xforever1313/commutertrackingsensornet/doc/pi_pinout.jpeg

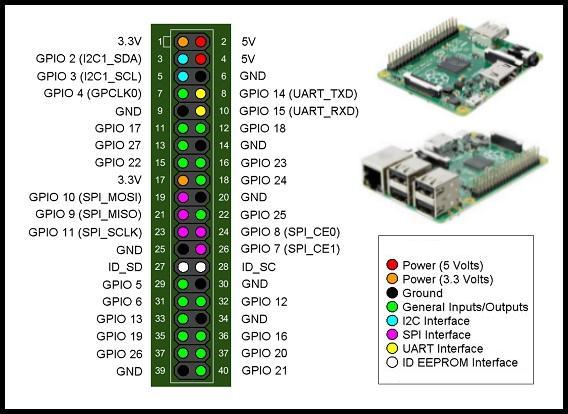
doc/pi_pinout.jpeg
