xforever1313/commutertrackingsensornet/README.md

# Commuter Tracking Sensor Net #

A wireless sensor network that will utilize computer vision and mesh networking will be used to track the usage of the Lehigh Valley trail. The network will be comprised of a series of modules that use image sensors to recognize commuters and their modes of transportation. Additionally these modules will communicate with one another to determine which entry and exit points commuters are using to access the trail. The network will have a gateway node that allows the data to be back-hauled to the internet. This data will then be stored via cloud storage and accessible via a web interface.

For more information, look in doc/CTSN_Final_report.pdf in this repo.

You can also visit our website: http://ctsn.shendrick.net/

Wiki with more information about how to build and configure things: https://bitbucket.org/xforever1313/commutertrackingsensornet/wiki/Home

You can also clone the wiki: git clone https://bitbucket.org/xforever1313/commutertrackingsensornet.git/wiki

If you are reading this from GitHub, please note that GitHub is only mirror that has the latest stable code that passed a nightly.  To view the working codebase, go to our BitBucket here: https://bitbucket.org/xforever1313/commutertrackingsensornet/
