xforever1313/commutertrackingsensornet/gateway/etc/readme.txt

Contains configurations for the raspberry Pi
