xforever1313/commutertrackingsensornet/CEwebsite/public/docs/mcu_camera.pdf

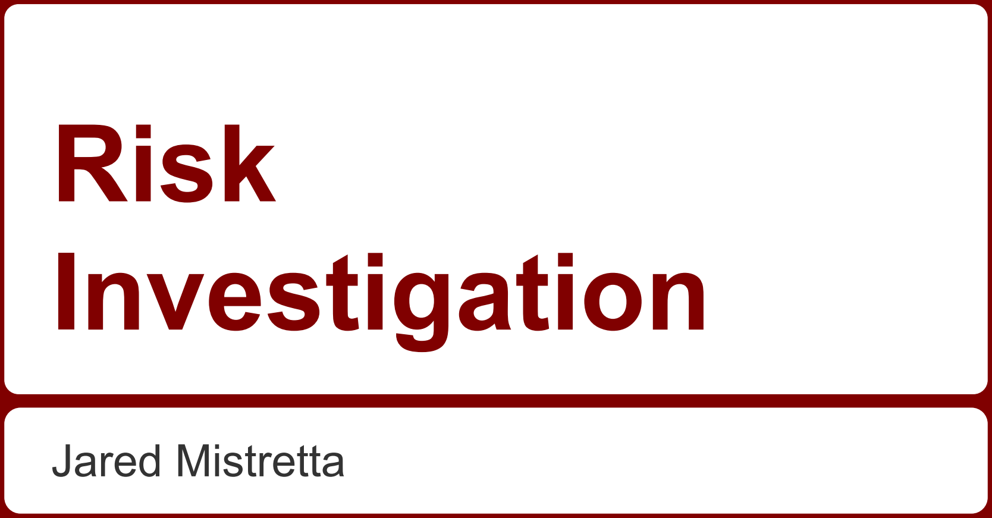
[picture p63: figure]
Risk Investigation; Jared Mistretta

### MCU and Camera Module

The MCU is the “brain” of the project. It serves as the main computational component as well as the controller for the peripheral and sub systems. We require the MCU to provide computer vision services as well.

The camera module will provide the visual data necessary for performing the CV.

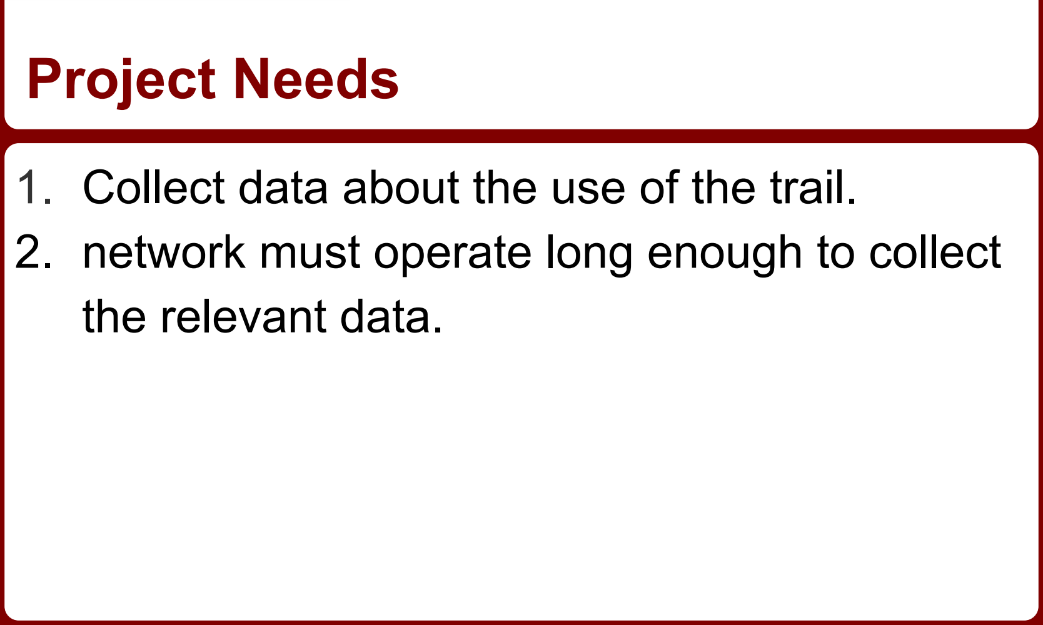
[picture p64: figure]
Project Needs; the relevant data.

1. Collect data about the use of the trail.
2. network must operate long enough to collect

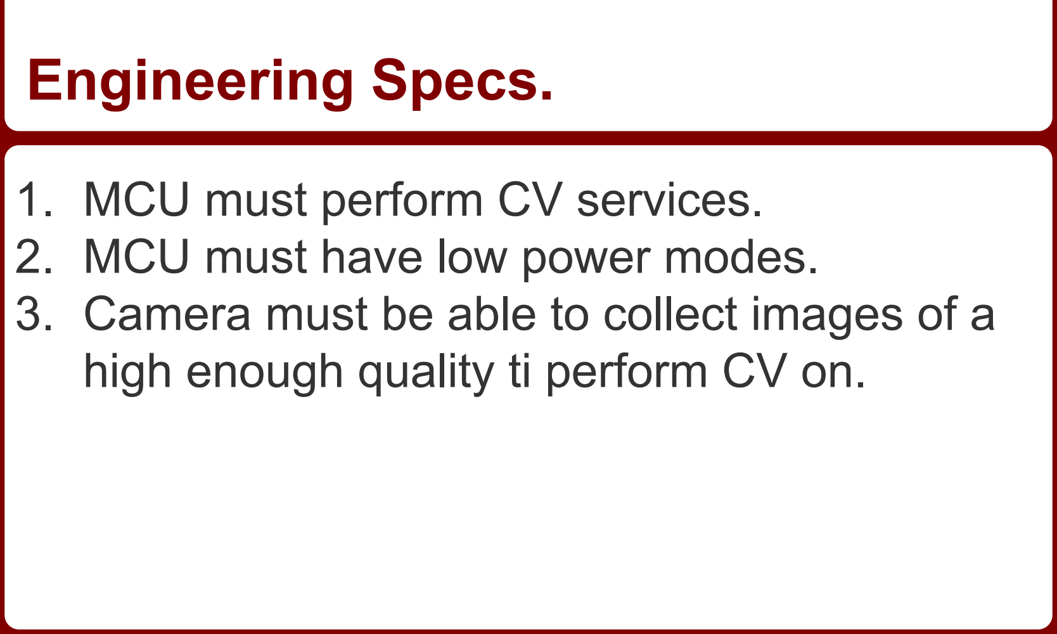
[picture p65: figure]
Engineering Specs.; 1. MCU must perform CV services. 2. MCU must have low power modes.; high enough quality ti perform CV on.

3. Camera must be able to collect images of a

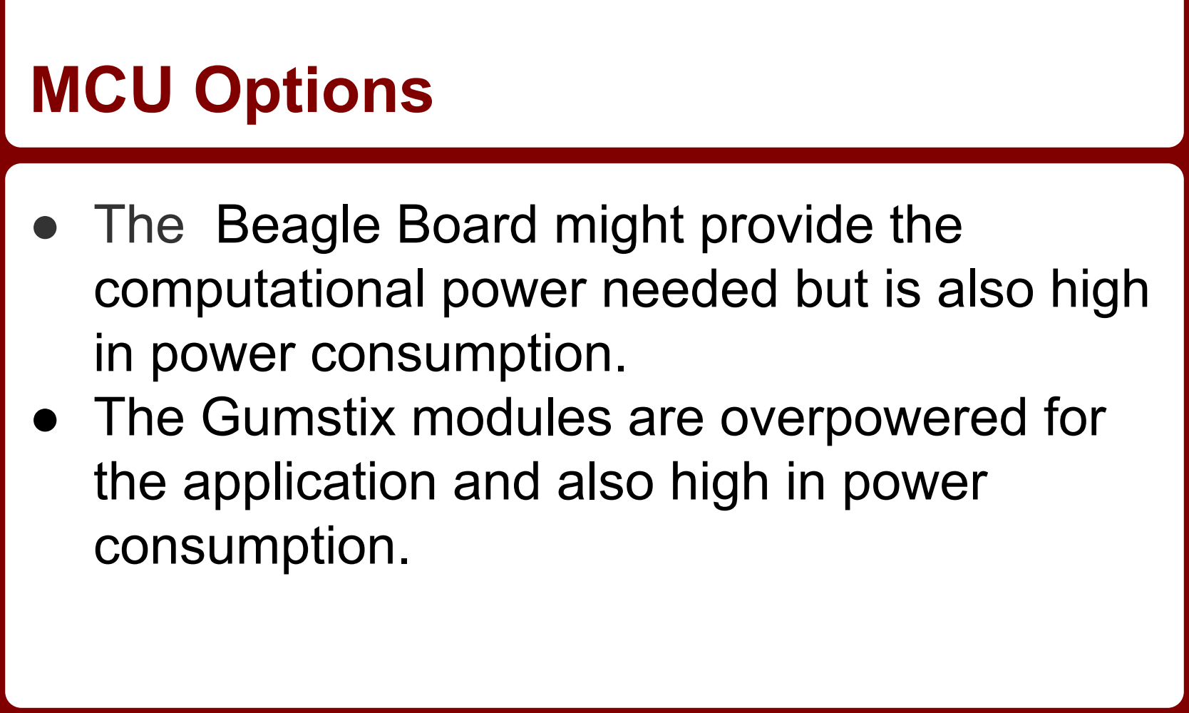
[picture p66: figure]
MCU Options; ● The Beagle Board might provide the; in power consumption.; the application and also high in power consumption.

computational power needed but is also high

- The Gumstix modules are overpowered for

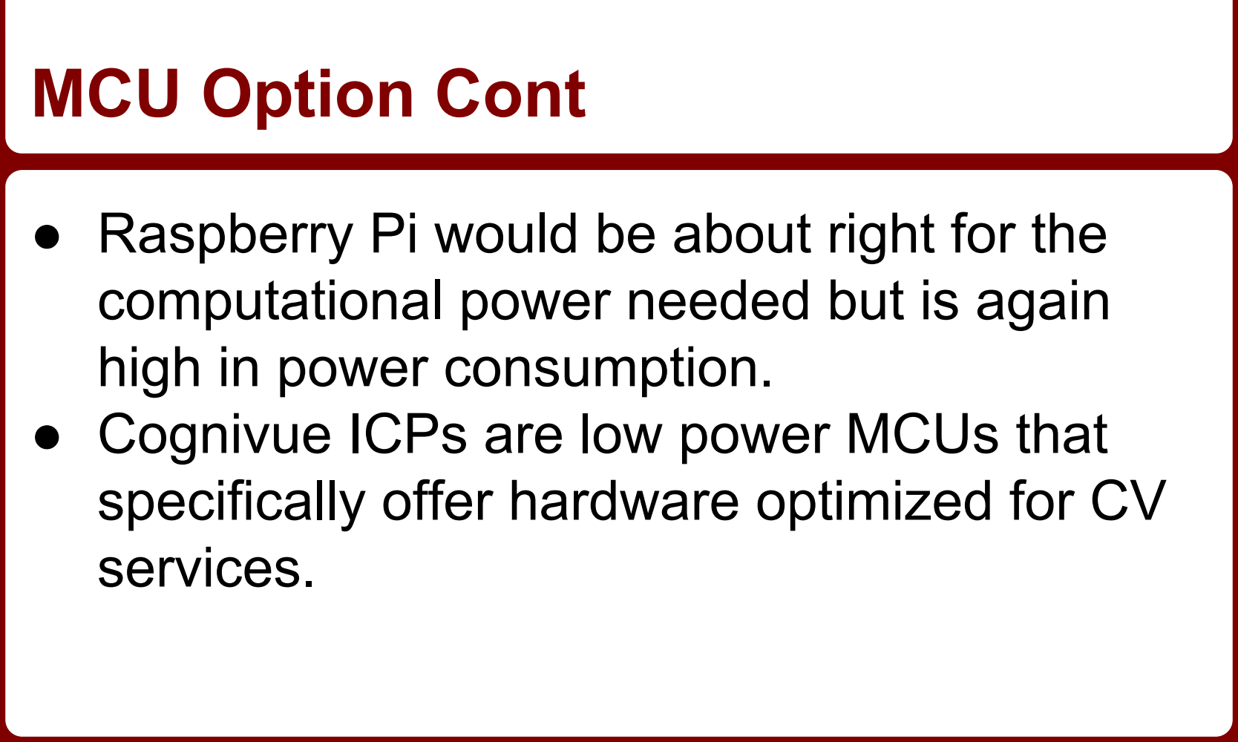
[picture p67: figure]
MCU Option Cont; computational power needed but is again high in power consumption. ● Cognivue ICPs are low power MCUs that; services.

- Raspberry Pi would be about right for the

specifically offer hardware optimized for CV

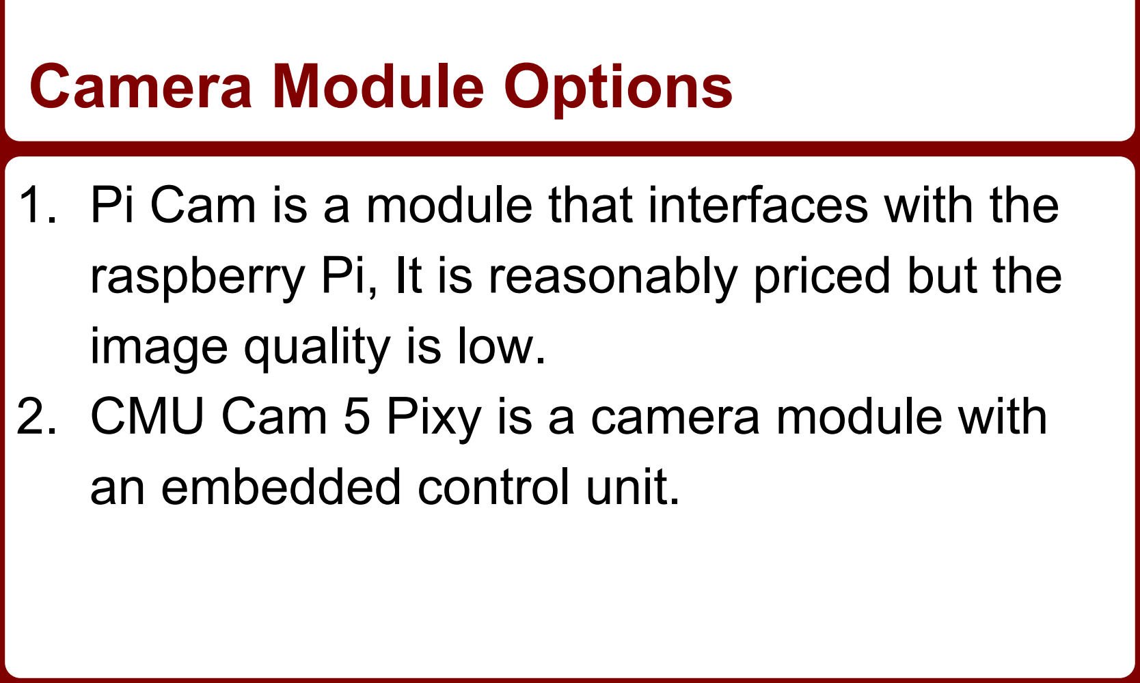
[picture p68: figure]
Camera Module Options; image quality is low.; an embedded control unit.

1. Pi Cam is a module that interfaces with the raspberry Pi, It is reasonably priced but the
2. CMU Cam 5 Pixy is a camera module with

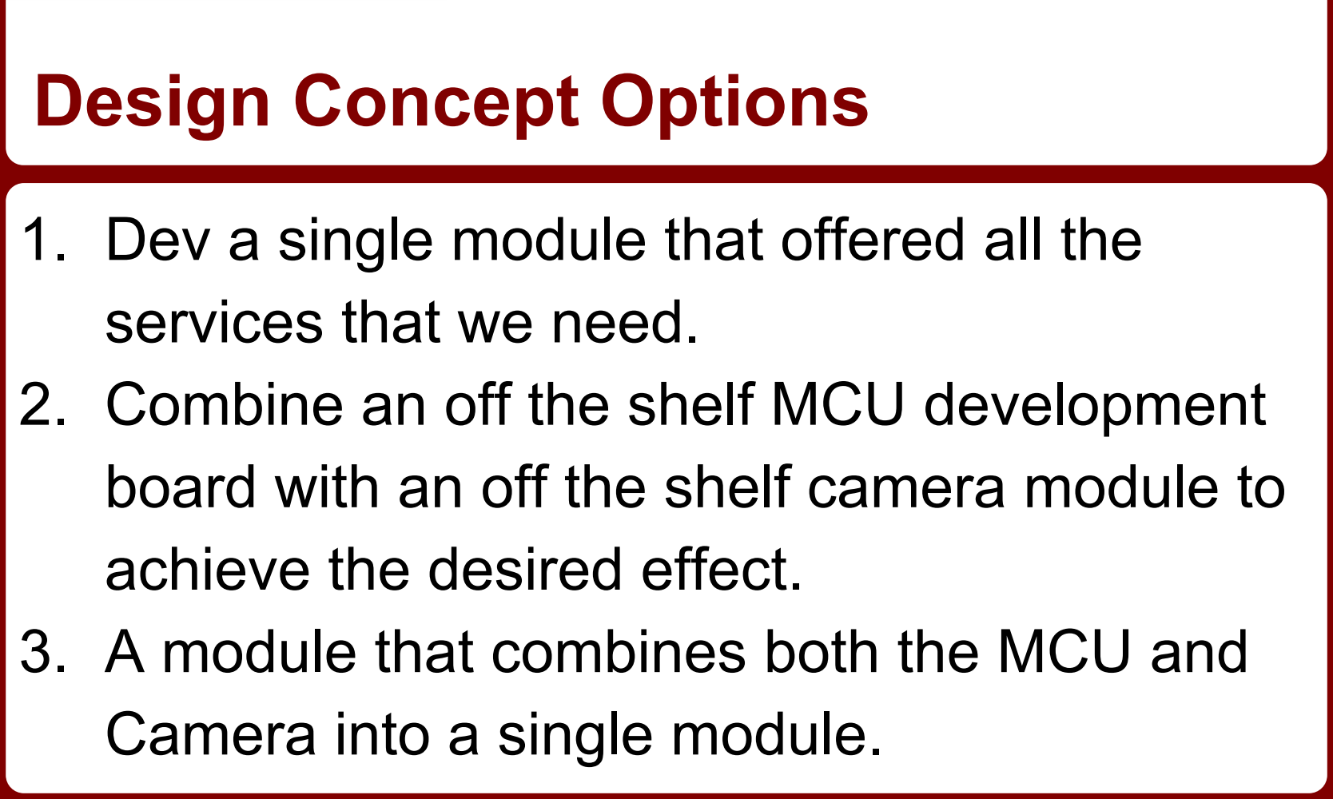
[picture p69: figure]
Design Concept Options; services that we need.; achieve the desired effect.; Camera into a single module.

1. Dev a single module that offered all the
2. Combine an off the shelf MCU development board with an off the shelf camera module to
3. A module that combines both the MCU and


CMUCam 5 Pixy

- Processor: NXP LPC4330, 204 MHz, dual core
- Image sensor: Omnivision OV9715, 1/4", 1280x800
- Lens field-of-view: 75 degrees horizontal, 47 degrees vertical
- Lens type: standard M12 (several different types available)
- Power consumption: 140 mA typical
- Power input: USB input (5V) or unregulated input (6V to 10V)
- RAM: 264K bytes
- Flash: 1M bytes
- Available data outputs: UART serial, SPI, I2C, USB, digital, analog
- Dimensions: 2.1" x 2.0" x 1.4
- Weight: 27 grams

### Technical Specs

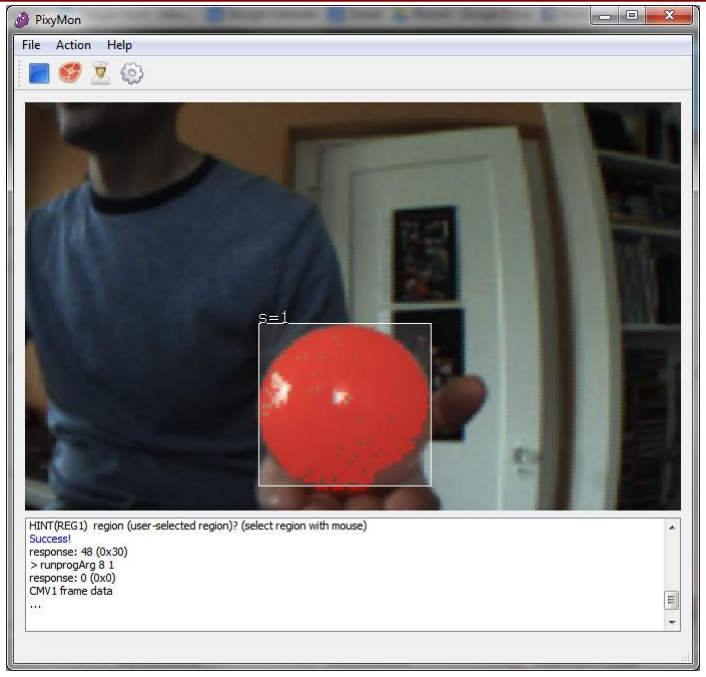
[picture p70: figure]

Computer Vision Tracking

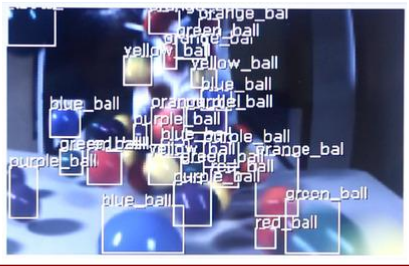
[picture p71: figure]

High Density Tracking
