xforever1313/commutertrackingsensornet/CEwebsite/public/docs/weekly11.pdf

# Commuter Tracking Sensor Network

Weekly Report November 9, 2014

Team Members:
Alex Sarra (ags7798@rit.edu) Seth Hendrick (srh7240@rit.edu) Jared Mistretta (jxm6666@rit.edu)

Other Collaborators:
Professor Wagner (mjwgse@rit.edu) (585) 475-5289 Nicholas Conn (nxc9827@rit.edu) Graduate Student Jared Stroud (jaredestroud@gmail.com) Security Major Stanley Chan (sxc4244@rit.edu) Security Major

Project Website:
Navigate to Google Drive Share (https://drive.google.com/folderview?id=0B4QNLbh8wjupal9wZDNRWTlsOEU&usp=sharing)

## Updated Milestone Chart

Milestone | Team Member in Charge | Modified Completion Date | Original Completion Date | Comments
1. Contact Monroe County Discuss deployment options for sensor nodes. | Jared | 11/11/2014 | 10/27/2014 | Pushed it back to deployment approach time.
2. Networking Architecture Configuration and Testing | | 10/13/2014 | 6/15/2014
2.1 Configure XBees for DigiMesh and have them communicating in close proximity | Seth, Jared | 10/16/2014 | 6/1/2014 | Done for now. Some additional configuration changes might need to be updated as more testing is done.
2.2 Range Test | Seth, Jared | 11/10/2014 | 6/9/2014 | Will be completed Monday or Wednesday. Rained out, and pushed back.
2.3 Smallscale trail deployment | Seth, Jared | 11/14/2014 | 6/15/2014 | Dependent on 2.1 and 2.2 and 5.2
3. Windbelt power module design | | 10/2/2014 | 6/18/2014

3.1 Breadboard
prototyping

Alex,
Jared | 11/12/2014 | 6/1/2014

Secondary Boost Converter
has been determined
inadequate for our power
needs. An EVM for the
secondary boost converter will need to be ordered soon to prototype with. Buck converter is pushing enough current for low power mode on the radio modules. To remedy this, we will need higherpower
inductors, which will be picked up soon to prototype with. The coilcraft ones on the PCB that was ordered will
mostcertainly be able to
transfer enough power
through the BQ module.
3.2 PCB design | Alex | 11/12/2014 | 6/10/2014 | COMPLETE (for now). The PCB design version 1 is complete and ordered. Continuing development with a version two that will allow us to slightly change the resistor dividers for OV and UV networks. For now, this is complete.
3.3 Ship design for stamping | Alex | 11/5/2014 | 6/18/2014 | COMPLETE First iteration of design is ordered. Parts for the board are known, and will be ordered within the weekend.

3.4 Spice Transient Analysis | Alex, Jared | 10/20/2014 | 9/22/2014 | COMPLETE Transient analysis is complete for both the buck and secondary boost converter. Levels are attainable for both the 6-10V unregulated (Pixy) and 3-3.3V regulated (XBee) ranges per transient simulations produced by TI's WEBDESIGN application.
4. Windbelt power module construction and testing | | 10/22/2014 | 6/30/2014
4.1 Solder on components | Alex | 11/21/2014 | 6/29/2014 | The PCB will be back by the 18th, which will give us enough time to solder on components.
4.2 Continuity tests | Alex | 11/24/2014 | 6/30/2014 | Dependent on 4.1, which should be met in time.
5. Server/Gateway setup | Seth | 10/10/2014 | 7/1/2014 | The server is a Raspberry Pi located at ctsn.student.rit.edu.
5.1 Install software (Django, Apache, etc.) | Seth | 6/21/2014 | 6/17/2014 | COMPLETE Apache, Django, MariaDB are installed and ready to go.
5.2 Interface XBee with Pi | Seth | 10/31/2014 | 7/1/2014 | COMPLETE Are able to Tx and Rx with the XBees between two pis.
5.3 Install and configure fail2ban | Seth | 9/1/2014 | 6/21/2014 | COMPLETE

6. Server/Gateway testing | | 10/12/2014 | 7/1/2014 | COMPLETE
6.1 Disable root login test | Seth | 6/21/2014 | 6/16/2014 | COMPLETE Done automatically when Raspbian was updated
6.2 Set the SSH port to a nonstandard port test | Seth | 6/21/2014 | 6/17/2014 | COMPLETE SSH Port is set to 1315, not the default port of 22
6.3 Disable password login test must log in with SSH key | Alex, Jared, Seth | 9/5/2014 | 6/21/2014 | COMPLETE SSH Keys are required to login to the server via SSH
6.4 White Hat Hacker Test | Seth | 10/12/2014 | 6/21/2014 | COMPLETE. They could not access the server via ssh, get a root shell, or access the database directly. Jared (security major) will be providing a formal report of the pen test results. We will be able to fortify security based on the results.
6.5 Ping disabled test | Seth, Security Majors | 10/31/2014 | 6/21/2014 | DEFERRED While the server is on the RIT campus, this is completed since outsiders can not ping rit.edu. If the server moves off campus for whatever reason, this will need to be revisited
7. Sensor hardware testing and integration | | 10/31/2014 | 7/11/2014

7.1 Begin playing with Pixy Cam in USB tethered mode | Jared, Alex, Seth | 7/11/2014 | 5/1/2014 | COMPLETE We've all experimented and interfaced with the PixyCam now, and familiarized ourselves with its basic operation.
7.2 Interface Pixy Cam with an XBee | Seth | 11/14/2014 | 6/22/2014 | Now that the "algorithm" is figured out after doing 5.2, this shouldn't take too long to plug into the Pixy Cam's firmware
7.3 Integrate with existing power module | Jared, Alex | 11/12/2014 | 7/11/2014 | Dependent on 3.1 and ordering and testing the EVM for the secondary boost converter.
8. Sensor Enclosure Design / Testing | | 11/14/2014 | 8/7/2014
8.1 Use CAD tools to design sensor enclosure | Jared | 11/14/2014 | 7/1/2014 | This is no longer blocked. This process can continue taking into account the largest board size available through the evaluation version of EAGLE. Jared currently working on CV, which is a higher priority task.
8.2 Use 3D printer to print the enclosures | Jared | 11/14/2014 | 7/15/2014 | 8.1 Must be done first
8.3 Test (See Gantt Chart) | Jared | 11/14/2014 | 8/7/2014 | Dependent on 8.2

9. Windbelt Testing (See Gantt Chart) | Alex | 11/11/2014 | 5/27/2014 | This can be completed at any point. Most likely, enough bandwidth will be available early this week. Up to now, a waveform generator that can provide the same Vave AC and the same frequency has been utilized.
10. Sensor Software Identify targets | | 10/24/2014 | 9/1/2014
10.1 Code Review for Pixy Software | Alex, Seth, Jared | 9/8/2014 | 9/8/2014 | COMPLETE Code review was completed. Information was documented regarding each file's contents.
10.2 Compile GCC version of Pixy software and note differences | | | 9/8/2014 | No longer a requirement. Keil will work just fine.
10.3 Train camera for identifying walkers, bikers, and horses | Jared | 11/14/2014 | 8/1/2014 | Attempting to get LibCCV compiling for the Pixy Cam. At the moment, it compiles, but it is having trouble linking in.
10.4 Train camera to figure out what direction the target is going | Jared | 11/14/2014 | 9/1/2014 | 10.3 and 10.4 are not dependent on one another. These two tasks should be completed in parallel.
11. Database Creation | | 9/23/2014 | 9/14/2014 | COMPLETE

11.1 Create mysql or mariadb database so data from trail can be saved to it | Seth | 11/5/2014 | 9/5/2014 | COMPLETE
12. Website Creation | | 9/26/2014 | 9/28/2014 | COMPLETE. Final website is located at https://ctsn.student.rit.edu
12.1 Create status webpage, hosted somewhere else | Seth | 9/5/2014 | 9/5/2014 | COMPLETE Status webpage that pings the gateway is functional. Its currently hosted on one of Seth's pis, located at http://people.rit.edu/~srh7240/ctsn_status .
12.2 Create web front end | Seth, Alex | 10/31/2014 | 9/14/2014 | Front end is COMPLETE. Data results from the CV algorithms must be identified and linked to the database to render on the webpage.
12.3 Link website to database | Seth | 11/5/2014 | 9/21/2014 | COMPLETE Website now no longer uses hardcoded values to display results.
13. Website Testing (See Gantt Chart) | Team | 10/12/2014 | 10/4/2014 | COMPLETE. Jared (security major) will be providing a formal report of the pen test results. We will be able to fortify security based on the results.
14. Target Data Communication | | 11/21/2014 | 10/5/2014

14.1 Sensors communicate target data with each other | Seth, Alex | 11/21/2014 | 10/4/2014 | Dependent on 7.2
14.2 Sensors can communicate and write target data to database | Seth | 11/21/2014 | 10/5/2014 | Gateway side is done. Only need to do the Pixy Cam side.
15. Computer Vision Testing (See Gantt Chart) | Alex, Seth | 11/1/2014 | 10/28/2014 | Dependent on 10.3 and 10.4
16. Deployment | | 11/17/2014 | 11/9/2014
16.1 Deploy nodes on trail | Team | 11/21/2014 | 11/5/2014
16.2 Activate website | Team | 9/27/2014 | 11/9/2014 | Complete. Website is located at http://ctsn.student.rit.edu (login required)
17.Integration Testing | | 11/13/2014
17.1 Advanced II integration testing with focus on single node in controlled environment | Team | 11/14/2014 | | Some of the integration testing will need to be completed with the prototype in place due to time constraints. Date adjusted due to change in prototyping timeframe.

17.2 Advanced II integration testing with focus on single node in an outdoor environment | Team | 11/19/2014 | Some of the integration testing will need to be completed with the prototype in place due to time constraints. Date adjusted due to change in prototyping timeframe.
17.3 Advanced II testing with focus on operation in outdoor environment for multiple nodes | Team | 11/21/2014 | Some of the integration testing will need to be completed with the prototype in place due to time constraints. Date adjusted due to change in prototyping timeframe.

## Current Milestones

Milestone

Team
Member
in Charge

Modified
Completion
Date

Original
Completion
Date

Comments

3.1 Breadboard
prototyping

Alex,
Jared | 11/12/2014 | 6/1/2014

Secondary Boost
Converter has been
determined inadequate for
our power needs. An EVM
for the secondary boost
converter will need to be
ordered soon to prototype
with. Buck converter is
pushing enough current for low power mode on the
radio modules. To remedy
this, we will need
higherpower inductors,
which will be picked up
soon to prototype with. The coilcraft ones on the PCB
that was ordered will
mostcertainly be able to
transfer enough power
through the BQ module.

3.2 PCB design

Alex | 11/12/2014 | 6/10/2014

COMPLETE (for now). The
PCB design version 1 is
complete and ordered.
Continuing development
with a version two that will allow us to slightly change the resistor dividers for OV and UV networks. For now,
this is complete.

3.3 Ship design for stamping | Alex | 11/5/2014 | 6/18/2014 | COMPLETE First iteration of design is ordered. Parts for the board are known, and will be ordered within the weekend.
10.3 Train camera for identifying walkers, bikers, and horses | Jared | 11/14/2014 | 8/1/2014 | Attempting to get LibCCV compiling for the Pixy Cam. At the moment, it compiles, but it is having trouble linking in.
10.4 Train camera to figure out what direction the target is going | Jared | 11/14/2014 | 9/1/2014 | 10.3 and 10.4 are not dependent on one another. These two tasks should be completed in parallel.
11.1 Create mysql or mariadb database so data from trail can be saved to it | Seth | 11/5/2014 | 9/5/2014 | COMPLETE
12.3 Link website to database | Seth | 11/5/2014 | 9/21/2014 | COMPLETE Website now no longer uses hardcoded values to display results.
14.2 Sensors can communicate and write target data to database | Seth | 11/21/2014 | 10/5/2014 | Gateway side is done. Only need to do the Pixy Cam side.

## Next Milestones

2.2 Range Test | Seth, Jared | 11/10/2014 | 6/9/2014 | Will be completed Monday or Wednesday. Rained out, and pushed back.
2.3 Smallscale trail deployment | Seth, Jared | 11/14/2014 | 6/15/2014 | Dependent on 2.1 and 2.2 and 5.2

3.1 Breadboard prototyping

Alex,
Jared | 11/12/2014 | 6/1/2014

Secondary Boost
Converter has been
determined inadequate for
our power needs. An EVM
for the secondary boost
converter will need to be
ordered soon to prototype
with. Buck converter is
pushing enough current for low power mode on the
radio modules. To remedy
this, we will need
higherpower inductors,
which will be picked up
soon to prototype with. The coilcraft ones on the PCB
that was ordered will
mostcertainly be able to
transfer enough power
through the BQ module.
10.3 Train camera for identifying walkers, bikers, and horses | Jared | 11/14/2014 | 8/1/2014 | Attempting to get LibCCV compiling for the Pixy Cam. At the moment, it compiles, but it is having trouble linking in.
10.4 Train camera to figure out what direction the target is going | Jared | 11/14/2014 | 9/1/2014 | 10.3 and 10.4 are not dependent on one another. These two tasks should be completed in parallel.

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
d II integration testing
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
e in
c

o

n

t

r

olle

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
e in

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
will n

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
e in

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
s. D

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
e in
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
## Status

### Difficulties

Getting libccv to compile for the pixy cam is very difficult. We were able to compile libccv to a static library, but Keil is apparently not smart enough to link it in (nor does it provide an easy way to do it). We might consider trying a makefile or an SConstruct.
The EAGLE components for the Coilcraft inductor and TI BQ25504 caused DRC errors in the schematic, due to OSH Parks fabrication limitations. These DRC errors were false positives, and were ignored.

### Surprises

Cam files were very easy to create once the PCB design was complete. As easy as pressing a button. Also, since OSH Park does not require the use of CAM files, they were made simply to be able to inspect the completed board prior to design submission.

### Successes

Website now uses https, so it is more secure than it was before. It will also lock out users who fail to login after 5 attempts, and has a captcha to prevent brute forcing. The website will popup an “unsecure connection” warning, but thats only because we selfsigned our ssl certificate since a “real” one isn’t cheap.
The gateway now has code that will take in commands from the trail nodes, and execute them. This means that right now, we can send data from a trail node, to the gateway, to the database, and finally to the website. This was done between two Raspberry Pis. The last challenge is to get it working with the Pixy Cam.
The PCB design for the BQ25504 is complete. The hope is that the higher power inductor and larger planes and wider traces will allow for more current to be transmitted through the boost converter and into the secondary modules.

### Open Questions and Concerns

None this week.

### Gantt Chart

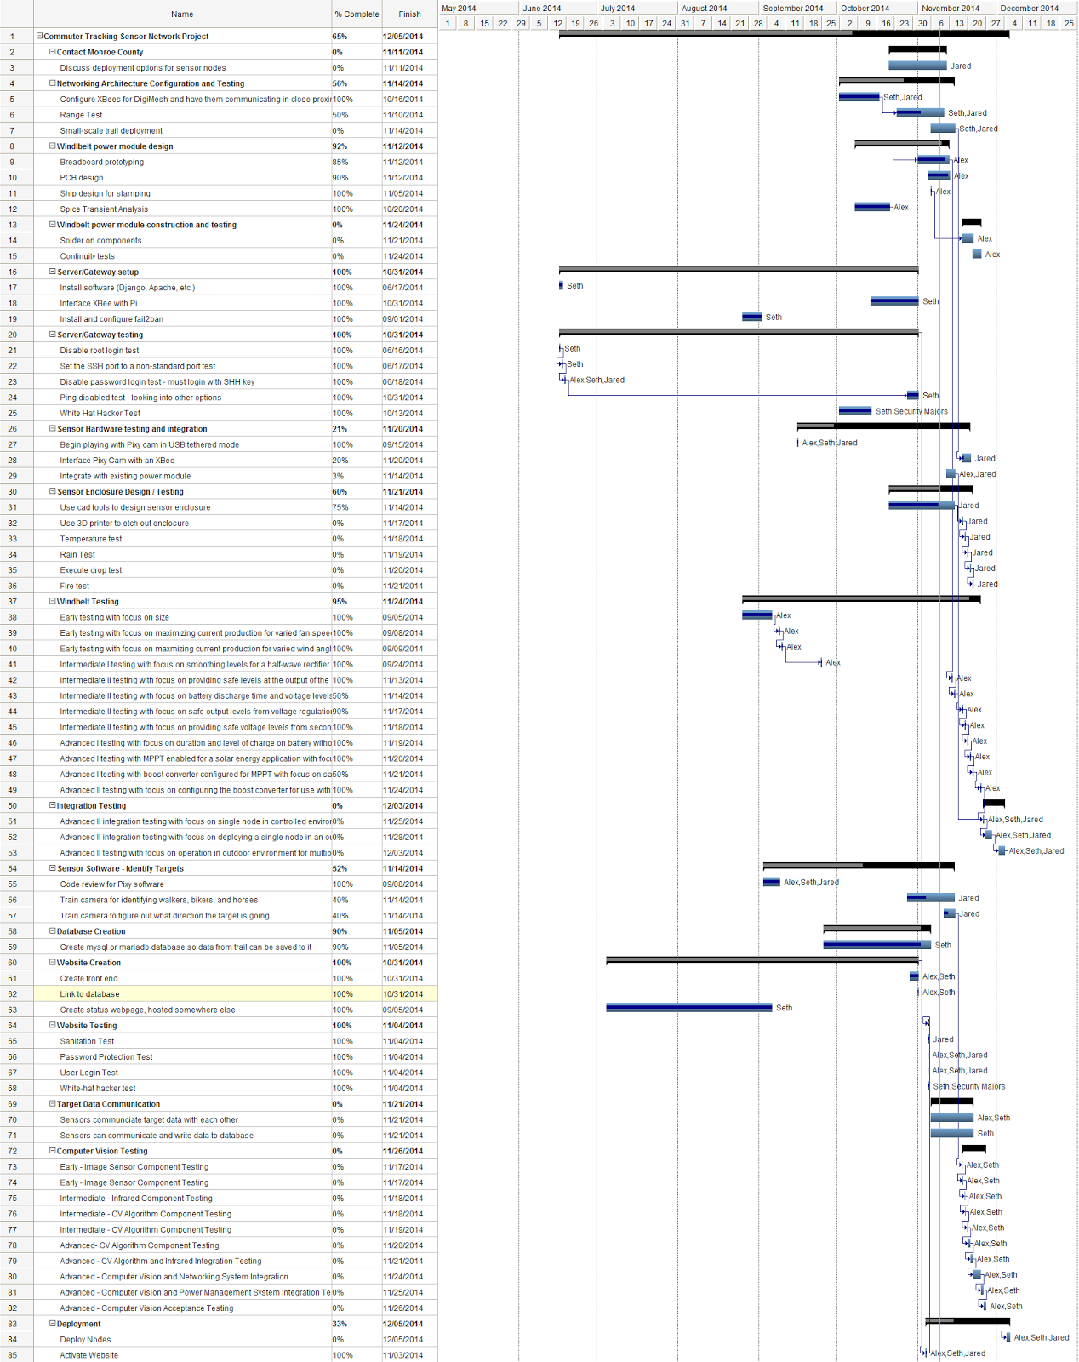
[picture p74: figure]
