xforever1313/commutertrackingsensornet/CEwebsite/public/docs/weekly12.pdf

# Commuter Tracking Sensor Network

Weekly Report November 16, 2014

Team Members:
Alex Sarra (ags7798@rit.edu) Seth Hendrick (srh7240@rit.edu) Jared Mistretta (jxm6666@rit.edu)

Other Collaborators:
Professor Wagner (mjwgse@rit.edu) (585) 475-5289 Nicholas Conn (nxc9827@rit.edu) Graduate Student Jared Stroud (jaredestroud@gmail.com) Security Major Stanley Chan (sxc4244@rit.edu) Security Major

Project Website:
Navigate to Google Drive Share (https://drive.google.com/folderview?id=0B4QNLbh8wjupal9wZDNRWTlsOEU&usp=sharing)

## Updated Milestone Chart

Milestone | Team Member in Charge | Modified Completion Date | Original Completion Date | Comments
1. Contact Monroe County Discuss deployment options for sensor nodes. | Jared | 11/25/2014 | 10/27/2014 | Pushed back. Not a priority at this time.
2. Networking Architecture Configuration and Testing | | 10/13/2014 | 6/15/2014
2.1 Configure XBees for DigiMesh and have them communicating in close proximity | Seth, Jared | 10/16/2014 | 6/1/2014 | Done for now. Some additional configuration changes might need to be updated as more testing is done.
2.2 Range Test | Seth, Jared | 11/17/2014 | 6/9/2014 | Will be completed Monday or Wednesday. Snowed out, and pushed back.
2.3 Smallscale trail deployment | Seth, Jared | 11/19/2014 | 6/15/2014 | Dependent on 2.1 and 2.2 and 5.2
3. Windbelt power module design | | 10/2/2014 | 6/18/2014

3.1 Breadboard
prototyping

Alex,
Jared | 11/21/2014 | 6/1/2014

Breadboard prototyping is
almost complete. A
secondary boost converter
has been identified that will meet our power needs for the CMUCam
(TPS61032EVM-208). The
EVM has been ordered for
prototyping, and should arrive within the week. The due
date has been adjusted to
allow for shipping and test time. The boost converter in series with the
buckconverter is now
adequately supporting a
222mA load. Stress tests
also show that it can handle a sequence of 1000 Tx bursts separated in 10 minute
intervals. Equivalent load resistance has been added in parallel with the radio to simulate the CMUCam.

3.2 PCB design

Alex | 11/26/2014 | 6/10/2014

COMPLETE (for now). Jeff
Lonneville in SIMS has
agreed to assist with the PCB reflow soldering through use of RIT facilities. He will be returning from a trip to
Washington the week of the 23rd, and will be able to
assist either Monday or
Tuesday of that week. In the meantime, the 3x PCBs are
scheduled to arrive on the 18th, and all SMT parts have been ordered.
3.3 Ship design for stamping | Alex | 11/5/2014 | 6/18/2014 | COMPLETE First iteration of design is ordered. Parts for the board are known, and will be ordered within the weekend. Future iterations of design will merge the EVM functionality to the custom design.
3.4 Spice Transient Analysis | Alex, Jared | 10/20/2014 | 9/22/2014 | COMPLETE Transient analysis is complete for both the buck and secondary boost converter. Levels are attainable for both the 6-10V unregulated (Pixy) and 3-3.3V regulated (XBee) ranges per transient simulations produced by TI's WEBDESIGN application.
4. Windbelt power module construction and testing | | 10/22/2014 | 6/30/2014

4.1 Solder on components | Alex | 11/26/2014 | 6/29/2014 | Components are ordered and the custom PCB is in arrival.
4.2 Continuity tests | Alex | 11/26/2014 | 6/30/2014 | Dependent on 4.1.
5. Server/Gateway setup | Seth | 10/10/2014 | 7/1/2014 | The server is a Raspberry Pi located at ctsn.student.rit.edu.
5.1 Install software (Django, Apache, etc.) | Seth | 6/21/2014 | 6/17/2014 | COMPLETE Apache, Django, MariaDB are installed and ready to go.
5.2 Interface XBee with Pi | Seth | 10/31/2014 | 7/1/2014 | COMPLETE Are able to Tx and Rx with the XBees between two pis.
5.3 Install and configure fail2ban | Seth | 9/1/2014 | 6/21/2014 | COMPLETE
6. Server/Gateway testing | | 10/12/2014 | 7/1/2014 | COMPLETE
6.1 Disable root login test | Seth | 6/21/2014 | 6/16/2014 | COMPLETE Done automatically when Raspbian was updated
6.2 Set the SSH port to a nonstandard port test | Seth | 6/21/2014 | 6/17/2014 | COMPLETE SSH Port is set to 1315, not the default port of 22
6.3 Disable password login test must log in with SSH key | Alex, Jared, Seth | 9/5/2014 | 6/21/2014 | COMPLETE SSH Keys are required to login to the server via SSH

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

7.3 Integrate with existing power module | Jared, Alex | 11/21/2014 | 7/11/2014 | Secondary boost converter will be in this week, and will most likely work when plugged in, allowing for completion of this task.
8. Sensor Enclosure Design / Testing | | 11/14/2014 | 8/7/2014
8.1 Use CAD tools to design sensor enclosure | Jared | 11/21/2014 | 7/1/2014 | Pushed back due to prioritizing of tasks. CV algorithm is taking precedence, but printing of enclosure should be complete by end of week per Jared.
8.2 Use 3D printer to print the enclosures | Jared | 11/21/2014 | 7/15/2014 | 8.1 Must be done first
8.3 Test (See Gantt Chart) | Jared | 11/25/2014 | 8/7/2014 | Dependent on 8.2
9. Windbelt Testing (See Gantt Chart) | Alex | 11/21/2014 | 5/27/2014 | This is almost complete. The only thing that remains is to test both the secondary boost and buck converters with a load attached with and without the sustainable source and the battery connected.
10. Sensor Software Identify targets | | 10/24/2014 | 9/1/2014

10.1 Code Review for Pixy Software | Alex, Seth, Jared | 9/8/2014 | 9/8/2014 | COMPLETE Code review was completed. Information was documented regarding each file's contents.
10.2 Compile GCC version of Pixy software and note differences | | | 9/8/2014 | No longer a requirement. Keil will work just fine.

10.3 Train camera for
identifying walkers,
bikers, and horses
Jared | 11/24/2014 | 8/1/2014

The PixyCam does not
currently have enough
onboard memory to store the CV program, and manipulate incoming data. To remedy
this, raw data will be sent through the network to the main hub, and then offloaded to a connected desktop
computer where the CV
algorithm will be performed. In this manner, we will be able to utilize the OS for certain CV dependencies
rather than attempting to
circumvent these
dependencies.

10.4 Train camera to
figure out what
direction the target is
going
Jared | 11/24/2014 | 9/1/2014

The PixyCam does not
currently have enough
onboard memory to store the CV program, and manipulate incoming data. To remedy
this, raw data will be sent through the network to the main hub, and then offloaded to a connected desktop
computer where the CV
algorithm will be performed. In this manner, we will be able to utilize the OS for certain CV dependencies
rather than attempting to
circumvent these
dependencies.
11. Database Creation | | 9/23/2014 | 9/14/2014 | COMPLETE
11.1 Create mysql or mariadb database so data from trail can be saved to it | Seth | 11/5/2014 | 9/5/2014 | COMPLETE
12. Website Creation | | 9/26/2014 | 9/28/2014 | COMPLETE. Final website is located at https://ctsn.student.rit.edu
12.1 Create status webpage, hosted somewhere else | Seth | 9/5/2014 | 9/5/2014 | COMPLETE Status webpage that pings the gateway is functional. Its currently hosted on one of Seth's pis, located at http://people.rit.edu/~srh7240/ctsn_status .

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

16.1 Deploy nodes on trail | Team | 12/2/2014 | 11/5/2014 | Adjusted to meet new hard deadline of the Tuesday after Thanksgiving break.
16.2 Activate website | Team | 9/27/2014 | 11/9/2014 | Complete. Website is located at http://ctsn.student.rit.edu (login required)
17.Integration Testing | | 11/13/2014
17.1 Advanced II integration testing with focus on single node in controlled environment | Team | 11/21/2014 | | Some of the integration testing will need to be completed with the prototype in place due to time constraints. Date adjusted due to change in prototyping timeframe.
17.2 Advanced II integration testing with focus on single node in an outdoor environment | Team | 11/24/2014 | | Some of the integration testing will need to be completed with the prototype in place due to time constraints. Date adjusted due to change in prototyping timeframe.
17.3 Advanced II testing with focus on operation in outdoor environment for multiple nodes | Team | 11/25/2014 | | Some of the integration testing will need to be completed with the prototype in place due to time constraints. Date adjusted due to change in prototyping timeframe.

## Current Milestones

Milestone

Team
Member
in
Charge

Modified
Completion
Date

Original
Completion
Date

Comments

3.1 Breadboard
prototyping

Alex,
Jared | 11/21/2014 | 6/1/2014

Breadboard prototyping is
almost complete. A
secondary boost converter
has been identified that will meet our power needs for the CMUCam
(TPS61032EVM-208). The
EVM has been ordered for
prototyping, and should
arrive within the week. The due date has been adjusted to allow for shipping and test time. The boost converter in series with the
buckconverter is now
adequately supporting a
222mA load. Stress tests
also show that it can handle a sequence of 1000 Tx
bursts separated in 10
minute intervals. Equivalent load resistance has been
added in parallel with the radio to simulate the
CMUCam.

10.3 Train camera for
identifying walkers,
bikers, and horses
Jared | 11/24/2014 | 8/1/2014

The PixyCam does not
currently have enough
onboard memory to store
the CV program, and
manipulate incoming data. To remedy this, raw data will be sent through the network to the main hub, and then
offloaded to a connected
desktop computer where the CV algorithm will be
performed. In this manner, we will be able to utilize the OS for certain CV
dependencies rather than
attempting to circumvent
these dependencies.

10.4 Train camera to
figure out what
direction the target is
going
Jared | 11/24/2014 | 9/1/2014

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

## Next Milestones

2.2 Range Test | Seth, Jared | 11/17/2014 | 6/9/2014 | Will be completed Monday or Wednesday. Snowed out, and pushed back.
2.3 Smallscale trail deployment | Seth, Jared | 11/19/2014 | 6/15/2014 | Dependent on 2.1 and 2.2 and 5.2
7.2 Interface Pixy Cam with an XBee | Seth | 11/14/2014 | 6/22/2014 | Now that the "algorithm" is figured out after doing 5.2, this shouldn't take too long to plug into the Pixy Cam's firmware
7.3 Integrate with existing power module | Jared, Alex | 11/21/2014 | 7/11/2014 | Secondary boost converter will be in this week, and will most likely work when plugged in, allowing for completion of this task.

10.3 Train camera for
identifying walkers, bikers, and horses
Jared | 11/24/2014 | 8/1/2014

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

10.4 Train camera to figure out what direction the
target is going
Jared | 11/24/2014 | 9/1/2014

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

## Status

### Difficulties

The waveform generators caused a difficulty with powering the battery management system properly. They have a ‘sweep’ mode which caused a bit of confusion related to proper chip configuration. Once this issue was sorted out, the BQ25504 was once again operating correctly.
The Pixy Cam does not have enough onboard memory for the CV algorithm we want to use. We have decided to change the plan from doing the CV on board to having the Pixy Cams send the images encrypted over the network to the Gateway Node. The Gateway Node will then send the image to a desktop on the same network which will do the processing for us. Privacy is still not an issue since the XBees are encrypted.

### Surprises

The stepdown converter has a connection for both load and a microcontroller. This may be useful in later stages of the project.

### Successes

The stepdown converter can handle a consistent 222 mA (18 ohm load). When the XBee is connected, it can transmit 1000 successive bursts over 10 minute intervals with about a 5% error rate.
Parts for the PCB have been ordered, and Jeff Lonneville has agreed to work Alex to solder them to the board. The board is due to arrive by the 18th, and the parts shortly thereafter. Jeff will be available to help solder the following week (the 24th), so there will be time for testing through break week.
The gateway node can now receive status updates from the trail nodes, and update the database accordingly. If a trail node does not notify the gateway node of its status within an hour, the gateway node will notify all admins that the node has an unknown status. Meanwhile, if a node has a low battery, it can notify the gateway node, and the gateway node will notify the admins, and update the database as needed.

### Open Questions and Concerns

None at this time.

### Gantt Chart

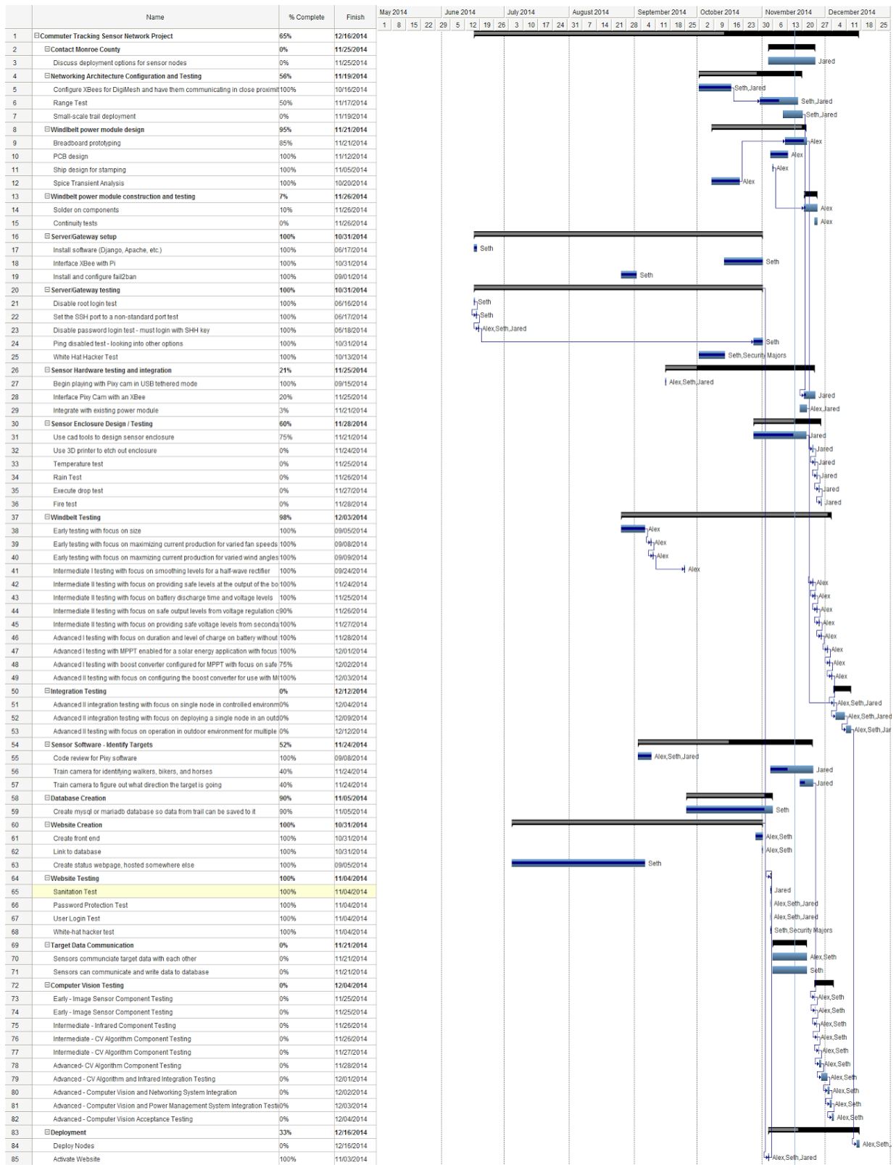
[picture p75: figure]
