xforever1313/commutertrackingsensornet/CEwebsite/public/docs/weekly5.pdf

# Commuter Tracking Sensor Network

Weekly Report September 28th, 2014

Team Members:
Alex Sarra (ags7798@rit.edu) Seth Hendrick (srh7240@rit.edu) Jared Mistretta (jxm6666@rit.edu)

Other Collaborators:
Professor Wagner (mjwgse@rit.edu) (585) 475-5289

Project Website:
Navigate to Google Drive Share (https://drive.google.com/folderview?id=0B4QNLbh8wjupal9wZDNRWTlsOEU&usp=sharing)

## Updated Milestone Chart

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

10.1 Code Review for Pixy Software | Alex, Seth, Jared | 9/8/2014 | 9/8/2014 | COMPLETE Code review was completed. Information was documented regarding each file's contents.
11. Database Creation | | 9/23/2014 | 9/14/2014
11.1 Create mysql or mariadb database so data from trail can be saved to it | Seth | 9/23/2014 | 9/5/2014 | Done for now. There will probably need to be some work done once the nodes need to save data to the database.
12.3 Link website to database | Seth | 9/23/2014 | 9/21/2014 | Done for now. There will probably need to be some work done once the nodes need to save data to the database.

3.4 Spice
Transient Analysis

Alex,
Jared | 9/24/2014 | 9/22/2014

Simulations are complete for the time being. This process could be extended for analysis of the secondary boost
converter output, however, memory issues with OrCad are limiting use of the program. Results show that a 1.25V
amplitude rectified DC signal (pulsating) can provide a 4.1V DC steady signal at the output of the boost converter, providing our Li-Ion battery with the necessary power to trickle charge.

### 12. Website

Creation

9/26/2014 9/28/2014

Front end is complete, but there may need to be some work
done on the backend
downtheroad when nodes
need to send data to the
database

12.2 Create web front end | Seth, Alex | 9/26/2014 | 9/14/2014 | Front end is complete. There may need to be some backend work down the road when the nodes need to save data to the database.
16.2 Activate website | Team | 9/27/2014 | 11/9/2014 | Complete. Website is located at http://ctsn.student.rit.edu:1415 (login required)
13. Website Testing (See Gantt Chart) | Team | 9/30/2014 | 10/4/2014
3.1 Breadboard prototyping | Alex, Jared | 10/1/2014 | 6/1/2014 | No longer blocked. We can begin work with prototyping the boost converter. Our contact, Nick Conn, has agreed to provide us with the equipment we need to solder the bq qfn chip to a DIP converter. Jared is currently creating a stencil for the QFN to dip converter so that we can accurately apply solder paste to the pads. Once complete, we will be able to test the bq hardware on the breadboard.
6.4 White Hat Hacker Test | Seth | 10/1/2014 | 6/21/2014 | Found volunteers to pen test the server. Since the website is mostly complete, we will begin testing.
3. Windbelt power module design | | 10/2/2014 | 6/18/2014
3.2 PCB design | Alex | 10/6/2014 | 6/10/2014 | Progress can continue with this, since an evaluation module layout has been researched, and parts for each resistor configuration have been

| | | | determined through simulation. Also, pricing for stamping through OSHPark has been researched, and they charge $5 per square inch. With a limited board size of 4 x 3.2 inches due to use of Eagle Freeware, and a limitation of 2 sided boards, the price is maxed at $64 per board.
5. Server/Gateway setup | Seth | 10/6/2014 | 7/1/2014 | The server is a Raspberry Pi located at ctsn.student.rit.edu.
5.2 Interface XBee with Pi | Seth | 10/6/2014 | 7/1/2014 | Ordering new antennas for the XBees as the parts ordered have proprietary connectors.
6. Server/Gateway testing | | 10/6/2014 | 7/1/2014 | Found volunteers to try to hack the server.
2.1 Configure XBees for DigiMesh and have them communicating in close proximity | Seth, Jared | 10/7/2014 | 6/1/2014
2.2 Range Test | Seth, Jared | 10/9/2014 | 6/9/2014
8.1 Use CAD tools to design sensor enclosure | Jared | 10/10/2014 | 7/1/2014 | This can continue with the maximum values for board size taken into account, which is 4 x 3.2 inches. We will most likely need this size board to fit all of the resistor configurations for the boost converters, along with other peripherals.

7.2 Interface Pixy Cam with an XBee | Jared, Alex | 10/10/2014 | 6/22/2014 | Antennas need to be ordered still.
2. Networking Architecture Configuration and Testing | | 10/13/2014 | 6/15/2014 | Soldered the xbee usb programmer and downloaded the program that will help program the XBees
2.3 Smallscale trail deployment | Seth, Jared | 10/13/2014 | 6/15/2014
14.1 Sensors communicate target data with each other | Seth, Alex | 10/14/2014 | 10/4/2014
10.3 Train camera for identifying walkers, bikers, and horses | Seth | 10/15/2014 | 8/1/2014 | Algorithms researched and added to project database. Continuing research. Jared will be moving to assist with hardware, and Seth will continue with this after finishing the website (hence the date change).
8.2 Use 3D printer to print the enclosures | Jared | 10/15/2014 | 7/15/2014 | 8.1 Must be done first
3.3 Ship design for stamping | Alex | 10/17/2014 | 6/18/2014 | 3.2 Must be completed first
4.1 Solder on components | Alex | 10/20/2014 | 6/29/2014 | 3.3 Must be completed first
4. Windbelt power module construction and testing | | 10/22/2014 | 6/30/2014
4.2 Continuity tests | Alex | 10/22/2014 | 6/30/2014 | 4.1 Must be completed first

8. Sensor Enclosure Design / Testing | | 10/22/2014 | 8/7/2014
8.3 Test (See Gantt Chart) | Jared | 10/22/2014 | 8/7/2014 | Dependent on 8.2
10. Sensor Software Identify targets | | 10/24/2014 | 9/1/2014
10.4 Train camera to figure out what direction the target is going | Jared | 10/24/2014 | 9/1/2014 | 10.3 Must be done first
1. Contact Monroe County Discuss deployment options for sensor nodes. | Jared | 10/28/2014 | 10/27/2014 | Not a priority until we complete more of the technical requirments.
14. Target Data Communication | | 10/28/2014 | 10/5/2014
14.2 Sensors can communicate and write target data to database | Seth | 10/28/2014 | 10/5/2014
6.5 Ping disabled test | Seth, Security Majors | 10/31/2014 | 6/21/2014 | DEFERRED While the server is on the RIT campus, this is completed since outsiders can not ping rit.edu. If the server moves of campus for whatever reason, this will need to be revisited
10.2 Compile GCC version of Pixy software and note differences | Seth | 10/31/2014 | 9/8/2014 | DEFERRED According to the pixy cam developers, GCC version is not ready to use yet. That’s fine though, we can use Keil instead.

7. Sensor hardware testing and integration | | 10/31/2014 | 7/11/2014
7.3 Integrate with existing power module | Jared, Alex | 10/31/2014 | 7/11/2014 | Will be done upon completion of the power module.
15. Computer Vision Testing (See Gantt Chart) | Alex, Seth | 11/1/2014 | 10/28/2014
9. Windbelt Testing (See Gantt Chart) | Alex | 11/5/2014 | 5/27/2014 | No longer blocked. Continuing testing of Windbelt with natural wind speeds, angles, and variation to measure efficiency over a period of time. Test data will be captured using a BeagleBone Black, and data will be sent to the server to test the database and website response. Once the QFN to DIP module is soldered (due to happen this week), testing can continue with the Windbelt connected to the bq device.
17.1 Advanced II integration testing with focus on single node in controlled environment | Team | 11/5/2014
17.2 Advanced II integration testing with focus on single node in an outdoor environment | Team | 11/10/2014
17.Integration Testing | | 11/13/2014

17.3 Advanced II testing with focus on operation in outdoor environment for multiple nodes | Team | 11/13/2014
16. Deployment | | 11/17/2014 | 11/9/2014
16.1 Deploy nodes on trail | Team | 11/17/2014 | 11/5/2014

## Current Milestones

Milestone | Team Member in Charge | Modified Completion Date | Original Completion Date | Comments
11.1 Create mysql or mariadb database so data from trail can be saved to it | Seth | 9/23/2014 | 9/5/2014 | Done for now. There will probably need to be some work done once the nodes need to save data to the database.
12.3 Link website to database | Seth | 9/23/2014 | 9/21/2014 | Done for now. There will probably need to be some work done once the nodes need to save data to the database.
3.4 Spice Transient Analysis | Alex, Jared | 9/24/2014 | 9/22/2014 | Simulations are complete for the time being. This process could be extended for analysis of the secondary boost converter output, however, memory issues with OrCad are limiting use of the program. Results show that a 1.25V amplitude rectified DC signal (pulsating) can provide a 4.1V DC steady signal at the output of the boost converter, providing our Li-Ion battery with the necessary power to trickle charge.
12.2 Create web front end | Seth, Alex | 9/26/2014 | 9/14/2014 | Front end is complete. There may need to be some backend work down the road when the nodes need to save data to the database.

16.2 Activate website | Team | 9/27/2014 | 11/9/2014 | Complete. Website is located at http://ctsn.student.rit.edu:1415 (login required)
3.1 Breadboard prototyping | Alex, Jared | 10/1/2014 | 6/1/2014 | No longer blocked. We can begin work with prototyping the boost converter. Our contact, Nick Conn, has agreed to provide us with the equipment we need to solder the bq qfn chip to a DIP converter. Jared is currently creating a stencil for the QFN to dip converter so that we can accurately apply solder paste to the pads. Once complete, we will be able to test the bq hardware on the breadboard.
6.4 White Hat Hacker Test | Seth | 10/1/2014 | 6/21/2014 | Found volunteers to pen test the server. Since the website is mostly complete, we will begin testing.
3.2 PCB design | Alex | 10/6/2014 | 6/10/2014 | Progress can continue with this, since an evaluation module layout has been researched, and parts for each resistor configuration have been determined through simulation. Also, pricing for stamping through OSHPark has been researched, and they charge $5 per square inch. With a limited board size of 4 x 3.2 inches due to use of Eagle Freeware, and a limitation of 2 sided boards, the price is maxed at $64 per board.

## Next Milestones

Milestone

Team
Member
in Charge

Modified
Completion
Date

Original
Completion
Date

Comments

3.1 Breadboard
prototyping

Alex,
Jared | 10/1/2014 | 6/1/2014

No longer blocked. We
can begin work with
prototyping the boost
converter. Our contact,
Nick Conn, has agreed to
provide us with the
equipment we need to
solder the bq qfn chip to
a DIP converter. Jared is
currently creating a
stencil for the QFN to dip converter so that we can
accurately apply solder
paste to the pads. Once
complete, we will be able
to test the bq hardware
on the breadboard.

3.2 PCB design

Alex | 10/6/2014 | 6/10/2014

Progress can continue
with this, since an
evaluation module layout
has been researched,
and parts for each
resistor configuration
have been determined
through simulation. Also,
pricing for stamping
through OSHPark has
been researched, and
they charge $5 per
square inch. With a
limited board size of 4 x

| | | | 3.2 inches due to use of Eagle Freeware, and a limitation of 2 sided boards, the price is maxed at $64 per board.
10.3 Train camera for identifying walkers, bikers, and horses | Seth | 10/15/2014 | 8/1/2014 | Algorithms researched and added to project database. Continuing research. Jared will be moving to assist with hardware, and Seth will continue with this after finishing the website (hence the date change).

### 9. Windbelt Testing

(See Gantt Chart)

Alex | 11/5/2014 | 5/27/2014

No longer blocked.
Continuing testing of
Windbelt with natural
wind speeds, angles, and
variation to measure
efficiency over a period
of time. Test data will be captured using a
BeagleBone Black, and
data will be sent to the
server to test the
database and website
response. Once the QFN
to DIP module is
soldered (due to happen
this week), testing can
continue with the
Windbelt connected to
the bq device.

## Status

### Difficulties

Learning the Django templating language was a tad difficult at first. Once things started to “click”, however, it was not too bad.

Output values of certain ports in the boost converter are somewhat unintuitive, as the UV (undervoltage) and OV (overvoltage) signals are based on a dynamic reference value that is generated by internals within the device. Even though the boost converter is tuned for an overvoltage value of 4.2V and an undervoltage value of 3.2V, the voltages coming out of those ports are pulses that are interpreted by the chip itself, and have no significance to the user. The same goes for the “battery ok” signal and its associated reference values. Reading output from OrCad is basically not useful for those ports.

### Surprises

Making Auth in Django is surprisingly easy. It took about an hour to do.

After the ShellShock bug was discovered, the Pi was upgraded to the latest software to get the latest version of bash. This broke Apache, which is what serves the website. The website went down for a few hours until an outofdate library was uninstalled from the server.

We will be able to handsolder the boost converter to a breakout board despite its size. This will allow us to breadboard with it prior to custom PCB finalization.

### Successes

Website frontend is completed. There will need to be some work on the backend down the road when the nodes need to talk to the database.

OrCad simulation resulted in output values of 4.1V to the battery. MPPT is also working, adjusting the reference voltage to drive up the voltage at the output of the chip dynamically. Simulation plots have been captured.

### Open Questions & Problems

OrCad is very memory intensive, and often crashes during lengthy simulations of the boost converter. For this reason, the power module will have to be simulated in stages.

## Gantt Chart

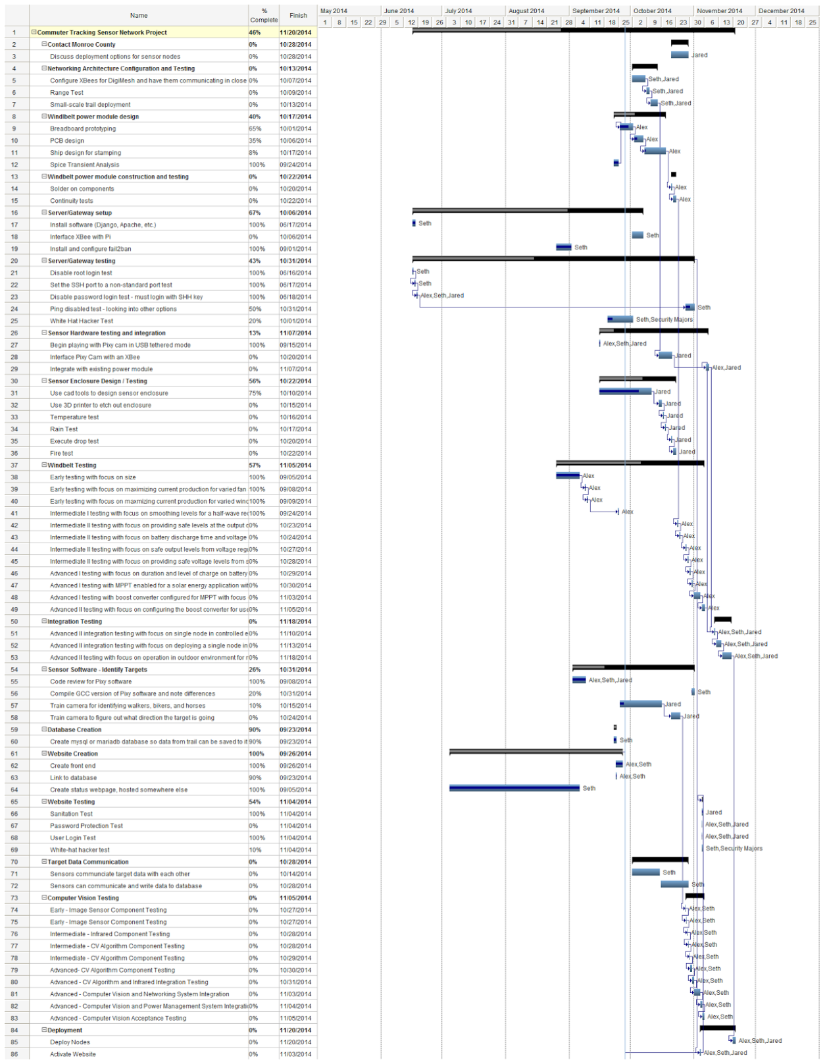
[picture p80: figure]
