xforever1313/commutertrackingsensornet/CEwebsite/public/docs/weekly9.pdf

# Commuter Tracking Sensor Network

Weekly Report October 26th, 2014

Team Members:
Alex Sarra (ags7798@rit.edu) Seth Hendrick (srh7240@rit.edu) Jared Mistretta (jxm6666@rit.edu)

Other Collaborators:
Professor Wagner (mjwgse@rit.edu) (585) 475-5289 Nicholas Conn (nxc9827@rit.edu) Graduate Student Jared Stroud (jaredestroud@gmail.com) Security Major Stanley Chan (sxc4244@rit.edu) Security Major

Project Website:
Navigate to Google Drive Share (https://drive.google.com/folderview?id=0B4QNLbh8wjupal9wZDNRWTlsOEU&usp=sharing)

## Updated Milestone Chart

Milestone | Team Member in Charge | Modified Completion Date | Original Completion Date | Comments
1. Contact Monroe County Discuss deployment options for sensor nodes. | Jared | 10/28/2014 | 10/27/2014 | Not a priority until we complete more of the technical requirements.
2. Networking Architecture Configuration and Testing | | 10/13/2014 | 6/15/2014
2.1 Configure XBees for DigiMesh and have them communicating in close proximity | Seth, Jared | 10/16/2014 | 6/1/2014 | Done for now. Some additional configuration changes might need to be updated as more testing is done.
2.2 Range Test | Seth, Jared | 10/29/2014 | 6/9/2014 | Outdoor testing was pushed back a few days due to rain. We don't want our electronics to get wet. However an indoor test was apartment 4 miles away. Unsurprisingly, 4 miles is a tad too far for the XBees to communicate with each other,
2.3 Smallscale trail deployment | Seth, Jared | 11/1/2014 | 6/15/2014 | Dependent on 2.1 and 2.2 and 5.2
3. Windbelt power module design | | 10/2/2014 | 6/18/2014

conducted between RIT and Seth's

3.1 Breadboard
prototyping

Alex,
Jared | 11/1/2014 | 6/1/2014

Battery management is now
working to spec. Next step is power with a Windbelt source, and observe effects. Then attach a battery to the converter and test charge and discharge rates.
TI Design Competition entry is complete. Waiting on TI rep to accept the registration so that we can order EVMs for the secondary boost and buck converters. Configuration on the EVMs is such that we can establish proof of concept without having to make permanent modifications to the boards, so the EVM approach was chosen since it will cut
development time by a significant amount. There is still some concern as to whether the
secondary boost converter will work for our application, as it is specced to put out smaller amounts of current than needed.
3.2 PCB design | Alex | 11/5/2014 | 6/10/2014 | Implementation issues with the BQ device coupled with waiting on TI for confirmation has made this push back a bit. Once we can confirm that the EVMs produce adequate values at the output for current, this can be completed. In the meantime, Alex can complete the portion of the schematic and layout that deal with the battery management system.
3.3 Ship design for stamping | Alex | 11/5/2014 | 6/18/2014 | 3.2 Must be completed first

3.4 Spice Transient Analysis | Alex, Jared | 10/20/2014 | 9/22/2014 | COMPLETE Transient analysis is complete for both the buck and secondary boost converter. Levels are attainable for both the 6-10V unregulated (Pixy) and 3-3.3V regulated (XBee) ranges per transient simulations produced by TI's WEBDESIGN application.
4. Windbelt power module construction and testing | | 10/22/2014 | 6/30/2014
4.1 Solder on components | Alex | 11/21/2014 | 6/29/2014 | These got pushed back since they require a 2 week shipment turnaround time. 3.3 Must be completed first.
4.2 Continuity tests | Alex | 11/24/2014 | 6/30/2014 | These got pushed back since they require a 2 week shipment turnaround time. Will probably need just the weekend to test this.
5. Server/Gateway setup | Seth | 10/10/2014 | 7/1/2014 | The server is a Raspberry Pi located at ctsn.student.rit.edu.
5.1 Install software (Django, Apache, etc.) | Seth | 6/21/2014 | 6/17/2014 | COMPLETE Apache, Django, MariaDB are installed and ready to go.
5.2 Interface XBee with Pi | Seth | 10/31/2014 | 7/1/2014 | In Progress. Due to unforeseen circumstances, this had to be pushed back. The XBees are able to receive messages from each other, and are able to transmit to all other XBees on the network. However, they can not as of yet transmit to a specific XBee. The XBees addresses can not be changed, and some of the addresses happen to have the "new packet" character in their

| | | | address. Therefore while processing the packet, it will prematurely think there's a new packet coming across the Uart. The fix is to use escape characters, but this hasn't been started yet.
5.3 Install and configure fail2ban | Seth | 9/1/2014 | 6/21/2014 | COMPLETE
6. Server/Gateway testing | | 10/12/2014 | 7/1/2014 | COMPLETE
6.1 Disable root login test | Seth | 6/21/2014 | 6/16/2014 | COMPLETE Done automatically when Raspbian was updated
6.2 Set the SSH port to a nonstandard port test | Seth | 6/21/2014 | 6/17/2014 | COMPLETE SSH Port is set to 1315, not the default port of 22
6.3 Disable password login test must log in with SSH key | Alex, Jared, Seth | 9/5/2014 | 6/21/2014 | COMPLETE SSH Keys are required to login to the server via SSH
6.4 White Hat Hacker Test | Seth | 10/12/2014 | 6/21/2014 | COMPLETE. They could not access the server via ssh, get a root shell, or access the database directly. Jared (security major) will be providing a formal report of the pen test results. We will be able to fortify security based on the results.
6.5 Ping disabled test | Seth, Security Majors | 10/31/2014 | 6/21/2014 | DEFERRED While the server is on the RIT campus, this is completed since outsiders can not ping rit.edu. If the server moves of campus for whatever reason, this will need to be revisited

7. Sensor hardware testing and integration | | 10/31/2014 | 7/11/2014
7.1 Begin playing with Pixy Cam in USB tethered mode | Jared, Alex, Seth | 7/11/2014 | 5/1/2014 | COMPLETE We've all experimented and interfaced with the PixyCam now, and familiarized ourselves with its basic operation.
7.2 Interface Pixy Cam with an XBee | Jared, Alex | 10/31/2014 | 6/22/2014 | Antennas are in. Dependent on 2.2.
7.3 Integrate with existing power module | Jared, Alex | 11/7/2014 | 7/11/2014 | Will be done upon completion of 3.1. Pushed back due to power module dependency, and implementation issues/ordering wait time for power modules.
8. Sensor Enclosure Design / Testing | | 10/31/2014 | 8/7/2014
8.1 Use CAD tools to design sensor enclosure | Jared | 10/31/2014 | 7/1/2014 | This is no longer blocked. This process can continue taking into account the largest board size available through the evaluation version of EAGLE. Jared currently working on CV, which is higher priority task.
8.2 Use 3D printer to print the enclosures | Jared | 11/3/2014 | 7/15/2014 | 8.1 Must be done first
8.3 Test (See Gantt Chart) | Jared | 11/5/2014 | 8/7/2014 | Dependent on 8.2
9. Windbelt Testing (See Gantt Chart) | Alex | 11/5/2014 | 5/27/2014 | BQ device is to be connected to windbelt and tested for output levels and consistency. Further testing will involve connecting a battery and testing charge and discharge rates along with outdoor testing with natural wind sources.

10. Sensor Software Identify targets | | 10/24/2014 | 9/1/2014
10.1 Code Review for Pixy Software | Alex, Seth, Jared | 9/8/2014 | 9/8/2014 | COMPLETE Code review was completed. Information was documented regarding each file's contents.
10.2 Compile GCC version of Pixy software and note differences | | | 9/8/2014 | No longer a requirement. Keil will work just fine.
10.3 Train camera for identifying walkers, bikers, and horses | Jared | 10/31/2014 | 8/1/2014 | After creating a Visual Studio Firmware code is easier, we found the spot where the code is to be plug in multiple algorithms and select which one we want to run, therefore allowing us to test multiple algorithms. The one we are leaning towards right now is the FREAK algorithm.
10.4 Train camera to figure out what direction the target is going | Jared | 10/31/2014 | 9/1/2014 | 10.3 and 10.4 are not dependent on one another. These two tasks should be completed in parallel.
11. Database Creation | | 9/23/2014 | 9/14/2014
11.1 Create mysql or mariadb database so data from trail can be saved to it | Seth | 10/31/2014 | 9/5/2014 | The rest of this can be completed in parallel with the CV algorihms. Need to know what data needs to be saved to the database resultant of the CV algorithms.
12. Website Creation | | 9/26/2014 | 9/28/2014 | Front end is complete, but there may need to be some work done on the backend downtheroad

Project so parsing through the Pixy

plugged in. The best part is we can

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

16.1 Deploy nodes on trail | Team | 11/17/2014 | 11/5/2014
16.2 Activate website Team | | 9/27/2014 | 11/9/2014 | Complete. Website is located at http://ctsn.student.rit.edu:1415 (login required)
17.Integration Testing | | 11/13/2014
17.1 Advanced II integration testing with focus on single node in controlled environment | Team | 11/5/2014 | | Some of the integration testing will need to be completed with the prototype in place due to time constraints.
17.2 Advanced II integration testing with focus on single node in an outdoor environment | Team | 11/10/2014 | | Some of the integration testing will need to be completed with the prototype in place due to time constraints.
17.3 Advanced II testing with focus on operation in outdoor environment for multiple nodes | Team | 11/13/2014 | | Some of the integration testing will need to be completed with the prototype in place due to time constraints.

## Current Milestones

Milestone | Team Member in Charge | Modified Completion Date | Original Completion Date | Comments
2.2 Range Test | Seth, Jared | 10/29/2014 | 6/9/2014 | Outdoor testing was pushed back a few days due to rain. We don't want our electronics to get wet. However an indoor test was conducted between RIT and Seth's apartment 4 miles a tad too far for the XBees to communicate with each other,

away. Unsupringly, 4 miles is

3.1 Breadboard
prototyping

Alex,
Jared | 11/1/2014 | 6/1/2014

Battery management is now
working to spec. Next step is power with a Windbelt
source, and observe effects. Then attach a battery to the converter and test charge
and discharge rates.
TI Design Competition entry is complete. Waiting on TI rep to accept the registration so that we can order EVMs
for the secondary boost and buck converters.
Configuration on the EVMs
is such that we can establish proof of concept without
having to make permanent
modifications to the boards, so the EVM approach was
chosen since it will cut
development time by a

| | | | significant amount. There is still some concern as to whether the secondary boos converter will work for our application, as it is specced to put out smaller amounts o current than needed.
3.2 PCB design | Alex | 11/5/2014 | 6/10/2014 | Implementation issues with the BQ device coupled with has made this push back a bit. Once we can confirm that the EVMs produce adequate values at the completed. In the meantime, Alex can complete the portion of the schematic and layout that deal with the battery management system.

waiting on TI for confirmation

output for current, this can be

5.2 Interface XBee with Pi

Seth | 10/31/2014 | 7/1/2014

In Progress. Due to
unforseen circumstances,
this had to be pushed back. The XBees are able to
receive messages from
each other, and are able to transmit to all other XBees on the network. However,
they can not as of yet
transmit to a specific XBee. The XBees addresses can
not be changed, and some
of the addresses happen to have the "new packet"
character in their address. Therefore while processing the packet, it will prematurely

| | | | think there's a new packet coming across the Uart. The fix is to use escape characters, but this hasn't been started yet.
10.3 Train camera for identifying walkers, bikers, and horses | Jared | 10/31/2014 | 8/1/2014 | After creating a Visual Studio Project so parsing through the Pixy Firmware code is easier, we found the spot where the code is to be plugged in. The best part is we can plug in multiple algorithms and select which allowing us to test multiple algorithms. The one we are leaninng towards right now is the FREAK algorithmn.
10.4 Train camera to figure out what direction the target is going | Jared | 10/31/2014 | 9/1/2014 | 10.3 and 10.4 are not dependent on one another. These two tasks should be completed in parallel.

one we want to run, therefore

## Next Milestones

Milestone | Team Member in Charge | Modified Completion Date | Original Completion Date | Comments
2.2 Range Test | Seth, Jared | 10/29/2014 | 6/9/2014 | Outdoor testing was pushed back a few days due to rain. We don't want our electronics to get wet. However an indoor test was conducted between RIT and Seth's apartment 4 miles away. Unsupringly, 4 miles is a tad too far for the XBees to communicate with each other,
2.3 Smallscale trail deployment | Seth, Jared | 11/1/2014 | 6/15/2014 | Dependent on 2.1 and 2.2 and 5.2

3.1 Breadboard
prototyping

Alex,
Jared | 11/1/2014 | 6/1/2014

Battery management is
now working to spec. Next
step is power with a
Windbelt source, and
observe effects. Then
attach a battery to the
converter and test charge
and discharge rates.
TI Design Competition
entry is complete. Waiting on TI rep to accept the
registration so that we can order EVMs for the
secondary boost and buck
converters. Configuration
on the EVMs is such that
we can establish proof of
concept without having to
make permanent

| | | | modifications to the boards, so the EVM approach was chosen since it will cut development time by a significant amount. There is still some concern as to whether the secondary boost converter will work for our application, as it is specced to put out smaller amounts of current than needed.
3.2 PCB design | Alex | 11/5/2014 | 6/10/2014 | Implementation issues with the BQ device coupled with waiting on TI for confirmation has made this push back a bit. Once we can confirm that the EVMs produce adequate values at the output for current, thi can be completed. In the meantime, Alex can complete the portion of the schematic and layout that deal with the battery management system.
5.2 Interface XBee with Pi | Seth | 10/31/2014 | 7/1/2014 | In Progress. Due to unforseen circumstances, this had to be pushed back. The XBees are able to receive messages from each other, and are able to transmit to all other XBees on the network. However, they can not as of yet transmit to a specific XBee. The XBees

| | | | addresses can not be changed, and some of the addresses happen to have the "new packet" character in their address. Therefore while processing the packet, it will prematurely think there's a new packet coming across the Uart. The fix is to use escape characters, but this hasn't been started yet.
7.2 Interface Pixy Cam with an XBee | Jared, Alex | 10/31/2014 | 6/22/2014 | Antennas are in. Dependent on 2.2.
9. Windbelt Testing (See Gantt Chart) | Alex | 11/5/2014 | 5/27/2014 | BQ device is to be connected to windbelt and tested for output levels and consistency. Further testing will involve connecting a battery and testing charge and discharge rates along with outdoor testing with natural wind sources.
10.3 Train camera for identifying walkers, bikers, and horses | Jared | 10/31/2014 | 8/1/2014 | After creating a Visual Studio Project so parsing through the Pixy Firmware code is easier, we found the spot where the code is to be plugged in. The best part is we can plug in multiple algorithms and select which one we want to test multiple algorithms. The one we are leaninng towards right now is the FREAK algorithmn.

to run, therefore allowing us

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
t is

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
r. These two tasks should be completed in parallel.

## Status

### Difficulties

The battery management device required that one of the pins attached to ground be connected to signal ground versus a general ground like the rest of the chip. Once this problem was isolated, the fix was simple. The input source was isolated from the rest of the circuit, and a line from its ground was connected to the pin as required.

### Surprises

The XBee’s address can not be changed. Although this is not a roadblock, it does slow progress down. Some of the XBee’s have the start character of a packet (0x7E) in their address. This means that while parsing through the packet, its possible to mistake an address number with a new packet. There is a workaround to do this by adding escape characters, but this will push the completion of the XBees back a few days.

### Successes

The battery management boost converter is working per specifications provided from the transient analysis simulation in Spice. It is providing 4.1VDC at the output of the boost converter and at the battery’s positive terminal for a VIN as low at 550mVRMS of pulsating DC. The overvoltage and undervoltage thresholds limit the voltage levels to a little over 4.1V for both pins, regardless of what voltage is at the input. When the voltage limit is undershot, MPPT works to drive the voltage up to an acceptable limit based on what input is being sampled at the Vsamp pin. The XBees can now transmit and receive packets. However, they can only transmit packets to all XBees on the network, not to a specific address. Packet parsing with escape characters needs to be completed first before the XBees can transmit to a specific address. After creating a Visual Studio project for the Pixy Cam firmware, the code was considerably easier to parse through. The firmware acts like a state machine, and can run several “programs” or algorithms on it. Plugging in the CV algorithms should be relatively easy, we just need to write a new program. The FREAK algorithm seems like the best choice.

### Open Questions and Concerns

There is still some concern as to whether the secondary boost converter will work for our application, as it is specced to put out smaller amounts of current than needed, but the TI webbased design simulation app provided transient analysis data that says otherwise.
Alex will try as hard as he can to get the custom PCB implemented before demonstration. This will most likely be completed for just the BQ25504 portion of the system, and any peripherals that may need a connection to power, which is still considered less than ideal. All efforts will be made to stick to original plans.

### Gantt Chart

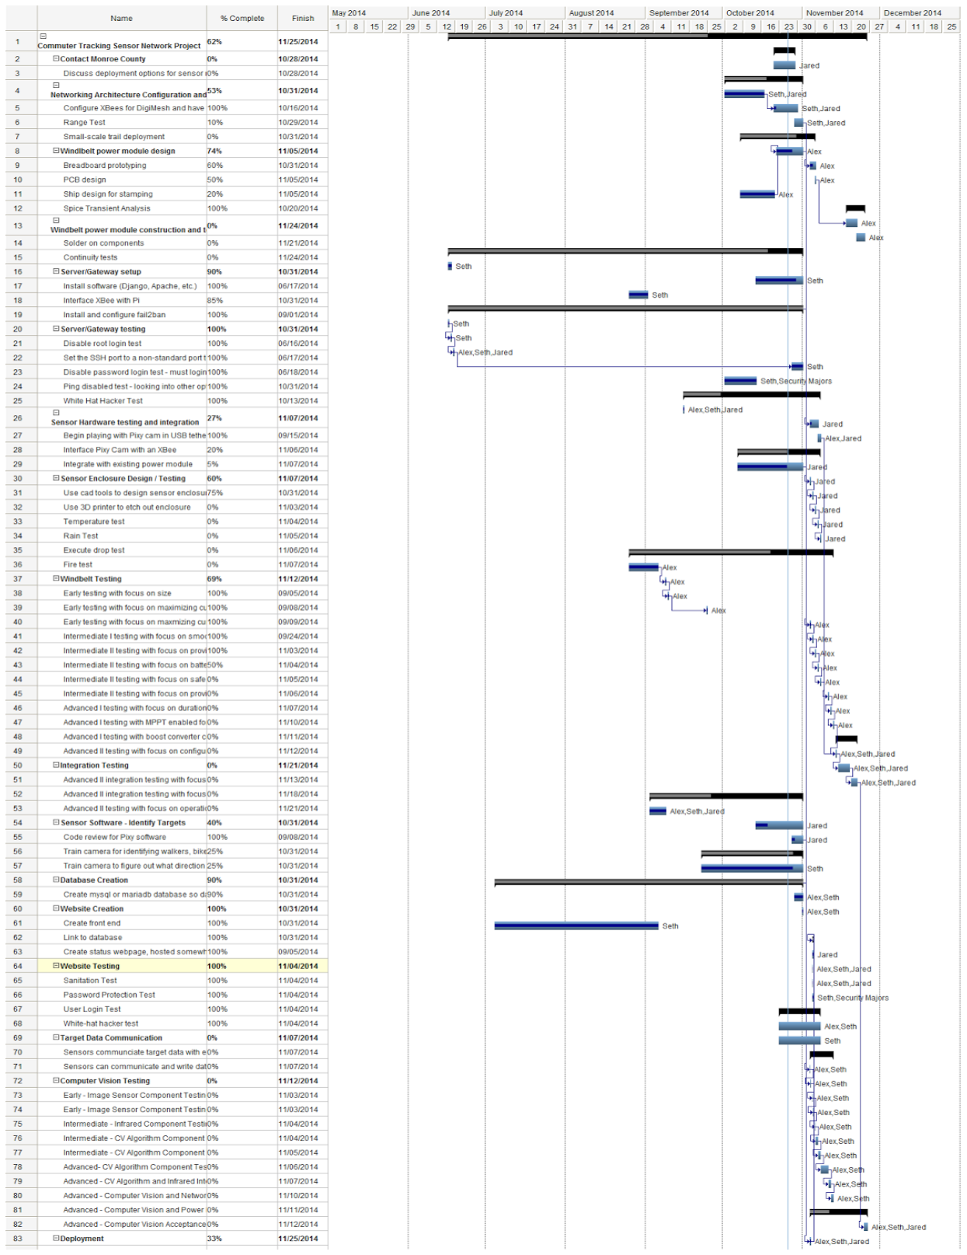
[picture p84: figure]
