xforever1313/commutertrackingsensornet/CEwebsite/public/docs/gateway_testing.pdf

Gateway Software Testing

The software that ran on the gateway node was extensively unit tested with the help of the C++ unit testing library CppUTest. There were two sections of code that were extensively unit tested, and that is the “common” software that could run on any software in the CTSN (such as the gateway, or on the big computer), and the gateway software that only ran on the gateway node. For the common software, 49 unit tests were written with 91.47 % test coverage. This is shown in Figure 61.

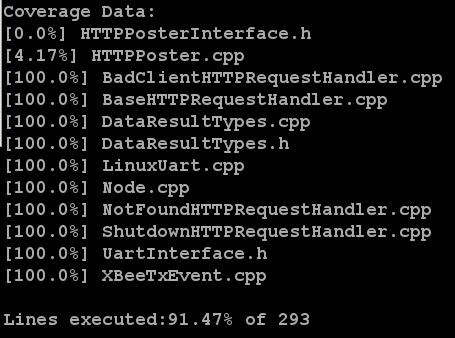
[picture p85: figure]

Figure 61- Unit Test Results for ctsn common

The top screenshot shows that all tests pass for ctsn common. The bottom picture shows the test coverage for each file in the ctsn common project, and how much of

each file is unit tested.

For the gateway software, 222 unit tests were written with 89.09% test coverage. This is shown in figure 62.

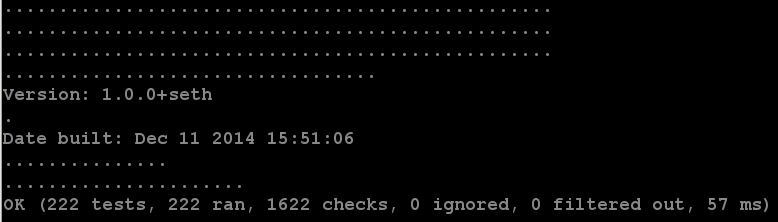
[picture p86: figure]
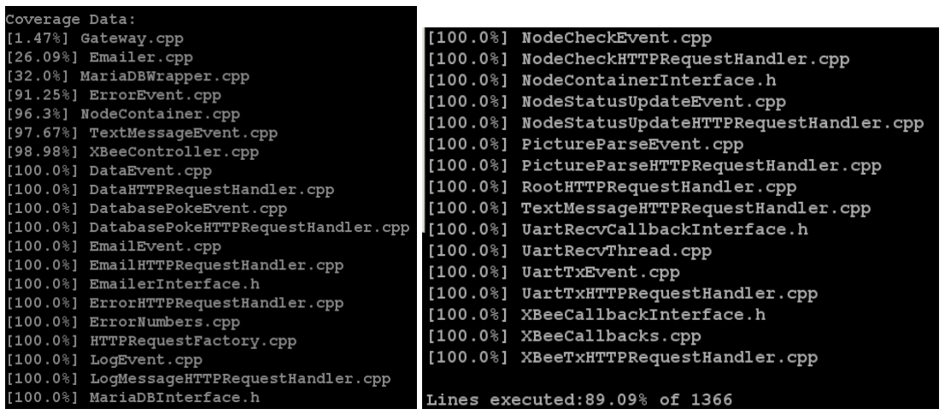
[picture p87: figure]

Figure 62- Unit Test Results for Gateway Software

The top screenshot shows that all tests pass for the gateway software. The bottom pictures show the test coverage for each file in the gateway software project, and how much of each file is unit tested.

In total, 271 unit tests were written for the gateway software with a very high amount of test coverage.
