xforever1313/commutertrackingsensornet/CEwebsite/public/docs/network_risk.pdf

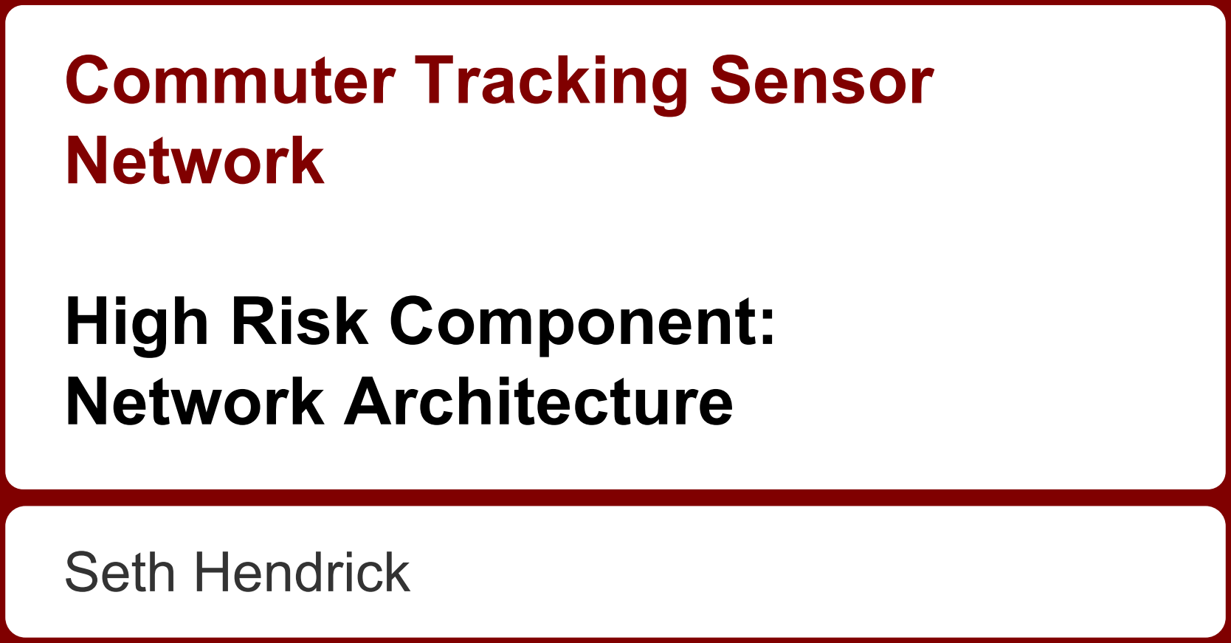
[picture p88: figure]
Commuter Tracking Sensor Network; High Risk Component: Network Architecture; Seth Hendrick

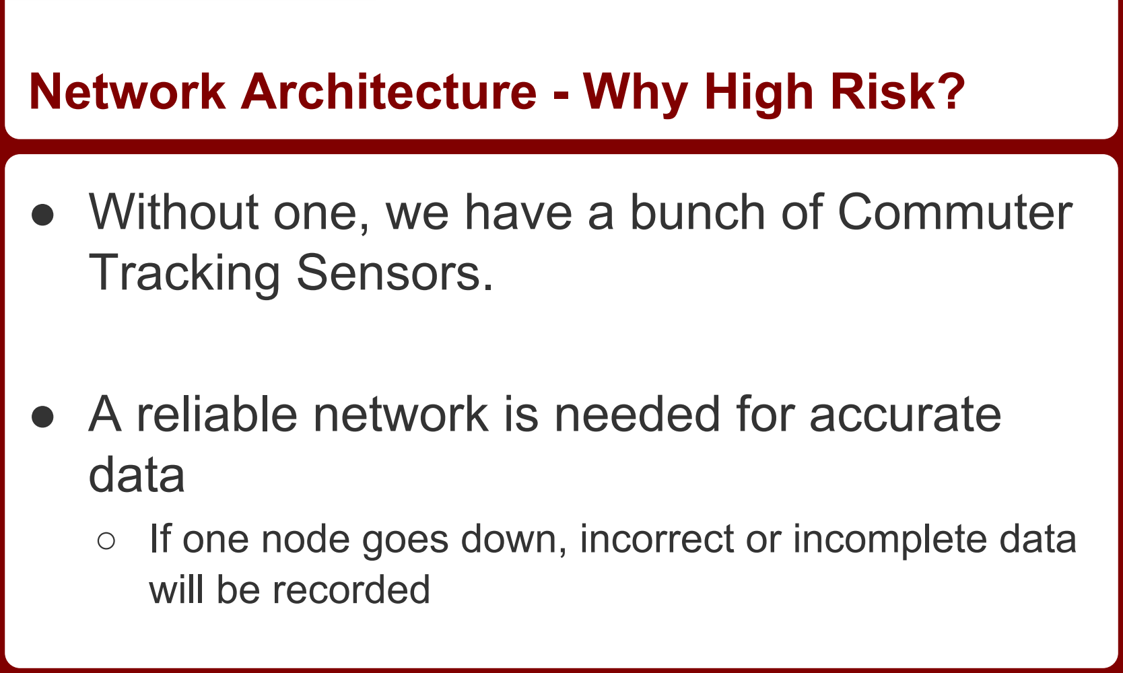
[picture p89: figure]
Network Architecture - Why High Risk?; Tracking Sensors.; data; will be recorded

## - Without one, we have a bunch of Commuter

## - A reliable network is needed for accurate

## - If one node goes down, incorrect or incomplete data

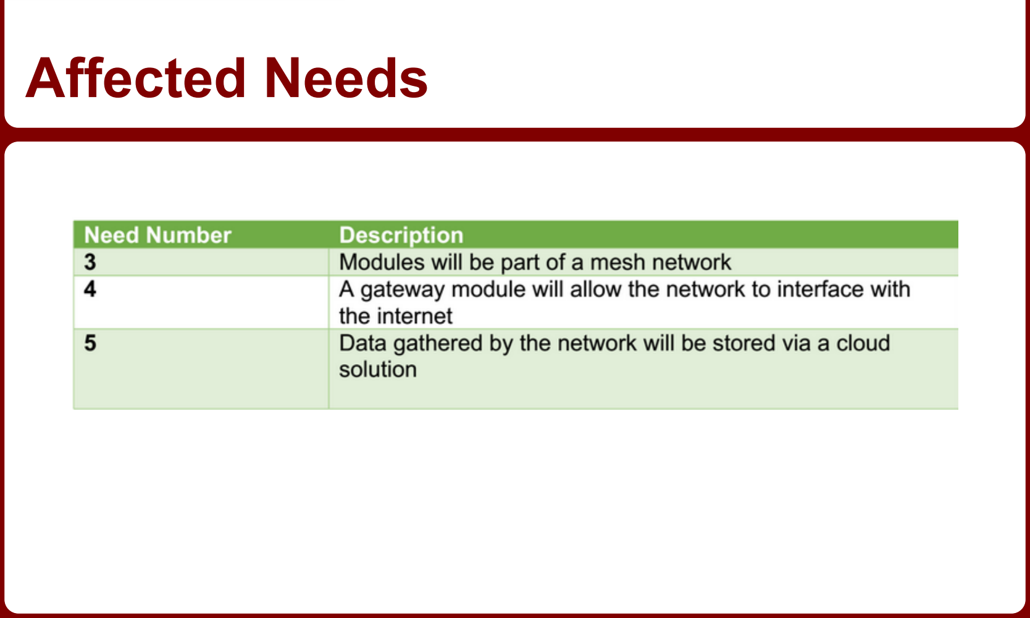
[picture p90: figure]
Affected Needs

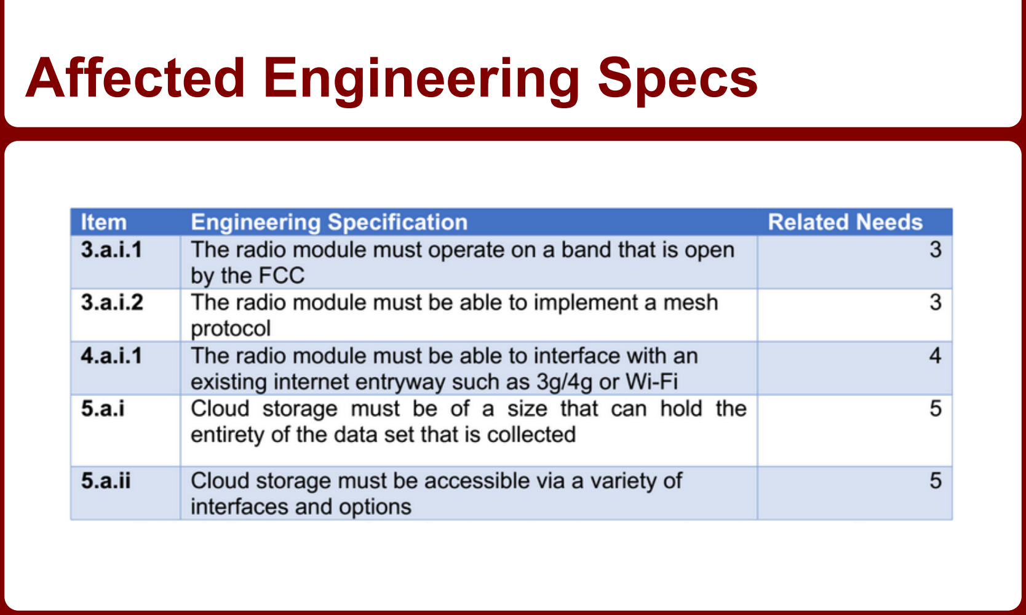
[picture p91: figure]
Affected Engineering Specs

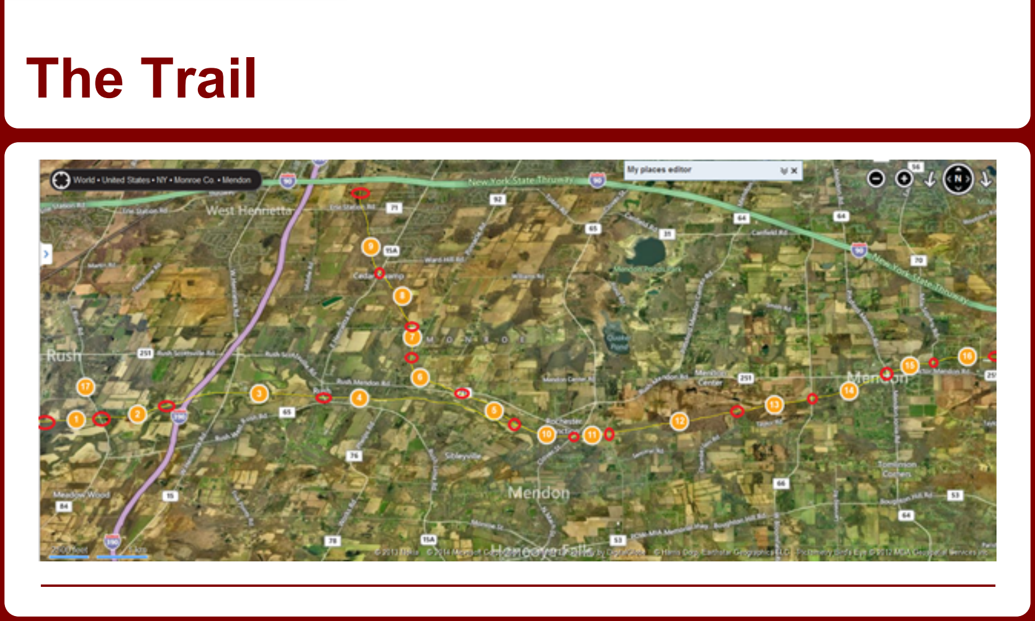
[picture p92: figure]
The Trail

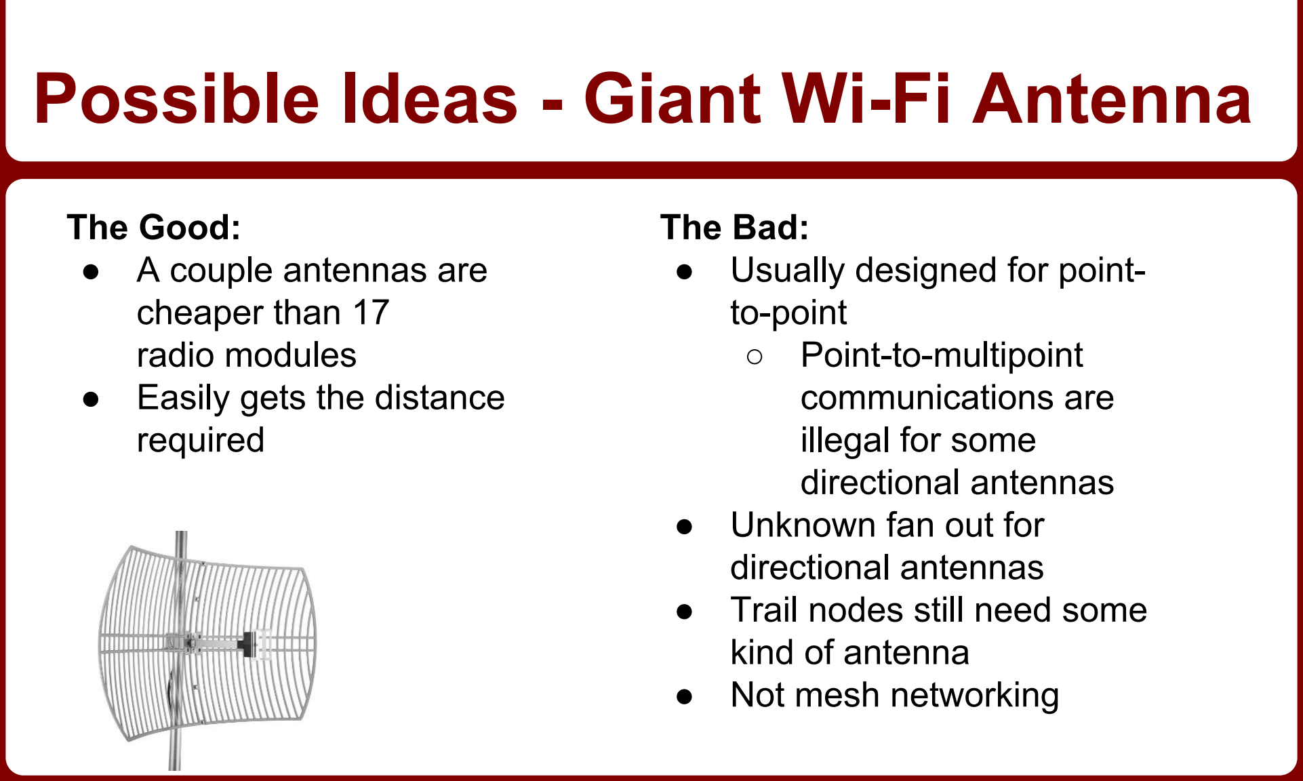
[picture p93: figure]
Possible Ideas - Giant Wi-Fi Antenna; The Good: ● A couple antennas are cheaper than 17 radio modules ● Easily gets the distance required; The Bad: ● Usually designed for point- to-point ○ Point-to-multipoint communications are illegal for some directional antennas ● Unknown fan out for directional antennas ● Trail nodes still need some kind of antenna ● Not mesh networking

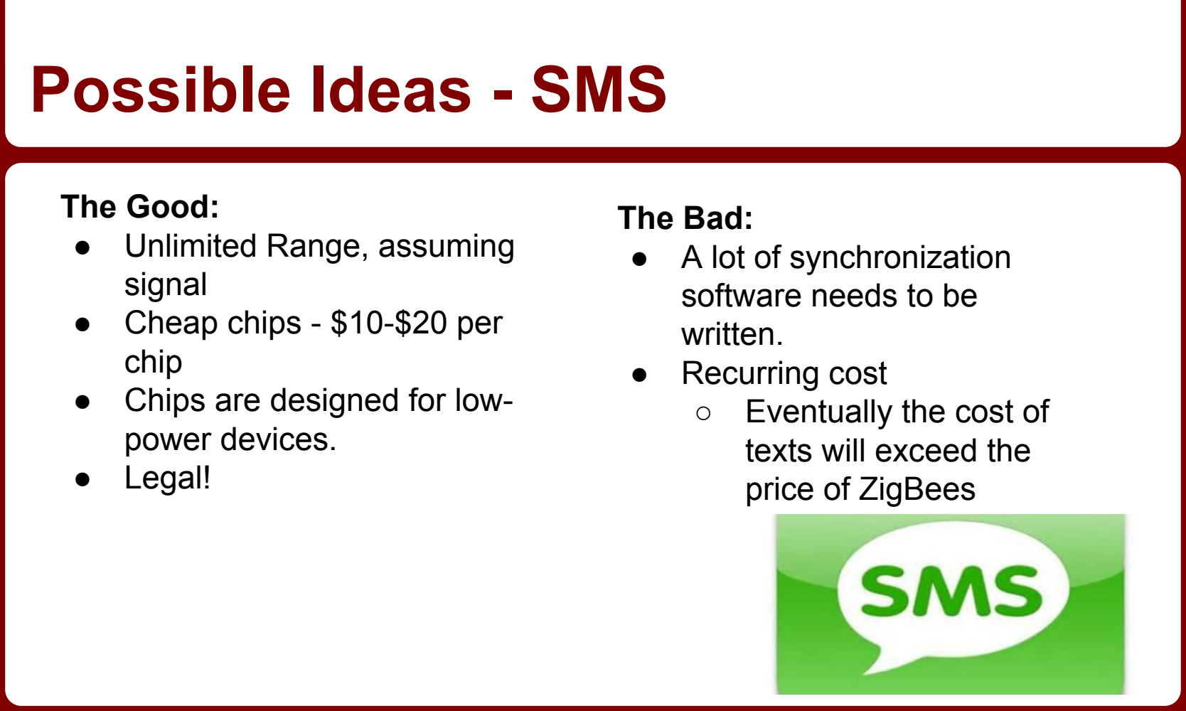
[picture p94: figure]
Possible Ideas - SMS; The Good: ● Unlimited Range, assuming signal ● Cheap chips - $10-$20 per chip ● Chips are designed for low- power devices. ● Legal!; The Bad: ● A lot of synchronization software needs to be written. ● Recurring cost ○ Eventually the cost of texts will exceed the price of ZigBees

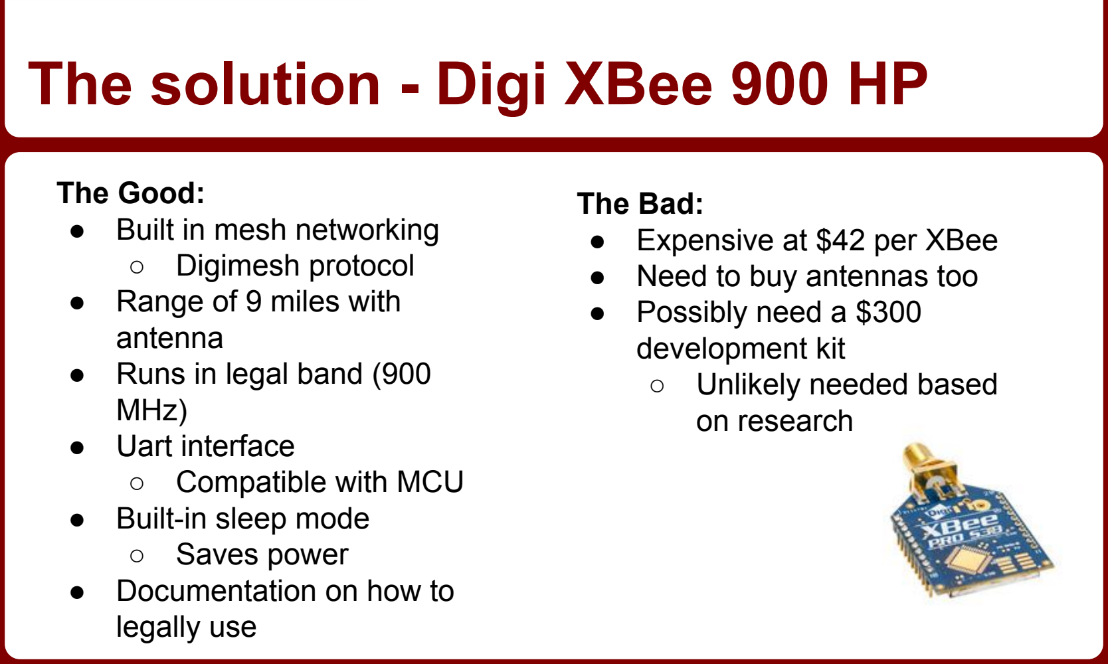
[picture p95: figure]
The solution - Digi XBee 900 HP; The Good: ● Built in mesh networking ○ Digimesh protocol ● Range of 9 miles with antenna ● Runs in legal band (900 MHz) ● Uart interface ○ Compatible with MCU ● Built-in sleep mode ○ Saves power ● Documentation on how to legally use; The Bad: ● Expensive at $42 per XBee ● Need to buy antennas too ● Possibly need a $300 development kit ○ Unlikely needed based on research

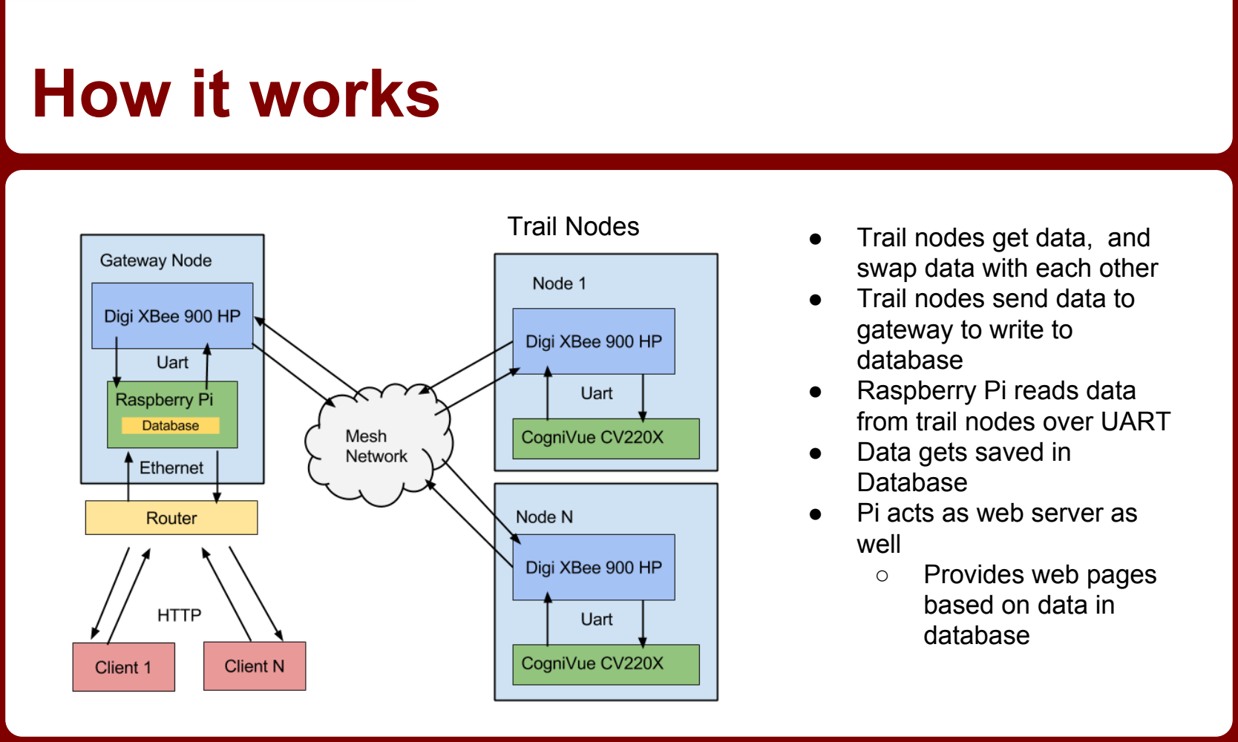
[picture p96: figure]
How it works; Trail Nodes; Trail nodes get data, and; swap data with each other ● Trail nodes send data to gateway to write to database ● Raspberry Pi reads data from trail nodes over UART ● Data gets saved in Database ● Pi acts as web server as well ○ Provides web pages based on data in database

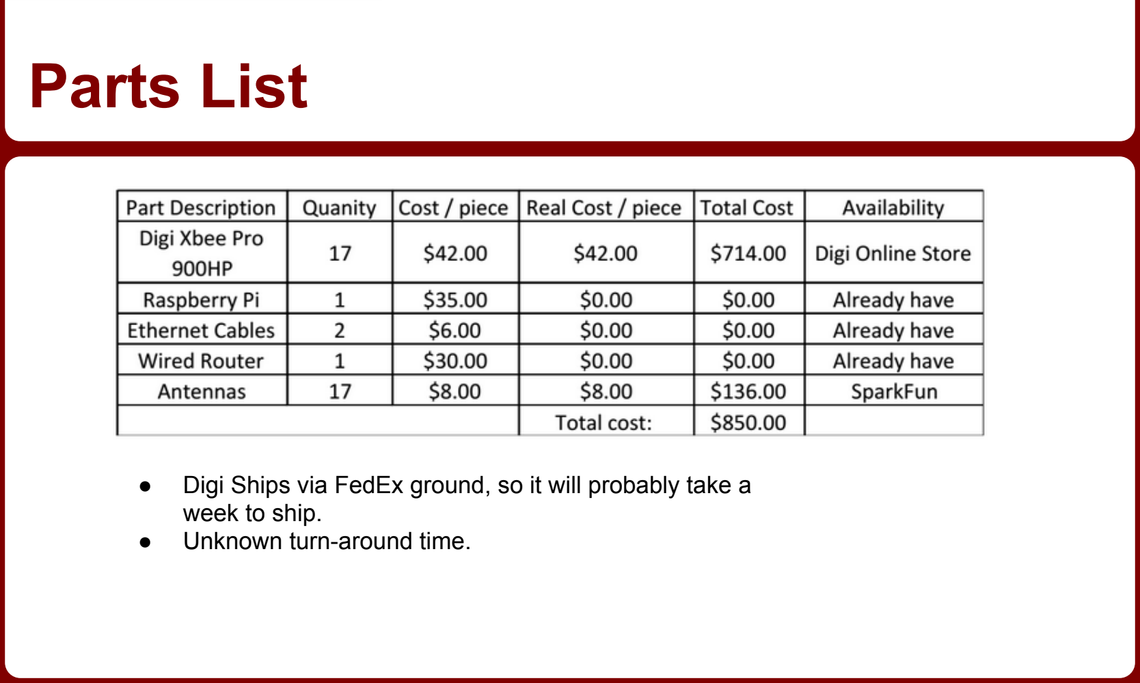
[picture p97: figure]
Parts List; week to ship. ● Unknown turn-around time.

- Digi Ships via FedEx ground, so it will probably take a

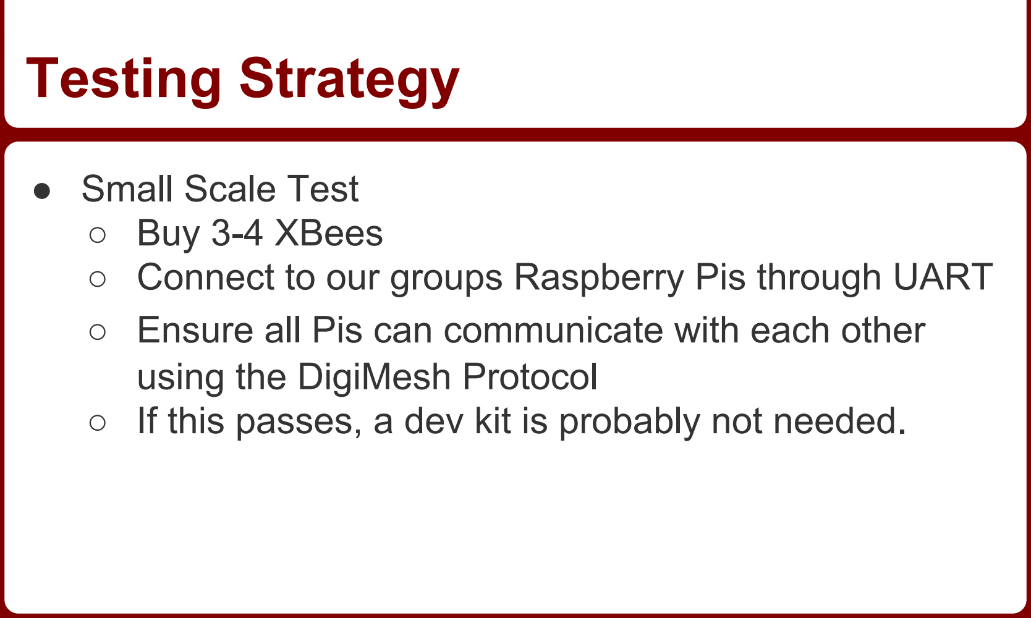
[picture p98: figure]
Testing Strategy; ● Small Scale Test ○ Buy 3-4 XBees; using the DigiMesh Protocol

## - Connect to our groups Raspberry Pis through UART - Ensure all Pis can communicate with each other

- If this passes, a dev kit is probably not needed.

# Testing Strategy

## - Distance Test - Take two XBees connected to the Pis, see how far they can go before cutting out - If they can go at least 2 miles, XBee and antenna are probably good enough - Small scale trail test - Take all four test nodes out to the trail, and place at

positions 2, 3, 4, and 17.

## - If they can all talk together, probably safe to ramp up to full trail

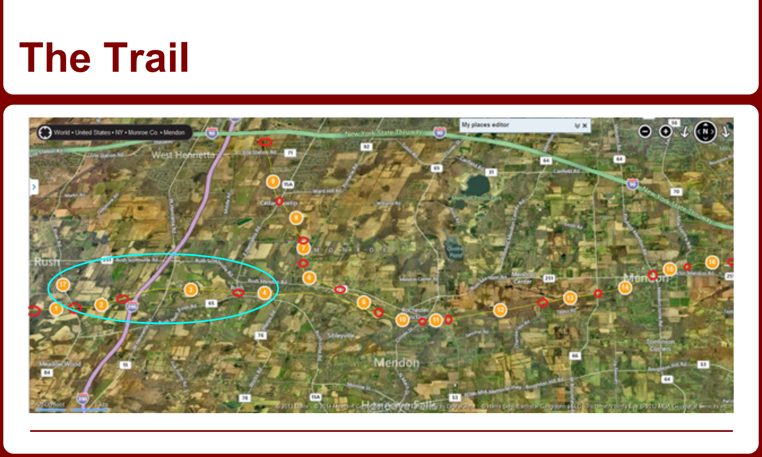
[picture p99: figure]
The Trail

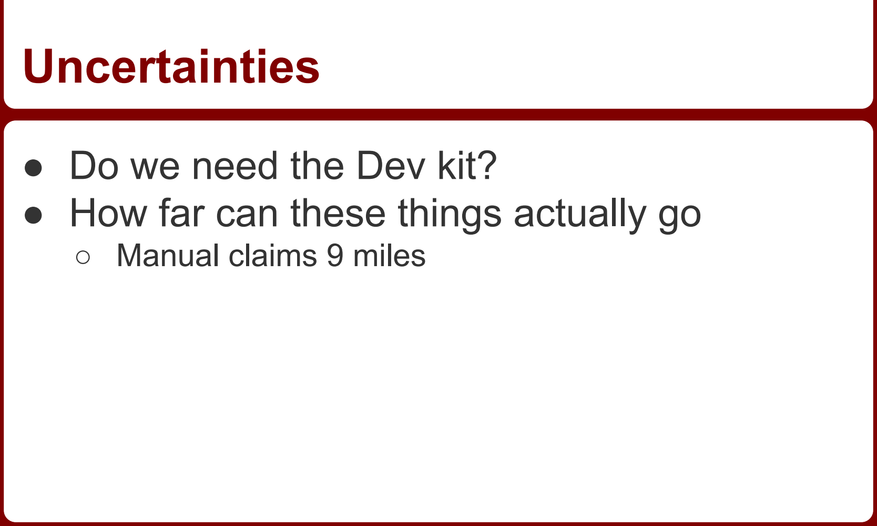
[picture p100: figure]
Uncertainties; ● Do we need the Dev kit? ● How far can these things actually go; ○ Manual claims 9 miles

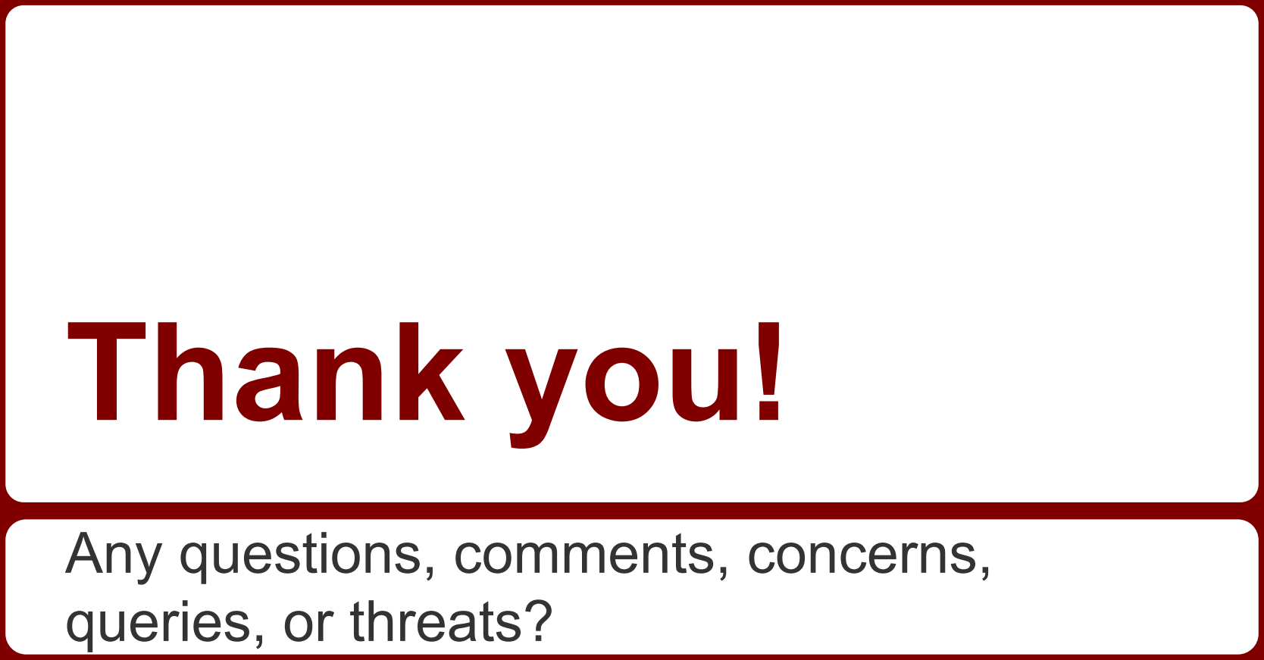
[picture p101: figure]
Thank you!; Any questions, comments, concerns, queries, or threats?
