xforever1313/commutertrackingsensornet/CEwebsite/public/docs/ctsnpwrmodule_rev1.pdf

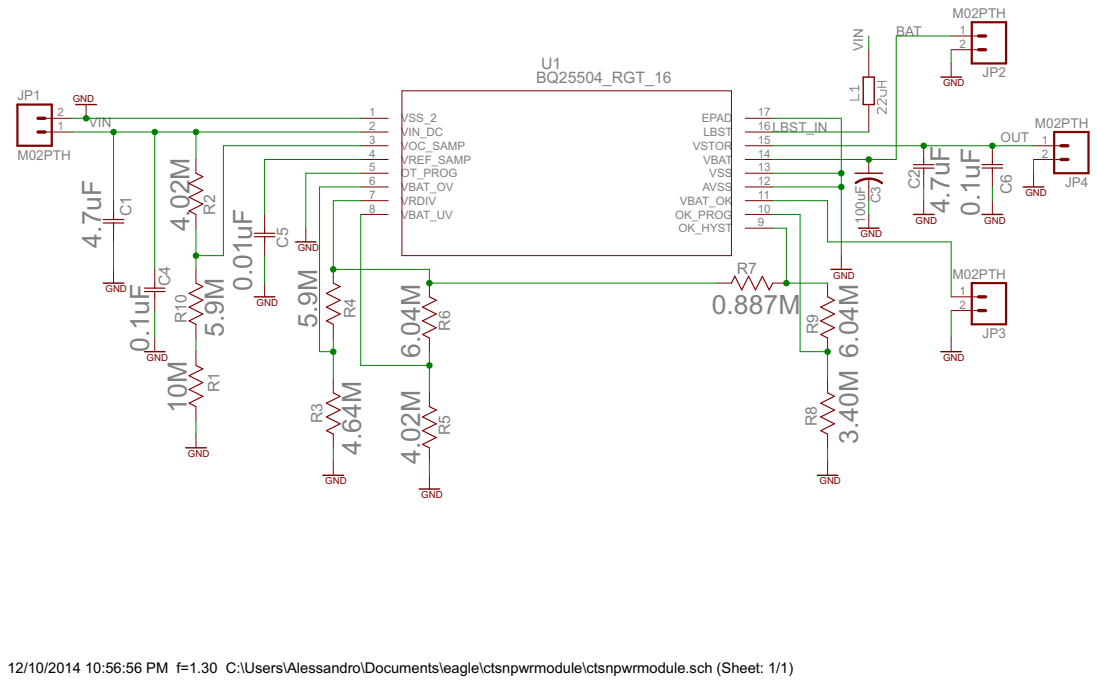
[picture p113: page 1]

12/10/2014 10:56:56 PM f=1.30 C:\Users\Alessandro\Documents\eagle\ctsnpwrmodule\ctsnpwrmodule.sch (Sheet: 1/1)
