xforever1313/commutertrackingsensornet/CEwebsite/public/docs/ctsnpwrmodule_rev1layout.pdf

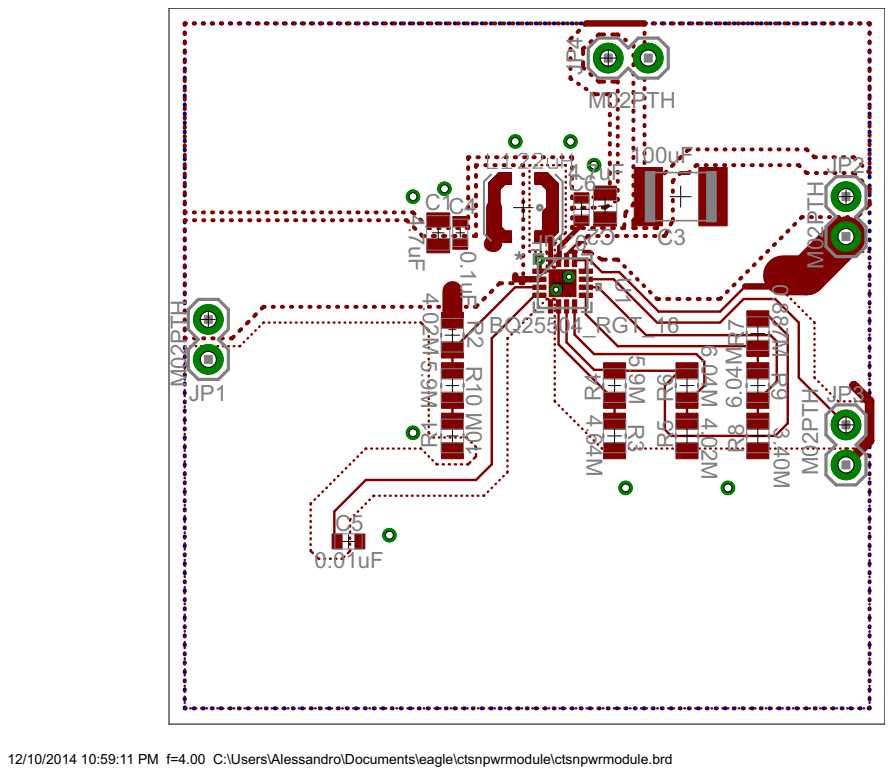
[picture p114: page 1]

12/10/2014 10:59:11 PM f=4.00 C:\Users\Alessandro\Documents\eagle\ctsnpwrmodule\ctsnpwrmodule.brd
