xforever1313/commutertrackingsensornet/gateway/src/ErrorHTTPRequestHandler.cpp

#include <memory>
#include <Poco/Exception.h>
#include <Poco/Net/HTMLForm.h>
#include <Poco/Net/HTTPServerRequest.h>
#include <Poco/Net/HTTPServerResponse.h>
#include <stdexcept>
#include <string>

#include "EventExecutorInterface.h"
#include "gateway/ErrorEvent.h"
#include "gateway/ErrorHTTPRequestHandler.h"
#include "gateway/ErrorNumbers.h"
#include "ctsn_common/Node.h"
#include "ctsn_common/NodeContainerInterface.h"
#include "gateway/MariaDBInterface.h"

namespace Gateway {

const std::string ErrorHTTPRequestHandler::GET_MESSAGE = "Usage:\nnode=x&message=y";
const std::string ErrorHTTPRequestHandler::POST_FAILURE_MISSING_FIELD_MESSAGE = "Missing field.";
const std::string ErrorHTTPRequestHandler::POST_SUCCESS_MESSAGE = "Error Message Sent.";
const std::string ErrorHTTPRequestHandler::NODE_FORM_DATA = "node";
const std::string ErrorHTTPRequestHandler::MESSAGE_FORM_DATA = "message";

ErrorHTTPRequestHandler::ErrorHTTPRequestHandler(Common::EventExecutorInterface *eventExecutor,
                                                 MariaDBInterface *mariadb,
                                                 CTSNCommon::NodeContainerInterface *nodes) :
    m_eventExecutor(eventExecutor),
    m_mariadb(mariadb),
    m_nodes(nodes)
{

}

ErrorHTTPRequestHandler::~ErrorHTTPRequestHandler() {

}

void ErrorHTTPRequestHandler::handlePostRequest(Poco::Net::HTTPServerRequest &request, Poco::Net::HTTPServerResponse &response) {
    try {
        Poco::Net::HTMLForm form(request, request.stream());
        const std::string &nodeStr = form[NODE_FORM_DATA];
        const std::string &messageStr =  form[MESSAGE_FORM_DATA];


        ErrorNumber messageType = ErrorMessage::convertStringToMessage(messageStr);
        CTSNCommon::Node node = m_nodes->convertStringToNode(nodeStr);

        std::shared_ptr<ErrorEvent> event(new ErrorEvent(messageType, node, m_mariadb));
        m_eventExecutor->addEvent(event);

        sendSuccessResponse(response, POST_SUCCESS_MESSAGE);
    }
    catch (const Poco::NotFoundException &e) {
        sendBadRequestResponse(response, POST_FAILURE_MISSING_FIELD_MESSAGE);
    }
    catch (const std::exception &e) {
        sendBadRequestResponse(response, e.what());
    }
}

void ErrorHTTPRequestHandler::handleGetRequest(Poco::Net::HTTPServerRequest &request, Poco::Net::HTTPServerResponse &response) {
    sendSuccessResponse(response, GET_MESSAGE);
}

}
