xforever1313/commutertrackingsensornet/common/src/NotFoundHTTPRequestHandler.cpp

#include <Poco/Net/HTTPResponse.h>
#include <Poco/Net/HTTPServerResponse.h>
#include <Poco/Net/HTTPRequestHandler.h>
#include <string>

#include "ctsn_common/NotFoundHTTPRequestHandler.h"

namespace CTSNCommon {

const std::string NotFoundHTTPRequestHandler::MESSAGE = "404 - Not Found";

NotFoundHTTPRequestHandler::NotFoundHTTPRequestHandler() {
}

NotFoundHTTPRequestHandler::~NotFoundHTTPRequestHandler() {

}

void NotFoundHTTPRequestHandler::handleGetRequest(Poco::Net::HTTPServerRequest &request, Poco::Net::HTTPServerResponse &response) {
    handleHTTPRequest(request, response);
}

void NotFoundHTTPRequestHandler::handlePostRequest(Poco::Net::HTTPServerRequest &request, Poco::Net::HTTPServerResponse &response) {
    handleHTTPRequest(request, response);
}

void NotFoundHTTPRequestHandler::handleHTTPRequest(Poco::Net::HTTPServerRequest &request, Poco::Net::HTTPServerResponse &response) {
    sendNotFoundResponse(response, MESSAGE);
}

}
