xforever1313/commutertrackingsensornet/common/src/BaseHTTPRequestHandler.cpp

#include <Poco/Net/HTTPResponse.h>
#include <Poco/Net/HTTPServerRequest.h>
#include <Poco/Net/HTTPServerResponse.h>
#include <Poco/Net/HTTPRequestHandler.h>
#include <string>

#include "ctsn_common/BaseHTTPRequestHandler.h"

namespace CTSNCommon {

BaseHTTPRequestHandler::BaseHTTPRequestHandler() {
}

BaseHTTPRequestHandler::~BaseHTTPRequestHandler() {
}

void BaseHTTPRequestHandler::handleRequest(Poco::Net::HTTPServerRequest &request, Poco::Net::HTTPServerResponse &response) {

    if (request.getMethod() == Poco::Net::HTTPRequest::HTTP_GET) {
        handleGetRequest(request, response);
    }
    else if (request.getMethod() == Poco::Net::HTTPRequest::HTTP_POST) {
        handlePostRequest(request, response);
    }
    else {
        sendBadRequestResponse(response);
    }
}

void BaseHTTPRequestHandler::sendSuccessResponse(Poco::Net::HTTPServerResponse &response, const std::string &message /*= "ACK"*/) {
    sendResponse(response, Poco::Net::HTTPResponse::HTTP_OK, message);
}

void BaseHTTPRequestHandler::sendNotFoundResponse(Poco::Net::HTTPServerResponse &response, const std::string &message /*= "Not Found"*/) {
    sendResponse(response, Poco::Net::HTTPResponse::HTTP_NOT_FOUND, message);
}

void BaseHTTPRequestHandler::sendBadRequestResponse(Poco::Net::HTTPServerResponse &response, const std::string &message /*= "Bad Request"*/) {
    sendResponse(response, Poco::Net::HTTPResponse::HTTP_BAD_REQUEST, message);
}

void BaseHTTPRequestHandler::sendForbiddenResponse(Poco::Net::HTTPServerResponse &response, const std::string &message /*= "Forbidden"*/) {
    sendResponse(response, Poco::Net::HTTPResponse::HTTP_FORBIDDEN, message);
}

void BaseHTTPRequestHandler::sendResponse(Poco::Net::HTTPServerResponse &response, Poco::Net::HTTPResponse::HTTPStatus status, const std::string &message) {
    response.setContentType("text/html");
    response.setStatus(status);
    std::ostream &ostr = response.send();
    ostr << message;
}

}
