xforever1313/commutertrackingsensornet/common/test/XBeeControllerTest.cpp

#include <cstdint>
#include <functional>
#include <stdexcept>
#include <string>
#include <vector>
#include "UnitTest.h"

#include "ctsn_common/XBeeConstants.h"
#include "ctsn_common/XBeeController.h"
#include "MockXBeeCallback.h"

TEST_GROUP(XBeeControllerTest) {
    TEST_SETUP() {
        m_callbacks = new testing::StrictMock<CTSNCommon::MockXBeeCallback>();
        m_uut = new CTSNCommon::XBeeController(m_callbacks);

        CHECK(m_uut->isAlive());
        CHECK(m_uut->m_isAlive);
        CHECK_EQUAL(m_uut->m_currentState, CTSNCommon::XBeeController::State::STARTUP);
        CHECK_EQUAL(m_uut->m_dataLength, 0);
        CHECK_EQUAL(m_uut->m_checkSumTotal, 0);
        CHECK_EQUAL(m_uut->m_bytesProcessed.size(), 0);
        CHECK_EQUAL(m_uut->m_payload, "");
        CHECK(!m_uut->m_escapedCharacter);
        CHECK_EQUAL(m_uut->m_packetFrame, CTSNCommon::XBeeConstants::PacketFrame::UNKNOWN);
        CHECK_EQUAL(m_uut->m_transmitRetryCount, 0);
        CHECK_EQUAL(m_uut->m_txStatus, CTSNCommon::XBeeConstants::TxStatus::UNKNOWN_TX_STATUS);
        CHECK_EQUAL(m_uut->m_discoveryStatus, CTSNCommon::XBeeConstants::DiscoveryStatus::UNKNOWN_DISCOVERY_STATUS);

    }

    TEST_TEARDOWN() {
        delete m_uut;
        delete m_callbacks;
    }

    testing::StrictMock<CTSNCommon::MockXBeeCallback> *m_callbacks;
    CTSNCommon::XBeeController *m_uut;
};

TEST(XBeeControllerTest, killTest) {
    m_uut->kill();
    CHECK(!m_uut->isAlive());
    CHECK(!m_uut->m_isAlive);
    CHECK(m_uut->m_dataSemaphore.isShutdown());
}

TEST(XBeeControllerTest, verboseStateTest) {
    std::uint8_t checksum = 0xF9;
    std::vector<std::uint8_t> data = {
        0x00,           //Garbage data
        0x01,           //Garbage data
        CTSNCommon::XBeeConstants::START_CHARACTER, // Start Character
        0x00,           // Length1
        0x14,           // Length of 22
        CTSNCommon::XBeeConstants::PacketFrame::RECEIVE_PACKET, // Frame Type - 0x90
        0x01,           // Frame ID
        0x00,           // Address 1
        0x00,           // Address 2
        0x00,           // Address 3
        0x00,           // Address 4
        0x00,           // Address 5
        0x00,           // Address 6
        0xff,           // Address 7
        0Xff,           // Reserved 1
        0xfe,           // Reserved 2
        0x02,           // Recv Options
        'H',            // Payload - 0x48
        'e',            // 0x65
        'l',            // 0x6c
        'l',            // 0x6c
        'o',            // 0x6f
        ' ',            // 0x20
        ':',            // 0x3a
        ')',            // 0x29
        checksum        // Checksum
    };

    m_uut->kill(false); // Ensure the run loop does not go forever
    m_uut->addData(data); // Add the data to the queue

    // Ensure the semaphore count and the number of stuff in the data
    // queue match up.
    CHECK_EQUAL(m_uut->m_dataSemaphore.getSemaphoreCount(), data.size());
    CHECK_EQUAL(m_uut->m_dataSemaphore.getSemaphoreCount(), m_uut->m_data.size());

    // First character: Garbage data.  Should remain in startup state.
    m_uut->run();
    CHECK_EQUAL(m_uut->m_currentState, CTSNCommon::XBeeController::State::STARTUP);
    CHECK_EQUAL(m_uut->m_dataSemaphore.getSemaphoreCount(), data.size() - 1);
    CHECK_EQUAL(m_uut->m_data.size(), data.size() - 1);
    CHECK_EQUAL(m_uut->m_dataLength, 0);
    CHECK(m_uut->m_bytesProcessed.empty());

    // Second character: Garbage data.  Should remain in startup state.
    m_uut->run();
    CHECK_EQUAL(m_uut->m_currentState, CTSNCommon::XBeeController::State::STARTUP);
    CHECK_EQUAL(m_uut->m_dataSemaphore.getSemaphoreCount(), data.size() - 2);
    CHECK_EQUAL(m_uut->m_data.size(), data.size() - 2);
    CHECK_EQUAL(m_uut->m_dataLength, 0);
    CHECK(m_uut->m_bytesProcessed.empty());


    // Third Character: Start character.  Should go to MSG_START state.
    m_uut->run();
    CHECK_EQUAL(m_uut->m_currentState, CTSNCommon::XBeeController::State::MSG_START);
    CHECK_EQUAL(m_uut->m_dataSemaphore.getSemaphoreCount(), data.size() - 3);
    CHECK_EQUAL(m_uut->m_data.size(), data.size() - 3);
    CHECK_EQUAL(m_uut->m_dataLength, 0);
    CHECK_EQUAL(m_uut->m_bytesProcessed[0], data[2]);
    CHECK_EQUAL(m_uut->m_bytesProcessed.size(), 1);


    // Forth Character: MSB Length.  Should go to LENGTH1 State
    m_uut->run();
    CHECK_EQUAL(m_uut->m_currentState, CTSNCommon::XBeeController::State::GOT_LENGTH1);
    CHECK_EQUAL(m_uut->m_dataSemaphore.getSemaphoreCount(), data.size() - 4);
    CHECK_EQUAL(m_uut->m_data.size(), data.size() - 4);
    CHECK_EQUAL(m_uut->m_dataLength, 0); // Length is still zero.
    CHECK_EQUAL(m_uut->m_bytesProcessed[1], data[3]);
    CHECK_EQUAL(m_uut->m_bytesProcessed.size(), 2);


    // Fifth Character: LSB Length.  Should go into LENGTH2 State
    m_uut->run();
    CHECK_EQUAL(m_uut->m_currentState, CTSNCommon::XBeeController::State::GOT_LENGTH2);
    CHECK_EQUAL(m_uut->m_dataSemaphore.getSemaphoreCount(), data.size() - 5);
    CHECK_EQUAL(m_uut->m_data.size(), data.size() - 5);
    CHECK_EQUAL(m_uut->m_dataLength, 0x14); // Length is now what is expected.
    CHECK_EQUAL(m_uut->m_bytesProcessed[2], data[4]);
    CHECK_EQUAL(m_uut->m_bytesProcessed.size(), 3);


    std::uint8_t runningCheckSum = 0;
    // 5th -17th characters: ignore this stuff, we dont care until the payload.
    // However, we need to keep track of the checksum at this point.  The Checksum
    // is the sum of all the bits... but only in 8 bit form.
    for (size_t i = 5; i < 17; ++i) {
        runningCheckSum += data[i];

        m_uut->run();
        if (i == 16) {
            // At this point, we want to move on to reading the payload
            CHECK_EQUAL(m_uut->m_currentState, CTSNCommon::XBeeController::State::PARSE_PAYLOAD);
        }
        else {
            // Still have more characters to ignore!
            CHECK_EQUAL(m_uut->m_currentState, CTSNCommon::XBeeController::State::IGNORE_OPTIONS);
        }
        CHECK_EQUAL(m_uut->m_dataSemaphore.getSemaphoreCount(), data.size() - i - 1);
        CHECK_EQUAL(m_uut->m_data.size(), data.size() - i - 1);
        CHECK_EQUAL(m_uut->m_checkSumTotal, runningCheckSum);
        CHECK_EQUAL(m_uut->m_bytesProcessed[i - 2], data[i]);
        CHECK_EQUAL(m_uut->m_bytesProcessed.size(), i - 1);
    }

    // Characters 20 - 27, The payload.  The data we actually care about.
    for (size_t i = 17; i < 25; ++i) {
        runningCheckSum += data[i];

        m_uut->run();
        if (i == 24) {
            //We read the entire payload.  Move on to check the checksum.
            CHECK_EQUAL(m_uut->m_currentState, CTSNCommon::XBeeController::State::CHECK_CHECKSUM);
            CHECK_EQUAL(m_uut->m_payload, "Hello :)");
        }
        else {
            CHECK_EQUAL(m_uut->m_currentState, CTSNCommon::XBeeController::State::PARSE_PAYLOAD);
        }
        CHECK_EQUAL(m_uut->m_dataSemaphore.getSemaphoreCount(), data.size() - i - 1);
        CHECK_EQUAL(m_uut->m_data.size(), data.size() - i - 1);
        CHECK_EQUAL(m_uut->m_checkSumTotal, runningCheckSum);
        CHECK_EQUAL(m_uut->m_bytesProcessed[i - 2], data[i]);
        CHECK_EQUAL(m_uut->m_bytesProcessed.size(), i - 1);
    }

    // LAST CHARACTER! Ensure the checksum is correct.

    //Ensure OUR test checksum is correct
    CHECK_EQUAL(0xff - runningCheckSum, checksum);

    // Ensure the uut's checksum is what we expect
    CHECK_EQUAL(0xff - m_uut->m_checkSumTotal, checksum);

    // Ensure the callback will get called when the checksum is good.
    EXPECT_CALL(*m_callbacks, successfulParse("Hello :)"));

    m_uut->run();  // Run the last state.

    CHECK_EQUAL(m_uut->m_currentState, CTSNCommon::XBeeController::State::STARTUP);
    CHECK_EQUAL(m_uut->m_dataSemaphore.getSemaphoreCount(), 0);
    CHECK_EQUAL(m_uut->m_data.size(), 0);

    // Everything should reset
    CHECK_EQUAL(m_uut->m_dataLength, 0);
    CHECK_EQUAL(m_uut->m_bytesProcessed.size(), 0);
    CHECK_EQUAL(m_uut->m_checkSumTotal, 0);
    CHECK_EQUAL(m_uut->m_payload, "");
}

/**
 * \brief tests to see that a bad checksum will put the thing in the right state.
 */
TEST(XBeeControllerTest, badChecksumTest) {
    std::vector<std::uint8_t> data = {
        CTSNCommon::XBeeConstants::START_CHARACTER, // Start Character
        0x00,           // Length1
        0x14,           // Length of 20
        CTSNCommon::XBeeConstants::PacketFrame::RECEIVE_PACKET, // Frame Type
        0x01,           // Frame ID
        0x00,           // Address 1
        0x00,           // Address 2
        0x00,           // Address 3
        0x00,           // Address 4
        0x00,           // Address 5
        0x00,           // Address 6
        0xff,           // Address 7
        0Xff,           // Reserved 1
        0xfe,           // Reserved 2
        0x02,           // Recv Options
        'H',            // Payload
        'e',
        'l',
        'l',
        'o',
        ' ',
        ':',
        ')',
        0x70            // Checksum
    };

    // When callback is called, kill the thread.
    auto killFunc = [&](){m_uut->kill(true);};
    EXPECT_CALL(*m_callbacks, badChecksum(data))
        .WillOnce(testing::InvokeWithoutArgs(killFunc));

    m_uut->start();
    m_uut->addData(data);
    m_uut->join();

    // Everything should reset
    CHECK_EQUAL(m_uut->m_dataLength, 0);
    CHECK_EQUAL(m_uut->m_bytesProcessed.size(), 0);
    CHECK_EQUAL(m_uut->m_checkSumTotal, 0);
    CHECK_EQUAL(m_uut->m_payload, "");
    CHECK_EQUAL(m_uut->m_currentState, CTSNCommon::XBeeController::State::STARTUP);
}

/////
/// Incomplete Message Tests
/////
TEST(XBeeControllerTest, incompleteMessageStartupState) {
    std::vector<std::uint8_t> data = {
        CTSNCommon::XBeeConstants::START_CHARACTER,
        CTSNCommon::XBeeConstants::START_CHARACTER // Premature start char
    };

    // Get the expected data to be passed through
    std::vector<std::uint8_t> expectedPrintedData = data;
    expectedPrintedData.pop_back();

    // When callback is called, kill the thread.
    auto killFunc = [&](){m_uut->kill(true);};
    EXPECT_CALL(*m_callbacks, incompleteMessage(expectedPrintedData))
        .WillOnce(testing::InvokeWithoutArgs(killFunc));

    m_uut->start();
    m_uut->addData(data);
    m_uut->join();

    // Everything should returm back to the msg_start state
    CHECK_EQUAL(m_uut->m_dataLength, 0);
    CHECK_EQUAL(m_uut->m_bytesProcessed.size(), 1); // Invalid start char should be there
    CHECK_EQUAL(m_uut->m_bytesProcessed[0], CTSNCommon::XBeeConstants::START_CHARACTER);
    CHECK_EQUAL(m_uut->m_checkSumTotal, 0); // No checksum yet
    CHECK_EQUAL(m_uut->m_payload, ""); // No payload yet
    CHECK_EQUAL(m_uut->m_currentState, CTSNCommon::XBeeController::State::MSG_START);
}

TEST(XBeeControllerTest, incompleteMessageGotLength1State) {
    std::vector<std::uint8_t> data = {
        CTSNCommon::XBeeConstants::START_CHARACTER,
        0x00,
        CTSNCommon::XBeeConstants::START_CHARACTER // Premature start char
    };

    // Get the expected data to be passed through
    std::vector<std::uint8_t> expectedPrintedData = data;
    expectedPrintedData.pop_back();

    // When callback is called, kill the thread.
    auto killFunc = [&](){m_uut->kill(true);};
    EXPECT_CALL(*m_callbacks, incompleteMessage(expectedPrintedData))
        .WillOnce(testing::InvokeWithoutArgs(killFunc));

    m_uut->start();
    m_uut->addData(data);
    m_uut->join();

    // Everything should returm back to the msg_start state
    CHECK_EQUAL(m_uut->m_dataLength, 0);
    CHECK_EQUAL(m_uut->m_bytesProcessed.size(), 1); // Invalid start char should be there
    CHECK_EQUAL(m_uut->m_bytesProcessed[0], CTSNCommon::XBeeConstants::START_CHARACTER);
    CHECK_EQUAL(m_uut->m_checkSumTotal, 0); // No checksum yet
    CHECK_EQUAL(m_uut->m_payload, ""); // No payload yet
    CHECK_EQUAL(m_uut->m_currentState, CTSNCommon::XBeeController::State::MSG_START);
}

TEST(XBeeControllerTest, incompleteMessageGotLength2State) {
    std::vector<std::uint8_t> data = {
        CTSNCommon::XBeeConstants::START_CHARACTER,
        0x00,
        0x14,
        CTSNCommon::XBeeConstants::START_CHARACTER // Premature start char
    };

    // Get the expected data to be passed through
    std::vector<std::uint8_t> expectedPrintedData = data;
    expectedPrintedData.pop_back();

    // When callback is called, kill the thread.
    auto killFunc = [&](){m_uut->kill(true);};
    EXPECT_CALL(*m_callbacks, incompleteMessage(expectedPrintedData))
        .WillOnce(testing::InvokeWithoutArgs(killFunc));

    m_uut->start();
    m_uut->addData(data);
    m_uut->join();

    // Everything should returm back to the msg_start state
    CHECK_EQUAL(m_uut->m_dataLength, 0);
    CHECK_EQUAL(m_uut->m_bytesProcessed.size(), 1); // Invalid start char should be there
    CHECK_EQUAL(m_uut->m_bytesProcessed[0], CTSNCommon::XBeeConstants::START_CHARACTER);
    CHECK_EQUAL(m_uut->m_checkSumTotal, 0); // No checksum yet
    CHECK_EQUAL(m_uut->m_payload, ""); // No payload yet
    CHECK_EQUAL(m_uut->m_currentState, CTSNCommon::XBeeController::State::MSG_START);
}

TEST(XBeeControllerTest, incompleteMessageIgnoreOptionsState) {
    std::vector<std::uint8_t> data = {
        CTSNCommon::XBeeConstants::START_CHARACTER,
        0x00,
        0x14,
        CTSNCommon::XBeeConstants::PacketFrame::RECEIVE_PACKET, // Frame Type
        0x01,           // Frame ID
        0x00,           // Address 1
        0x00,           // Address 2
        0x00,           // Address 3
        0x00,           // Address 4
        0x00,           // Address 5
        0x00,           // Address 6
        0xff,           // Address 7
        CTSNCommon::XBeeConstants::START_CHARACTER // Premature start char
    };

    // Get the expected data to be passed through
    std::vector<std::uint8_t> expectedPrintedData = data;
    expectedPrintedData.pop_back();

    // When callback is called, kill the thread.
    auto killFunc = [&](){m_uut->kill(true);};
    EXPECT_CALL(*m_callbacks, incompleteMessage(expectedPrintedData))
        .WillOnce(testing::InvokeWithoutArgs(killFunc));

    m_uut->start();
    m_uut->addData(data);
    m_uut->join();

    // Everything should returm back to the msg_start state
    CHECK_EQUAL(m_uut->m_dataLength, 0);
    CHECK_EQUAL(m_uut->m_bytesProcessed.size(), 1); // Invalid start char should be there
    CHECK_EQUAL(m_uut->m_bytesProcessed[0], CTSNCommon::XBeeConstants::START_CHARACTER);
    CHECK_EQUAL(m_uut->m_checkSumTotal, 0); // No checksum yet
    CHECK_EQUAL(m_uut->m_payload, ""); // No payload yet
    CHECK_EQUAL(m_uut->m_currentState, CTSNCommon::XBeeController::State::MSG_START);
}

TEST(XBeeControllerTest, incompleteMessageParsePayloadState) {
    std::vector<std::uint8_t> data = {
        CTSNCommon::XBeeConstants::START_CHARACTER,
        0x00,
        0x14,
        CTSNCommon::XBeeConstants::PacketFrame::RECEIVE_PACKET, // Frame Type
        0x01,           // Frame ID
        0x00,           // Address 1
        0x00,           // Address 2
        0x00,           // Address 3
        0x00,           // Address 4
        0x00,           // Address 5
        0x00,           // Address 6
        0xff,           // Address 7
        0xff,           // Reserved 1
        0xfe,           // Reserved 2
        0x02,           // Options
        'H',            // Payload
        'e',
        'l',
        'l',
        'o',
        ' ',
        CTSNCommon::XBeeConstants::START_CHARACTER // Premature start char
    };

    // Get the expected data to be passed through
    std::vector<std::uint8_t> expectedPrintedData = data;
    expectedPrintedData.pop_back();

    // When callback is called, kill the thread.
    auto killFunc = [&](){m_uut->kill(true);};
    EXPECT_CALL(*m_callbacks, incompleteMessage(expectedPrintedData))
        .WillOnce(testing::InvokeWithoutArgs(killFunc));

    m_uut->start();
    m_uut->addData(data);
    m_uut->join();

    // Everything should returm back to the msg_start state
    CHECK_EQUAL(m_uut->m_dataLength, 0);
    CHECK_EQUAL(m_uut->m_bytesProcessed.size(), 1); // Invalid start char should be there
    CHECK_EQUAL(m_uut->m_bytesProcessed[0], CTSNCommon::XBeeConstants::START_CHARACTER);
    CHECK_EQUAL(m_uut->m_checkSumTotal, 0); // No checksum yet
    CHECK_EQUAL(m_uut->m_payload, ""); // No payload yet
    CHECK_EQUAL(m_uut->m_currentState, CTSNCommon::XBeeController::State::MSG_START);
}

TEST(XBeeControllerTest, incompleteMessageCheckCheckSumState) {
    std::vector<std::uint8_t> data = {
        CTSNCommon::XBeeConstants::START_CHARACTER,
        0x00,
        0x12,
        CTSNCommon::XBeeConstants::PacketFrame::RECEIVE_PACKET, // Frame Type
        0x01,           // Frame ID
        0x00,           // Address 1
        0x00,           // Address 2
        0x00,           // Address 3
        0x00,           // Address 4
        0x00,           // Address 5
        0x00,           // Address 6
        0xff,           // Address 7
        0xff,           // Reserved 1
        0xfe,           // Reserved 2
        0x02,           // Options
        'H',            // Payload
        'e',
        'l',
        'l',
        'o',
        ' ',
        CTSNCommon::XBeeConstants::START_CHARACTER // Premature start char
    };

    std::vector<std::uint8_t> expectedPrintedData = data;
    expectedPrintedData.pop_back();

    // When callback is called, kill the thread.
    auto killFunc = [&](){m_uut->kill(true);};
    EXPECT_CALL(*m_callbacks, incompleteMessage(expectedPrintedData))
        .WillOnce(testing::InvokeWithoutArgs(killFunc));

    m_uut->start();
    m_uut->addData(data);
    m_uut->join();

    // Everything should returm back to the msg_start state
    CHECK_EQUAL(m_uut->m_dataLength, 0);
    CHECK_EQUAL(m_uut->m_bytesProcessed.size(), 1); // Invalid start char should be there
    CHECK_EQUAL(m_uut->m_bytesProcessed[0], CTSNCommon::XBeeConstants::START_CHARACTER);
    CHECK_EQUAL(m_uut->m_checkSumTotal, 0); // No checksum yet
    CHECK_EQUAL(m_uut->m_payload, ""); // No payload yet
    CHECK_EQUAL(m_uut->m_currentState, CTSNCommon::XBeeController::State::MSG_START);
}



/**
 * \brief Ensures that handleMessageStartState will make the MSB correct
 */
TEST(XBeeControllerTest, handleMessageStartStateMSBTest) {
    std::vector<std::uint8_t> data = {0xff};
    m_uut->addData(data);
    m_uut->handleMessageStartState();

    CHECK_EQUAL(m_uut->m_dataLength, 0xff00);
    CHECK_EQUAL(m_uut->m_currentState, CTSNCommon::XBeeController::State::GOT_LENGTH1);
}

/**
 * \brief Ensures that handleLength1State will make the LSB correct
 */
TEST(XBeeControllerTest, handleGotLength1StateLSBTest) {
    std::vector<std::uint8_t> data = {0xff};
    m_uut->addData(data);
    m_uut->handleGotLength1State();

    CHECK_EQUAL(m_uut->m_dataLength, 0x00ff);
    CHECK_EQUAL(m_uut->m_currentState, CTSNCommon::XBeeController::State::GOT_LENGTH2);
}

TEST(XBeeControllerTest, nonVerboseSuccessTest) {
    std::vector<std::uint8_t> data = {
        CTSNCommon::XBeeConstants::START_CHARACTER,
        0x00,
        0x14,
        CTSNCommon::XBeeConstants::PacketFrame::RECEIVE_PACKET, // Frame Type
        0x01,           // Frame ID
        0x00,           // Address 1
        0x00,           // Address 2
        0x00,           // Address 3
        0x00,           // Address 4
        0x00,           // Address 5
        0x00,           // Address 6
        0xff,           // Address 7
        0xff,           // Reserved 1
        0xfe,           // Reserved 2
        0x02,           // Options
        'H',            // Payload
        'e',
        'l',
        'l',
        'o',
        ' ',
        ':',
        ')',
        0xF9
    };

    // When callback is called, kill the thread.
    auto killFunc = [&](){m_uut->kill(true);};
    EXPECT_CALL(*m_callbacks, successfulParse("Hello :)"))
        .WillOnce(testing::InvokeWithoutArgs(killFunc));

    m_uut->start();
    m_uut->addData(data);
    m_uut->join();

    // Everything should returm back to the startup state
    CHECK_EQUAL(m_uut->m_dataLength, 0);
    CHECK_EQUAL(m_uut->m_bytesProcessed.size(), 0);
    CHECK_EQUAL(m_uut->m_checkSumTotal, 0);
    CHECK_EQUAL(m_uut->m_payload, "");
    CHECK_EQUAL(m_uut->m_currentState, CTSNCommon::XBeeController::State::STARTUP);
}

TEST(XBeeControllerTest, badStateTest) {
    std::vector<std::uint8_t> data = {
        CTSNCommon::XBeeConstants::START_CHARACTER,
        0x00,
        0x14,
        CTSNCommon::XBeeConstants::PacketFrame::RECEIVE_PACKET, // Frame Type
        0x01,           // Frame ID
        0x00,           // Address 1
        0x00,           // Address 2
        0x00,           // Address 3
        0x00,           // Address 4
        0x00,           // Address 5
        0x00,           // Address 6
        0xff,           // Address 7
        0xff,           // Reserved 1
        0xfe,           // Reserved 2
        0x02            // Recv Options
    };
    m_uut->m_bytesProcessed = data;
    m_uut->m_currentState = static_cast<CTSNCommon::XBeeController::State>(-1);

    EXPECT_CALL(*m_callbacks, badState(data));

    m_uut->handleData();

    // Everything should returm back to the startup state
    CHECK_EQUAL(m_uut->m_dataLength, 0);
    CHECK_EQUAL(m_uut->m_bytesProcessed.size(), 0);
    CHECK_EQUAL(m_uut->m_checkSumTotal, 0);
    CHECK_EQUAL(m_uut->m_payload, "");
    CHECK_EQUAL(m_uut->m_currentState, CTSNCommon::XBeeController::State::STARTUP);
}

TEST(XBeeControllerTest, destructorSuccessTest) {
    std::vector<std::uint8_t> data = {
        CTSNCommon::XBeeConstants::START_CHARACTER,
        0x00,
        0x14,
        CTSNCommon::XBeeConstants::PacketFrame::RECEIVE_PACKET, // Frame Type
        0x01,           // Frame ID
        0x00,           // Address 1
        0x00,           // Address 2
        0x00,           // Address 3
        0x00,           // Address 4
        0x00,           // Address 5
        0x00,           // Address 6
        0xff,           // Address 7
        0xff,           // Reserved 1
        0xfe,           // Reserved 2
        0x02,           // Options
        'H',            // Payload
        'e',
        'l',
        'l',
        'o',
        ' ',
        ':',
        ')',
        0xF9
    };

    // When callback is called, kill the thread.
    EXPECT_CALL(*m_callbacks, successfulParse("Hello :)"));

    m_uut->addData(data);
    delete m_uut;
    m_uut = nullptr;
}

///Escape characters test
TEST(XBeeControllerTest, escapeCharacterSuccessTest) {
    std::vector<std::uint8_t> data = {
        CTSNCommon::XBeeConstants::START_CHARACTER,
        0x00,   // Length 1
        CTSNCommon::XBeeConstants::ESCAPE_CHARACTER,
        static_cast<uint8_t>(CTSNCommon::XBeeConstants::XOFF ^ CTSNCommon::XBeeConstants::ESCAPE_XOR), // Length 2, 19 in dec
        CTSNCommon::XBeeConstants::PacketFrame::RECEIVE_PACKET, // Frame Type 0x90
        0x01,           // Frame ID
        0x00,           // Address 1
        CTSNCommon::XBeeConstants::ESCAPE_CHARACTER, // 0x7D
        static_cast<uint8_t>(CTSNCommon::XBeeConstants::START_CHARACTER ^ CTSNCommon::XBeeConstants::ESCAPE_XOR),  // Address 2 - 0x7E
        CTSNCommon::XBeeConstants::ESCAPE_CHARACTER,
        static_cast<uint8_t>(CTSNCommon::XBeeConstants::ESCAPE_CHARACTER ^ CTSNCommon::XBeeConstants::ESCAPE_XOR), // Address 3 - 0x7D
        CTSNCommon::XBeeConstants::ESCAPE_CHARACTER, //
        static_cast<uint8_t>(CTSNCommon::XBeeConstants::XON ^ CTSNCommon::XBeeConstants::ESCAPE_XOR),             // Address 4 - 0x11
        0x00,           // Address 5
        0x00,           // Address 6
        0xff,           // Address 7
        0xff,           // Reserved 1
        0xfe,           // Reserved 2
        0x02,           // Options
        'H',            // 0x48
        'I',            // 0x49
        ' ',            // 0x20
        ' ',            // 0x20
        ':',            // 0x3A
        ')',            // 0x29
        CTSNCommon::XBeeConstants::ESCAPE_CHARACTER, // 0x7D
        static_cast<uint8_t>(CTSNCommon::XBeeConstants::START_CHARACTER ^ CTSNCommon::XBeeConstants::ESCAPE_XOR),  // 0x7E
        0xB2
    };

    // When callback is called, kill the thread.
    auto killFunc = [&](){m_uut->kill(true);};
    EXPECT_CALL(*m_callbacks, successfulParse("HI  :)~"))
        .WillOnce(testing::InvokeWithoutArgs(killFunc));

    m_uut->start();
    m_uut->addData(data);
    m_uut->join();

    // Everything should returm back to the startup state
    CHECK_EQUAL(m_uut->m_dataLength, 0);
    CHECK_EQUAL(m_uut->m_bytesProcessed.size(), 0);
    CHECK_EQUAL(m_uut->m_checkSumTotal, 0);
    CHECK_EQUAL(m_uut->m_payload, "");
    CHECK(!m_uut->m_escapedCharacter);
    CHECK_EQUAL(m_uut->m_nonEscapedBytesProcessed, 0);
    CHECK_EQUAL(m_uut->m_lengthCounter, 0);
    CHECK_EQUAL(m_uut->m_currentState, CTSNCommon::XBeeController::State::STARTUP);
}

///Escape characters test
TEST(XBeeControllerTest, escapeCharacterMassiveLengthSuccessTest) {
    std::vector<std::uint8_t> data = {
        CTSNCommon::XBeeConstants::START_CHARACTER,
        CTSNCommon::XBeeConstants::ESCAPE_CHARACTER,
        static_cast<uint8_t>(CTSNCommon::XBeeConstants::XOFF ^ CTSNCommon::XBeeConstants::ESCAPE_XOR),          // Length 1
        0x00,           // Length 2
        CTSNCommon::XBeeConstants::PacketFrame::RECEIVE_PACKET, // Frame Type
        0x01,           // Frame ID
        0x00,           // Address 1
        0x00,           // Address 2
        0x00,           // Address 3
        0x00,           // Address 4
        0x00,           // Address 5
        0x00,           // Address 6
        0xff,           // Address 7
        0xff,           // Reserved 1
        0xfe,           // Reserved 2
        0x02,           // Options
    };

    // Build string
    std::string expectedString;

    // Size is length 1 - 12, the
    // amount of chars betfore the payload
    // and after the length.
    // Remember to de-xor it.
    uint16_t size = data[2] ^ CTSNCommon::XBeeConstants::ESCAPE_XOR;
    size = size << 8;
    CHECK_EQUAL(size, 4864);
    size -= 12;

    for (size_t i = 0; i < size; ++i ){
        data.push_back('A');
        expectedString += 'A';
    }

    //Get Checksum
    uint8_t checksum = 0;
    for (size_t i = 4; i < data.size(); ++i) {
        checksum += data[i];
    }

    data.push_back(0xff - checksum);

    // When callback is called, kill the thread.
    auto killFunc = [&](){m_uut->kill(true);};
    EXPECT_CALL(*m_callbacks, successfulParse(expectedString))
        .WillOnce(testing::InvokeWithoutArgs(killFunc));

    m_uut->start();
    m_uut->addData(data);
    m_uut->join();

    // Everything should returm back to the startup state
    CHECK_EQUAL(m_uut->m_dataLength, 0);
    CHECK_EQUAL(m_uut->m_bytesProcessed.size(), 0);
    CHECK_EQUAL(m_uut->m_checkSumTotal, 0);
    CHECK_EQUAL(m_uut->m_payload, "");
    CHECK(!m_uut->m_escapedCharacter);
    CHECK_EQUAL(m_uut->m_nonEscapedBytesProcessed, 0);
    CHECK_EQUAL(m_uut->m_lengthCounter, 0);
    CHECK_EQUAL(m_uut->m_currentState, CTSNCommon::XBeeController::State::STARTUP);
}

TEST(XBeeControllerTest, escapedCheckSumTest) {
    std::vector<std::uint8_t> data = {
        CTSNCommon::XBeeConstants::START_CHARACTER,
        0x00,
        0x0e,
        CTSNCommon::XBeeConstants::PacketFrame::RECEIVE_PACKET, // Frame Type 0x90
        0x01,           // Frame ID
        0x00,           // Address 1
        0x00,           // Address 2
        0x00,           // Address 3
        0x00,           // Address 4
        0x00,           // Address 5
        0x00,           // Address 6
        0xff,           // Address 7
        0xff,           // Reserved 1
        0xfe,           // Reserved 2
        0x02,           // Options
        'x',            // Payload - 0x78
        'z',            // 0x7A
        CTSNCommon::XBeeConstants::ESCAPE_CHARACTER,
        static_cast<uint8_t>(0x7E ^ CTSNCommon::XBeeConstants::ESCAPE_XOR) // The start character
    };

    // When callback is called, kill the thread.
    auto killFunc = [&](){m_uut->kill(true);};
    EXPECT_CALL(*m_callbacks, successfulParse("xz"))
        .WillOnce(testing::InvokeWithoutArgs(killFunc));

    m_uut->start();
    m_uut->addData(data);
    m_uut->join();

    // Everything should returm back to the startup state
    CHECK_EQUAL(m_uut->m_dataLength, 0);
    CHECK_EQUAL(m_uut->m_bytesProcessed.size(), 0);
    CHECK_EQUAL(m_uut->m_checkSumTotal, 0);
    CHECK_EQUAL(m_uut->m_payload, "");
    CHECK_EQUAL(m_uut->m_currentState, CTSNCommon::XBeeController::State::STARTUP);
}

/////
/// Modem Status Tests
/////
TEST(XBeeControllerTest, modemStatusHardwareReset) {
    std::vector<std::uint8_t> data = {
        CTSNCommon::XBeeConstants::START_CHARACTER,
        0x00,
        0x02,
        CTSNCommon::XBeeConstants::PacketFrame::MODEM_STATUS,     // Frame Type - 0x8A
        CTSNCommon::XBeeConstants::ModemStatus::HARDWARE_RESET, // Status - 0x00
        0x75
    };

    // When callback is called, kill the thread.
    auto killFunc = [&](){m_uut->kill(true);};
    EXPECT_CALL(*m_callbacks, hardwareReset())
        .WillOnce(testing::InvokeWithoutArgs(killFunc));

    m_uut->start();
    m_uut->addData(data);
    m_uut->join();

    // Everything should returm back to the startup state
    CHECK_EQUAL(m_uut->m_dataLength, 0);
    CHECK_EQUAL(m_uut->m_bytesProcessed.size(), 0);
    CHECK_EQUAL(m_uut->m_checkSumTotal, 0);
    CHECK_EQUAL(m_uut->m_payload, "");
    CHECK_EQUAL(m_uut->m_currentState, CTSNCommon::XBeeController::State::STARTUP);
}

TEST(XBeeControllerTest, modemWatchdogTimerReset) {
    std::vector<std::uint8_t> data = {
        CTSNCommon::XBeeConstants::START_CHARACTER,
        0x00,
        0x02,
        CTSNCommon::XBeeConstants::PacketFrame::MODEM_STATUS,     // Frame Type - 0x8A
        CTSNCommon::XBeeConstants::ModemStatus::WATCHDOG_TIMER_RESET, // Status - 0x01
        0x74
    };

    // When callback is called, kill the thread.
    auto killFunc = [&](){m_uut->kill(true);};
    EXPECT_CALL(*m_callbacks, watchdogTimerReset())
        .WillOnce(testing::InvokeWithoutArgs(killFunc));

    m_uut->start();
    m_uut->addData(data);
    m_uut->join();

    // Everything should returm back to the startup state
    CHECK_EQUAL(m_uut->m_dataLength, 0);
    CHECK_EQUAL(m_uut->m_bytesProcessed.size(), 0);
    CHECK_EQUAL(m_uut->m_checkSumTotal, 0);
    CHECK_EQUAL(m_uut->m_payload, "");
    CHECK_EQUAL(m_uut->m_currentState, CTSNCommon::XBeeController::State::STARTUP);
}

TEST(XBeeControllerTest, modemNetworkWentToSleep) {
    std::vector<std::uint8_t> data = {
        CTSNCommon::XBeeConstants::START_CHARACTER,
        0x00,
        0x02,
        CTSNCommon::XBeeConstants::PacketFrame::MODEM_STATUS,     // Frame Type - 0x8A
        CTSNCommon::XBeeConstants::ModemStatus::NETWORK_WENT_TO_SLEEP, // Status - 0x0b
        0x6a
    };

    // When callback is called, kill the thread.
    auto killFunc = [&](){m_uut->kill(true);};
    EXPECT_CALL(*m_callbacks, networkWentToSleep())
        .WillOnce(testing::InvokeWithoutArgs(killFunc));

    m_uut->start();
    m_uut->addData(data);
    m_uut->join();

    // Everything should returm back to the startup state
    CHECK_EQUAL(m_uut->m_dataLength, 0);
    CHECK_EQUAL(m_uut->m_bytesProcessed.size(), 0);
    CHECK_EQUAL(m_uut->m_checkSumTotal, 0);
    CHECK_EQUAL(m_uut->m_payload, "");
    CHECK_EQUAL(m_uut->m_currentState, CTSNCommon::XBeeController::State::STARTUP);
}

TEST(XBeeControllerTest, modemNetworkWokeUp) {
    std::vector<std::uint8_t> data = {
        CTSNCommon::XBeeConstants::START_CHARACTER,
        0x00,
        0x02,
        CTSNCommon::XBeeConstants::PacketFrame::MODEM_STATUS,     // Frame Type - 0x8A
        CTSNCommon::XBeeConstants::ModemStatus::NETWORK_WOKE_UP, // Status - 0x0c
        0x69
    };

    // When callback is called, kill the thread.
    auto killFunc = [&](){m_uut->kill(true);};
    EXPECT_CALL(*m_callbacks, networkWokeUp())
        .WillOnce(testing::InvokeWithoutArgs(killFunc));

    m_uut->start();
    m_uut->addData(data);
    m_uut->join();

    // Everything should returm back to the startup state
    CHECK_EQUAL(m_uut->m_dataLength, 0);
    CHECK_EQUAL(m_uut->m_bytesProcessed.size(), 0);
    CHECK_EQUAL(m_uut->m_checkSumTotal, 0);
    CHECK_EQUAL(m_uut->m_payload, "");
    CHECK_EQUAL(m_uut->m_currentState, CTSNCommon::XBeeController::State::STARTUP);
}

TEST(XBeeControllerTest, invalidModemStatus) {
    std::vector<std::uint8_t> data = {
        CTSNCommon::XBeeConstants::START_CHARACTER,
        0x00,
        0x02,
        CTSNCommon::XBeeConstants::PacketFrame::MODEM_STATUS,     // Frame Type - 0x8A
        CTSNCommon::XBeeConstants::ModemStatus::UNKNOWN_STATUS, // Status - 0xFF
        0x76
    };

    // When callback is called, kill the thread.
    auto killFunc = [&](){m_uut->kill(true);};
    EXPECT_CALL(*m_callbacks, invalidModemStatus(CTSNCommon::XBeeConstants::ModemStatus::UNKNOWN_STATUS))
        .WillOnce(testing::InvokeWithoutArgs(killFunc));

    m_uut->start();
    m_uut->addData(data);
    m_uut->join();

    // Everything should returm back to the startup state
    CHECK_EQUAL(m_uut->m_dataLength, 0);
    CHECK_EQUAL(m_uut->m_bytesProcessed.size(), 0);
    CHECK_EQUAL(m_uut->m_checkSumTotal, 0);
    CHECK_EQUAL(m_uut->m_payload, "");
    CHECK_EQUAL(m_uut->m_currentState, CTSNCommon::XBeeController::State::STARTUP);
}


TEST(XBeeControllerTest, badModemStatusPacket) {
    std::vector<std::uint8_t> data = {
        CTSNCommon::XBeeConstants::START_CHARACTER,
        0x00,
        0x03, // One more than is correct.
        CTSNCommon::XBeeConstants::PacketFrame::MODEM_STATUS,     // Frame Type - 0x8A
        CTSNCommon::XBeeConstants::ModemStatus::HARDWARE_RESET // Status - 0x00
        // Checksum not needed here since we shouldn't get that far.
    };

    // When callback is called, kill the thread.
    auto killFunc = [&](){m_uut->kill(true);};
    EXPECT_CALL(*m_callbacks, badModemStatusPacket(data))
        .WillOnce(testing::InvokeWithoutArgs(killFunc));

    m_uut->start();
    m_uut->addData(data);
    m_uut->join();

    // Everything should returm back to the startup state
    CHECK_EQUAL(m_uut->m_dataLength, 0);
    CHECK_EQUAL(m_uut->m_bytesProcessed.size(), 0);
    CHECK_EQUAL(m_uut->m_checkSumTotal, 0);
    CHECK_EQUAL(m_uut->m_payload, "");
    CHECK_EQUAL(m_uut->m_currentState, CTSNCommon::XBeeController::State::STARTUP);
    CHECK_EQUAL(m_uut->m_packetFrame, CTSNCommon::XBeeConstants::PacketFrame::UNKNOWN);
    CHECK_EQUAL(m_uut->m_modemStatus, CTSNCommon::XBeeConstants::ModemStatus::UNKNOWN_STATUS);
}

TEST(XBeeControllerTest, badHandleSuccessfulParse) {
    std::vector<std::uint8_t> data = {
        CTSNCommon::XBeeConstants::START_CHARACTER,
        0x00,
        0x03, // One more than is correct.
        CTSNCommon::XBeeConstants::PacketFrame::UNKNOWN,
        CTSNCommon::XBeeConstants::ModemStatus::HARDWARE_RESET // Status - 0x00
        // Checksum not needed here since we shouldn't get that far.
    };

    m_uut->m_bytesProcessed = data;
    m_uut->m_packetFrame = CTSNCommon::XBeeConstants::PacketFrame::UNKNOWN;

    EXPECT_CALL(*m_callbacks, badState(data));

    m_uut->handleSuccessfulParse();
}

////
// TxStatusTests
////
TEST(XBeeControllerTest, TxStatusSuccess) {
    std::vector<std::uint8_t> data = {
        CTSNCommon::XBeeConstants::START_CHARACTER,
        0x00,
        0x07,
        CTSNCommon::XBeeConstants::PacketFrame::TRANSMIT_STATUS, // Frame Type - 0x8B
        0x47,   // Frame ID
        0xff,   // Reserved
        0xfe,   // Reserved
        0x01,   // Transmit Retry count
        CTSNCommon::XBeeConstants::TxStatus::SUCCESS,  // Success - 0x00
        CTSNCommon::XBeeConstants::DiscoveryStatus::NO_OVERHEAD, // 0x00
        0x2f
    };

    // When callback is called, kill the thread.
    auto killFunc = [&](){m_uut->kill(true);};
    EXPECT_CALL(*m_callbacks, transmitSuccess(data[7],
                                              CTSNCommon::XBeeConstants::DiscoveryStatus::NO_OVERHEAD))
        .WillOnce(testing::InvokeWithoutArgs(killFunc));

    m_uut->start();
    m_uut->addData(data);
    m_uut->join();

    // Everything should returm back to the startup state
    CHECK_EQUAL(m_uut->m_dataLength, 0);
    CHECK_EQUAL(m_uut->m_bytesProcessed.size(), 0);
    CHECK_EQUAL(m_uut->m_checkSumTotal, 0);
    CHECK_EQUAL(m_uut->m_payload, "");
    CHECK_EQUAL(m_uut->m_currentState, CTSNCommon::XBeeController::State::STARTUP);
    CHECK_EQUAL(m_uut->m_packetFrame, CTSNCommon::XBeeConstants::PacketFrame::UNKNOWN);
    CHECK_EQUAL(m_uut->m_modemStatus, CTSNCommon::XBeeConstants::ModemStatus::UNKNOWN_STATUS);
    CHECK_EQUAL(m_uut->m_transmitRetryCount, 0);
    CHECK_EQUAL(m_uut->m_txStatus, CTSNCommon::XBeeConstants::TxStatus::UNKNOWN_TX_STATUS);
    CHECK_EQUAL(m_uut->m_discoveryStatus, CTSNCommon::XBeeConstants::DiscoveryStatus::UNKNOWN_DISCOVERY_STATUS);
}

TEST(XBeeControllerTest, TxStatusSuccessEscape) {
    std::vector<std::uint8_t> data = {
        CTSNCommon::XBeeConstants::START_CHARACTER,
        0x00,
        0x07,
        CTSNCommon::XBeeConstants::PacketFrame::TRANSMIT_STATUS, // Frame Type - 0x8B
        CTSNCommon::XBeeConstants::ESCAPE_CHARACTER, // 0x7D
        static_cast<uint8_t>(CTSNCommon::XBeeConstants::START_CHARACTER ^ CTSNCommon::XBeeConstants::ESCAPE_XOR),  // Frame ID0x7E
        0xff,   // Reserved
        0xfe,   // Reserved
        CTSNCommon::XBeeConstants::ESCAPE_CHARACTER, // 0x7D
        static_cast<uint8_t>(CTSNCommon::XBeeConstants::START_CHARACTER ^ CTSNCommon::XBeeConstants::ESCAPE_XOR),  // 0x7E
        CTSNCommon::XBeeConstants::TxStatus::SUCCESS,  // Success - 0x00
        CTSNCommon::XBeeConstants::DiscoveryStatus::NO_OVERHEAD, // 0x00
        0x7B
    };

    // When callback is called, kill the thread.
    auto killFunc = [&](){m_uut->kill(true);};
    EXPECT_CALL(*m_callbacks, transmitSuccess(0x7e, CTSNCommon::XBeeConstants::DiscoveryStatus::NO_OVERHEAD))
        .WillOnce(testing::InvokeWithoutArgs(killFunc));

    m_uut->start();
    m_uut->addData(data);
    m_uut->join();

    // Everything should returm back to the startup state
    CHECK_EQUAL(m_uut->m_dataLength, 0);
    CHECK_EQUAL(m_uut->m_bytesProcessed.size(), 0);
    CHECK_EQUAL(m_uut->m_checkSumTotal, 0);
    CHECK_EQUAL(m_uut->m_payload, "");
    CHECK_EQUAL(m_uut->m_currentState, CTSNCommon::XBeeController::State::STARTUP);
    CHECK_EQUAL(m_uut->m_packetFrame, CTSNCommon::XBeeConstants::PacketFrame::UNKNOWN);
    CHECK_EQUAL(m_uut->m_modemStatus, CTSNCommon::XBeeConstants::ModemStatus::UNKNOWN_STATUS);
}

TEST(XBeeControllerTest, TxStatusFailure) {
    std::vector<std::uint8_t> data = {
        CTSNCommon::XBeeConstants::START_CHARACTER,
        0x00,
        0x07,
        CTSNCommon::XBeeConstants::PacketFrame::TRANSMIT_STATUS, // Frame Type - 0x8B
        0x47,   // Frame ID
        0xff,   // Reserved
        0xfe,   // Reserved
        0x01,   // Transmit Retry count
        CTSNCommon::XBeeConstants::TxStatus::ROUTE_NOT_FOUND,  // 0x25
        CTSNCommon::XBeeConstants::DiscoveryStatus::NO_OVERHEAD, // 0x00
        0x0A
    };

    // When callback is called, kill the thread.
    auto killFunc = [&](){m_uut->kill(true);};
    EXPECT_CALL(*m_callbacks, transmitFailure(data[7],
                                              CTSNCommon::XBeeConstants::TxStatus::ROUTE_NOT_FOUND,
                                              CTSNCommon::XBeeConstants::DiscoveryStatus::NO_OVERHEAD))
        .WillOnce(testing::InvokeWithoutArgs(killFunc));

    m_uut->start();
    m_uut->addData(data);
    m_uut->join();

    // Everything should returm back to the startup state
    CHECK_EQUAL(m_uut->m_dataLength, 0);
    CHECK_EQUAL(m_uut->m_bytesProcessed.size(), 0);
    CHECK_EQUAL(m_uut->m_checkSumTotal, 0);
    CHECK_EQUAL(m_uut->m_payload, "");
    CHECK_EQUAL(m_uut->m_currentState, CTSNCommon::XBeeController::State::STARTUP);
    CHECK_EQUAL(m_uut->m_packetFrame, CTSNCommon::XBeeConstants::PacketFrame::UNKNOWN);
    CHECK_EQUAL(m_uut->m_modemStatus, CTSNCommon::XBeeConstants::ModemStatus::UNKNOWN_STATUS);
    CHECK_EQUAL(m_uut->m_transmitRetryCount, 0);
    CHECK_EQUAL(m_uut->m_txStatus, CTSNCommon::XBeeConstants::TxStatus::UNKNOWN_TX_STATUS);
    CHECK_EQUAL(m_uut->m_discoveryStatus, CTSNCommon::XBeeConstants::DiscoveryStatus::UNKNOWN_DISCOVERY_STATUS);
}

TEST(XBeeControllerTest, TxStatusPrematureMessageStart) {
    std::vector<std::uint8_t> data = {
        CTSNCommon::XBeeConstants::START_CHARACTER,
        0x00,
        0x07,
        CTSNCommon::XBeeConstants::PacketFrame::TRANSMIT_STATUS, // Frame Type - 0x8B
        CTSNCommon::XBeeConstants::START_CHARACTER
    };

    std::vector<std::uint8_t> expectedData = data;
    expectedData.pop_back();

    // When callback is called, kill the thread.
    auto killFunc = [&](){m_uut->kill(true);};
    EXPECT_CALL(*m_callbacks, incompleteMessage(expectedData))
        .WillOnce(testing::InvokeWithoutArgs(killFunc));

    m_uut->start();
    m_uut->addData(data);
    m_uut->join();

    // Everything should returm back to the startup state
    CHECK_EQUAL(m_uut->m_dataLength, 0);
    CHECK_EQUAL(m_uut->m_bytesProcessed.size(), 1); // For the new start character
    CHECK_EQUAL(m_uut->m_checkSumTotal, 0);
    CHECK_EQUAL(m_uut->m_payload, "");
    CHECK_EQUAL(m_uut->m_currentState, CTSNCommon::XBeeController::State::MSG_START);
    CHECK_EQUAL(m_uut->m_packetFrame, CTSNCommon::XBeeConstants::PacketFrame::UNKNOWN);
    CHECK_EQUAL(m_uut->m_modemStatus, CTSNCommon::XBeeConstants::ModemStatus::UNKNOWN_STATUS);
    CHECK_EQUAL(m_uut->m_transmitRetryCount, 0);
    CHECK_EQUAL(m_uut->m_txStatus, CTSNCommon::XBeeConstants::TxStatus::UNKNOWN_TX_STATUS);
    CHECK_EQUAL(m_uut->m_discoveryStatus, CTSNCommon::XBeeConstants::DiscoveryStatus::UNKNOWN_DISCOVERY_STATUS);
}

TEST(XBeeControllerTest, TxStatusPrematureMessageStartTxRetry) {
    std::vector<std::uint8_t> data = {
        CTSNCommon::XBeeConstants::START_CHARACTER,
        0x00,
        0x07,
        CTSNCommon::XBeeConstants::PacketFrame::TRANSMIT_STATUS, // Frame Type - 0x8B
        0x47,   // Frame ID
        0xff,   // Reserved
        0xfe,   // Reserved
        CTSNCommon::XBeeConstants::START_CHARACTER
    };

    std::vector<std::uint8_t> expectedData = data;
    expectedData.pop_back();

    // When callback is called, kill the thread.
    auto killFunc = [&](){m_uut->kill(true);};
    EXPECT_CALL(*m_callbacks, incompleteMessage(expectedData))
        .WillOnce(testing::InvokeWithoutArgs(killFunc));

    m_uut->start();
    m_uut->addData(data);
    m_uut->join();

    // Everything should returm back to the startup state
    CHECK_EQUAL(m_uut->m_dataLength, 0);
    CHECK_EQUAL(m_uut->m_bytesProcessed.size(), 1); // For the new start character
    CHECK_EQUAL(m_uut->m_checkSumTotal, 0);
    CHECK_EQUAL(m_uut->m_payload, "");
    CHECK_EQUAL(m_uut->m_currentState, CTSNCommon::XBeeController::State::MSG_START);
    CHECK_EQUAL(m_uut->m_packetFrame, CTSNCommon::XBeeConstants::PacketFrame::UNKNOWN);
    CHECK_EQUAL(m_uut->m_modemStatus, CTSNCommon::XBeeConstants::ModemStatus::UNKNOWN_STATUS);
    CHECK_EQUAL(m_uut->m_transmitRetryCount, 0);
    CHECK_EQUAL(m_uut->m_txStatus, CTSNCommon::XBeeConstants::TxStatus::UNKNOWN_TX_STATUS);
    CHECK_EQUAL(m_uut->m_discoveryStatus, CTSNCommon::XBeeConstants::DiscoveryStatus::UNKNOWN_DISCOVERY_STATUS);
}

TEST(XBeeControllerTest, TxStatusPrematureMessageStartParseStatus) {
    std::vector<std::uint8_t> data = {
        CTSNCommon::XBeeConstants::START_CHARACTER,
        0x00,
        0x07,
        CTSNCommon::XBeeConstants::PacketFrame::TRANSMIT_STATUS, // Frame Type - 0x8B
        0x47,   // Frame ID
        0xff,   // Reserved
        0xfe,   // Reserved
        0x01,   // Attempts
        CTSNCommon::XBeeConstants::START_CHARACTER
    };

    std::vector<std::uint8_t> expectedData = data;
    expectedData.pop_back();

    // When callback is called, kill the thread.
    auto killFunc = [&](){m_uut->kill(true);};
    EXPECT_CALL(*m_callbacks, incompleteMessage(expectedData))
        .WillOnce(testing::InvokeWithoutArgs(killFunc));

    m_uut->start();
    m_uut->addData(data);
    m_uut->join();

    // Everything should returm back to the startup state
    CHECK_EQUAL(m_uut->m_dataLength, 0);
    CHECK_EQUAL(m_uut->m_bytesProcessed.size(), 1); // For the new start character
    CHECK_EQUAL(m_uut->m_checkSumTotal, 0);
    CHECK_EQUAL(m_uut->m_payload, "");
    CHECK_EQUAL(m_uut->m_currentState, CTSNCommon::XBeeController::State::MSG_START);
    CHECK_EQUAL(m_uut->m_packetFrame, CTSNCommon::XBeeConstants::PacketFrame::UNKNOWN);
    CHECK_EQUAL(m_uut->m_modemStatus, CTSNCommon::XBeeConstants::ModemStatus::UNKNOWN_STATUS);
    CHECK_EQUAL(m_uut->m_transmitRetryCount, 0);
    CHECK_EQUAL(m_uut->m_txStatus, CTSNCommon::XBeeConstants::TxStatus::UNKNOWN_TX_STATUS);
    CHECK_EQUAL(m_uut->m_discoveryStatus, CTSNCommon::XBeeConstants::DiscoveryStatus::UNKNOWN_DISCOVERY_STATUS);
}

TEST(XBeeControllerTest, TxStatusPrematureMessageStartParseDiscovery) {
    std::vector<std::uint8_t> data = {
        CTSNCommon::XBeeConstants::START_CHARACTER,
        0x00,
        0x07,
        CTSNCommon::XBeeConstants::PacketFrame::TRANSMIT_STATUS, // Frame Type - 0x8B
        0x47,   // Frame ID
        0xff,   // Reserved
        0xfe,   // Reserved
        0x01,   // Attempts
        CTSNCommon::XBeeConstants::TxStatus::ROUTE_NOT_FOUND,  // Status - 0x25
        CTSNCommon::XBeeConstants::START_CHARACTER
    };

    std::vector<std::uint8_t> expectedData = data;
    expectedData.pop_back();

    // When callback is called, kill the thread.
    auto killFunc = [&](){m_uut->kill(true);};
    EXPECT_CALL(*m_callbacks, incompleteMessage(expectedData))
        .WillOnce(testing::InvokeWithoutArgs(killFunc));

    m_uut->start();
    m_uut->addData(data);
    m_uut->join();

    // Everything should returm back to the startup state
    CHECK_EQUAL(m_uut->m_dataLength, 0);
    CHECK_EQUAL(m_uut->m_bytesProcessed.size(), 1); // For the new start character
    CHECK_EQUAL(m_uut->m_checkSumTotal, 0);
    CHECK_EQUAL(m_uut->m_payload, "");
    CHECK_EQUAL(m_uut->m_currentState, CTSNCommon::XBeeController::State::MSG_START);
    CHECK_EQUAL(m_uut->m_packetFrame, CTSNCommon::XBeeConstants::PacketFrame::UNKNOWN);
    CHECK_EQUAL(m_uut->m_modemStatus, CTSNCommon::XBeeConstants::ModemStatus::UNKNOWN_STATUS);
    CHECK_EQUAL(m_uut->m_transmitRetryCount, 0);
    CHECK_EQUAL(m_uut->m_txStatus, CTSNCommon::XBeeConstants::TxStatus::UNKNOWN_TX_STATUS);
    CHECK_EQUAL(m_uut->m_discoveryStatus, CTSNCommon::XBeeConstants::DiscoveryStatus::UNKNOWN_DISCOVERY_STATUS);
}


TEST(XBeeControllerTest, TxStatusBadPacket) {
    std::vector<std::uint8_t> data = {
        CTSNCommon::XBeeConstants::START_CHARACTER,
        0x00,
        0x08, // One more than is correct.
        CTSNCommon::XBeeConstants::PacketFrame::TRANSMIT_STATUS, // Frame Type - 0x8B
        // everything else not needed here since we shouldn't get that far.
    };

    // When callback is called, kill the thread.
    auto killFunc = [&](){m_uut->kill(true);};
    EXPECT_CALL(*m_callbacks, badTxStatusPacket(data))
        .WillOnce(testing::InvokeWithoutArgs(killFunc));

    m_uut->start();
    m_uut->addData(data);
    m_uut->join();

    // Everything should returm back to the startup state
    CHECK_EQUAL(m_uut->m_dataLength, 0);
    CHECK_EQUAL(m_uut->m_bytesProcessed.size(), 0);
    CHECK_EQUAL(m_uut->m_checkSumTotal, 0);
    CHECK_EQUAL(m_uut->m_payload, "");
    CHECK_EQUAL(m_uut->m_currentState, CTSNCommon::XBeeController::State::STARTUP);
    CHECK_EQUAL(m_uut->m_packetFrame, CTSNCommon::XBeeConstants::PacketFrame::UNKNOWN);
    CHECK_EQUAL(m_uut->m_modemStatus, CTSNCommon::XBeeConstants::ModemStatus::UNKNOWN_STATUS);

}

////
// Other tests
////
TEST(XBeeControllerTest, invalidPacketFrameTest) {
    std::vector<std::uint8_t> data = {
        CTSNCommon::XBeeConstants::START_CHARACTER,
        0x00,
        0x02,
        CTSNCommon::XBeeConstants::PacketFrame::UNKNOWN,
        // Checksum  and other values not needed here since we shouldn't get that far.
    };

    // When callback is called, kill the thread.
    auto killFunc = [&](){m_uut->kill(true);};
    EXPECT_CALL(*m_callbacks, invalidPacketFrame(CTSNCommon::XBeeConstants::PacketFrame::UNKNOWN))
        .WillOnce(testing::InvokeWithoutArgs(killFunc));

    m_uut->start();
    m_uut->addData(data);
    m_uut->join();

    // Everything should returm back to the startup state
    CHECK_EQUAL(m_uut->m_dataLength, 0);
    CHECK_EQUAL(m_uut->m_bytesProcessed.size(), 0);
    CHECK_EQUAL(m_uut->m_checkSumTotal, 0);
    CHECK_EQUAL(m_uut->m_payload, "");
    CHECK_EQUAL(m_uut->m_currentState, CTSNCommon::XBeeController::State::STARTUP);
    CHECK_EQUAL(m_uut->m_packetFrame, CTSNCommon::XBeeConstants::PacketFrame::UNKNOWN);
    CHECK_EQUAL(m_uut->m_modemStatus, CTSNCommon::XBeeConstants::ModemStatus::UNKNOWN_STATUS);
}
