xforever1313/commutertrackingsensornet/gateway/test/NodeStatusUpdateTest.cpp

#include <stdexcept>

#include <UnitTest.h>

#include "gateway/ErrorEvent.h"
#include "ctsn_common/Node.h"
#include "gateway/NodeStatusUpdateEvent.h"
#include "io/StringLogger.h"
#include "MockEventExecutor.h"
#include "MockMariaDB.h"
#include "MockNodeContainer.h"

TEST_GROUP(GetNodeStatusEventTest) {

    TEST_SETUP() {
        m_eventExecutor = new testing::StrictMock<MockEventExecutor>();
        m_nodes = new testing::StrictMock<CTSNCommon::MockNodeContainer>();
        m_mariadb = new testing::StrictMock<Gateway::MockMariaDB>();
        m_errLogger = new Common::IO::StringLogger();
        m_uut = new Gateway::NodeStatusUpdateEvent(nodeStatus, nodeID,
                                                   m_nodes,
                                                   m_eventExecutor,
                                                   m_mariadb,
                                                   *m_errLogger);

        POINTERS_EQUAL(m_uut->m_nodes, m_nodes);
        POINTERS_EQUAL(m_uut->m_eventExecutor, m_eventExecutor);
        POINTERS_EQUAL(m_uut->m_mariadb, m_mariadb);

        m_node = new CTSNCommon::Node(1, 0x01);
    }

    TEST_TEARDOWN() {
        delete m_uut;
        delete m_errLogger;
        delete m_mariadb;
        delete m_nodes;
        delete m_eventExecutor;
        delete m_node;
    }

    static const CTSNCommon::Node::NodeStatus nodeStatus =
                    CTSNCommon::Node::NodeStatus::OKAY;
    static const unsigned int nodeID = 1;

    CTSNCommon::Node *m_node;

    testing::StrictMock<MockEventExecutor> *m_eventExecutor;
    testing::StrictMock<CTSNCommon::MockNodeContainer> *m_nodes;
    testing::StrictMock<Gateway::MockMariaDB> *m_mariadb;
    Common::IO::StringLogger *m_errLogger;
    Gateway::NodeStatusUpdateEvent *m_uut;
};

TEST(GetNodeStatusEventTest, SuccessTestNoChange) {

    EXPECT_CALL(*m_nodes, setNodeStatus(nodeID, nodeStatus))
        .WillOnce(testing::Return(false));

    m_uut->execute();

    // No error occurred.
    CHECK(m_errLogger->getString().empty());
}

TEST(GetNodeStatusEventTest, SuccessTestOkayChange) {

    EXPECT_CALL(*m_nodes, setNodeStatus(nodeID,
                                        CTSNCommon::Node::NodeStatus::OKAY))
        .WillOnce(testing::Return(true));

    EXPECT_CALL(*m_nodes, getNodeFromID(nodeID))
        .WillOnce(testing::Return(*m_node));

    std::shared_ptr<Common::EventInterface> event = nullptr;
    EXPECT_CALL(*m_eventExecutor, addEvent(testing::_))
        .WillOnce(testing::SaveArg<0>(&event));

    m_uut->execute();

    Gateway::ErrorEvent *errEvent =
        dynamic_cast<Gateway::ErrorEvent*>(event.get());

    CHECK(errEvent != nullptr);

    CHECK_EQUAL(errEvent->m_node.getID(), m_node->getID());
    CHECK_EQUAL(errEvent->m_errorNumber,
                Gateway::ErrorNumber::NODE_IS_NOW_GOOD);

    POINTERS_EQUAL(errEvent->m_mariadb, m_mariadb);

    // No error occurred.
    CHECK(m_errLogger->getString().empty());
}

TEST(GetNodeStatusEventTest, SuccessTestOfflineChange) {
    m_uut->m_status = CTSNCommon::Node::NodeStatus::OFFLINE;

    EXPECT_CALL(*m_nodes, setNodeStatus(nodeID,
                                        CTSNCommon::Node::NodeStatus::OFFLINE))
        .WillOnce(testing::Return(true));

    EXPECT_CALL(*m_nodes, getNodeFromID(nodeID))
        .WillOnce(testing::Return(*m_node));

    std::shared_ptr<Common::EventInterface> event = nullptr;
    EXPECT_CALL(*m_eventExecutor, addEvent(testing::_))
        .WillOnce(testing::SaveArg<0>(&event));

    m_uut->execute();

    Gateway::ErrorEvent *errEvent =
        dynamic_cast<Gateway::ErrorEvent*>(event.get());

    CHECK(errEvent != nullptr);

    CHECK_EQUAL(errEvent->m_node.getID(), m_node->getID());
    CHECK_EQUAL(errEvent->m_errorNumber,
                Gateway::ErrorNumber::NODE_HAS_GONE_OFFLINE);

    POINTERS_EQUAL(errEvent->m_mariadb, m_mariadb);

    // No error occurred.
    CHECK(m_errLogger->getString().empty());
}

TEST(GetNodeStatusEventTest, SuccessTestLowBatteryChange) {
    m_uut->m_status = CTSNCommon::Node::NodeStatus::LOW_BATTERY;

    EXPECT_CALL(*m_nodes, setNodeStatus(nodeID,
                                        CTSNCommon::Node::NodeStatus::LOW_BATTERY))
        .WillOnce(testing::Return(true));

    EXPECT_CALL(*m_nodes, getNodeFromID(nodeID))
        .WillOnce(testing::Return(*m_node));

    std::shared_ptr<Common::EventInterface> event = nullptr;
    EXPECT_CALL(*m_eventExecutor, addEvent(testing::_))
        .WillOnce(testing::SaveArg<0>(&event));

    m_uut->execute();

    Gateway::ErrorEvent *errEvent =
        dynamic_cast<Gateway::ErrorEvent*>(event.get());

    CHECK(errEvent != nullptr);

    CHECK_EQUAL(errEvent->m_node.getID(), m_node->getID());
    CHECK_EQUAL(errEvent->m_errorNumber,
                Gateway::ErrorNumber::NODE_HAS_LOW_BATTERY);

    POINTERS_EQUAL(errEvent->m_mariadb, m_mariadb);

    // No error occurred.
    CHECK(m_errLogger->getString().empty());
}

TEST(GetNodeStatusEventTest, SuccessTestCriticalBatteryChange) {
    m_uut->m_status = CTSNCommon::Node::NodeStatus::BATTERY_CRITICAL;

    EXPECT_CALL(*m_nodes, setNodeStatus(nodeID,
                                        CTSNCommon::Node::NodeStatus::BATTERY_CRITICAL))
        .WillOnce(testing::Return(true));

    EXPECT_CALL(*m_nodes, getNodeFromID(nodeID))
        .WillOnce(testing::Return(*m_node));

    std::shared_ptr<Common::EventInterface> event = nullptr;
    EXPECT_CALL(*m_eventExecutor, addEvent(testing::_))
        .WillOnce(testing::SaveArg<0>(&event));

    m_uut->execute();

    Gateway::ErrorEvent *errEvent =
        dynamic_cast<Gateway::ErrorEvent*>(event.get());

    CHECK(errEvent != nullptr);

    CHECK_EQUAL(errEvent->m_node.getID(), m_node->getID());
    CHECK_EQUAL(errEvent->m_errorNumber,
                Gateway::ErrorNumber::NODE_HAS_CRITICAL_BATTERY);

    POINTERS_EQUAL(errEvent->m_mariadb, m_mariadb);

    // No error occurred.
    CHECK(m_errLogger->getString().empty());
}

TEST(GetNodeStatusEventTest, SuccessTestUnknownChange) {
    m_uut->m_status = CTSNCommon::Node::NodeStatus::UNKNOWN;

    EXPECT_CALL(*m_nodes, setNodeStatus(nodeID,
                                        CTSNCommon::Node::NodeStatus::UNKNOWN))
        .WillOnce(testing::Return(true));

    EXPECT_CALL(*m_nodes, getNodeFromID(nodeID))
        .WillOnce(testing::Return(*m_node));

    std::shared_ptr<Common::EventInterface> event = nullptr;
    EXPECT_CALL(*m_eventExecutor, addEvent(testing::_))
        .WillOnce(testing::SaveArg<0>(&event));

    m_uut->execute();

    Gateway::ErrorEvent *errEvent =
        dynamic_cast<Gateway::ErrorEvent*>(event.get());

    CHECK(errEvent != nullptr);

    CHECK_EQUAL(errEvent->m_node.getID(), m_node->getID());
    CHECK_EQUAL(errEvent->m_errorNumber,
                Gateway::ErrorNumber::NODE_HAS_UNKNOWN_STATUS);

    POINTERS_EQUAL(errEvent->m_mariadb, m_mariadb);

    // No error occurred.
    CHECK(m_errLogger->getString().empty());
}

TEST(GetNodeStatusEventTest, SuccessTestUncommonChange) {
    m_uut->m_status = CTSNCommon::Node::NodeStatus::DOWN;

    EXPECT_CALL(*m_nodes, setNodeStatus(nodeID,
                                        CTSNCommon::Node::NodeStatus::DOWN))
        .WillOnce(testing::Return(true));

    EXPECT_CALL(*m_nodes, getNodeFromID(nodeID))
        .WillOnce(testing::Return(*m_node));

    std::shared_ptr<Common::EventInterface> event = nullptr;
    EXPECT_CALL(*m_eventExecutor, addEvent(testing::_))
        .WillOnce(testing::SaveArg<0>(&event));

    m_uut->execute();

    Gateway::ErrorEvent *errEvent =
        dynamic_cast<Gateway::ErrorEvent*>(event.get());

    CHECK(errEvent != nullptr);

    CHECK_EQUAL(errEvent->m_node.getID(), m_node->getID());
    CHECK_EQUAL(errEvent->m_errorNumber,
                Gateway::ErrorNumber::NODE_HAS_UNCOMMON_STATUS);

    POINTERS_EQUAL(errEvent->m_mariadb, m_mariadb);

    // No error occurred.
    CHECK(m_errLogger->getString().empty());
}

TEST(GetNodeStatusEventTest, outOfRangeFailure) {
    std::string error = "error";

    EXPECT_CALL(*m_nodes, setNodeStatus(nodeID, nodeStatus))
        .WillOnce(testing::Throw(std::out_of_range(error)));

    m_uut->execute();

    // Error logged.
    CHECK(m_errLogger->getString().find(error) != std::string::npos);
}

TEST(GetNodeStatusEventTest, invalidArgFailure) {
    std::string error = "error";

    EXPECT_CALL(*m_nodes, setNodeStatus(nodeID, nodeStatus))
        .WillOnce(testing::Throw(std::invalid_argument(error)));

    m_uut->execute();

    // Error logged.
    CHECK(m_errLogger->getString().find(error) != std::string::npos);
}

TEST(GetNodeStatusEventTest, runtimeErrorFailure) {
    std::string error = "error";

    EXPECT_CALL(*m_nodes, setNodeStatus(nodeID, nodeStatus))
        .WillOnce(testing::Throw(std::runtime_error(error)));

    m_uut->execute();

    // Error logged.
    CHECK(m_errLogger->getString().find(error) != std::string::npos);
}
