xforever1313/commutertrackingsensornet/pi_node/test/StatusLedTest.cpp

#include "UnitTest.h"

#include "MockGPIOController.h"
#include "io/StringLogger.h"
#include "pi_node/StatusLed.h"

TEST_GROUP(StatusLEDTest) {
    TEST_SETUP() {
        m_pinNumber = 10;
        m_delay = 10;
        m_gpio = new testing::StrictMock<CTSNCommon::MockGPIOController> ();
        m_errLogger = new Common::IO::StringLogger();
        m_uut = new PiNode::StatusLed(m_pinNumber, m_delay, *m_gpio, *m_errLogger);

        CHECK(!m_uut->isShutdown());
        CHECK_EQUAL(m_uut->m_pinNumber, m_pinNumber);
        CHECK_EQUAL(m_uut->m_delay, m_delay);
    }

    TEST_TEARDOWN() {
        delete m_uut;
        delete m_gpio;
        delete m_errLogger;
    }

    unsigned int m_pinNumber;
    unsigned int m_delay = 10;

    testing::StrictMock<CTSNCommon::MockGPIOController> *m_gpio;
    Common::IO::StringLogger *m_errLogger;
    PiNode::StatusLed *m_uut;
};

TEST(StatusLEDTest, runTest) {
    auto killFunc = [&](){m_uut->kill();};

    testing::InSequence dummy;

    EXPECT_CALL(*m_gpio, set(1, m_pinNumber));
    EXPECT_CALL(*m_gpio, set(0, m_pinNumber));
    EXPECT_CALL(*m_gpio, set(1, m_pinNumber));
    EXPECT_CALL(*m_gpio, set(0, m_pinNumber))
        .WillOnce(testing::InvokeWithoutArgs(killFunc));

    m_uut->run();

    CHECK(m_uut->isShutdown());
}

TEST(StatusLEDTest, failTest) {
    std::string error = "Error";

    EXPECT_CALL(*m_gpio, set(1, m_pinNumber))
        .WillOnce(testing::Throw(std::runtime_error(error)));

    m_uut->run();

    CHECK(m_uut->isShutdown());
    CHECK(m_errLogger->getString().find(error) != std::string::npos);
}
