xforever1313/commutertrackingsensornet/gateway/test/include/MockHTTPPoster.h

#ifndef MOCK_HTTP_POSTER_H_
#define MOCK_HTTP_POSTER_H_

#include <gmock/gmock.h>
#include <string>

#include "gateway/HTTPPosterInterface.h"

namespace Gateway {

class MockHTTPPoster : public HTTPPosterInterface {
    public:
        virtual ~MockHTTPPoster(){}

        MOCK_METHOD3(post, void(const std::string &url,
                                const std::string &data,
                                short port));
};

}

#endif
