xforever1313/commutertrackingsensornet/common/test/src/MockLinux.cpp

#include <cstring>

#include "MockLinux.h"

namespace MockLinux {

int openReturn = 0;
int readReturn = 0;
int writeReturn = 0;
int closeReturn = 0;
void *readReturnBuffer = nullptr;

int open (const char *c, int flags) {
    return openReturn;
}

size_t write (int file, const void *buffer, size_t bytes) {
    return writeReturn;
}

size_t read (int file, void *buffer, size_t bytes) {
    if (readReturnBuffer != nullptr) {
        //Actual read will return the number of bytes returned, so
        //copy that number of bytes into the buffer.
        std::memcpy(buffer, readReturnBuffer, readReturn);
    }

    return readReturn;
}

int close(int file) {
    return closeReturn;
}

}
