xforever1313/commutertrackingsensornet/(commit log)

2014-06-14 Began working on the pi's uart interface.
2014-06-15 Finished the UART interface with Linux.
2014-06-15 Renamed PiUart to Uart.h.
    Renamed the implementation to LinuxUart.cpp
2014-06-15 Added a UartTXEvent.
2014-06-15 Added Uart Receive Thread!
2014-06-15 Right now, uart does work... but there are problems.
    1. For some reason, cin gets kicked out.
    2. For some other reason, RxMessages are not together.
    [Gateway.cpp, GatewayTest.cpp, LinuxUart.cpp, UartTxEvent.cpp, main.cpp]
2014-06-15 Fixed (Hacked around) the strange behavior where if a UartRXEvent happens, it kicks out std::cin
    The fix is that if cin fails, then clear the fail bit, and try again.
    This will probably need to be fixed at some point, especially since there will be random Rx's from the field, but for now....
    [Gateway.cpp]
2014-06-23 Added a stub for WindowsUart so development can occur on windows
    UART does not work on windows yet, so trying to do so will print out "Not implemented yet"
    [LinuxUart.cpp, LinuxUartTest.cpp]
2014-06-25 Created an EmailEvent class
    This will send an email to us when something goes horribly wrong.
    Also, added keys.py to the ignore list. This file should never ever ever ever ever be commited.
    [EmailEvent.cpp, EmailEventTest.cpp, Emailer.cpp, MockEmailer.h]
2014-07-13 Made the Uart not deadlock.
2014-07-16 Added shutdown interface, so the program can shutdown from any thread.
2014-07-18 Added command port!!! :D
    But, std::cion is not working. May need to ditch it.
    [Gateway.cpp]
2014-07-20 Fixed a memory leak in Gateway (forgot to delete socket.)
    [Gateway.cpp]
2014-08-05 Added HTTP handler for sending a UartTX Message.
2014-08-25 Added a script that will enable the UART port on a pi.
2014-08-28 Gateway now prints version information during startup.
2014-09-07 Made the status page print out a timestamp of when it was updated last.
2014-09-11 Gateway now calls mariadb.
    If on another machine that is not the pi, you must be connected to the router, or it will not work.
    [Gateway.cpp]
2014-09-12 Added a LogEvent, which will insert an error number into the error log database table.
    [LogEvent.cpp, LogEventTest.cpp, MariaDBWrapper.cpp, MockMariaDB.h]
2014-09-12 Plugged in the log message http handler into the rest of the gateway program.
    Note, there is a memory leak somewhere in mariadb. Working to fix that now.
    [Gateway.cpp, HTTPRequestFactory.cpp, HTTPRequestFactoryTest.cpp]
2014-09-12 Fixed a memory leak when using mariadb.
    [main.cpp]
2014-09-19 Started the ErrorEvent stuff.
    Commiting so I dont lose things.
    [ErrorEvent.cpp, ErrorEventTest.cpp, MariaDBWrapper.cpp, MockMariaDB.h]
2014-09-19 Added to the ErrorEvent the text message event setup.
    [ErrorEvent.cpp, ErrorEventTest.cpp, TextMessageEvent.cpp, TextMessageEventTest.cpp]
2014-09-19 Finished the ErrorEvent.
    Time to add the HTTP handler for it now!
    [ErrorEvent.cpp, ErrorEventTest.cpp]
2014-09-20 Moved the "Convert string to error message" function to a more common area.
    [ErrorNumbers.cpp, ErrorNumbersTest.cpp, LogMessageHTTPRequestHandler.cpp, LogMessageHTTPRequestHandlerTest.cpp]
2014-09-20 Added the handler for error messages.
    [ErrorHTTPRequestHandler.cpp, ErrorHTTPRequestHandlerTest.cpp]
2014-09-20 Got the http handler plugged in, but there are bugs to fix. YAY!
    [HTTPRequestFactory.cpp, HTTPRequestFactoryTest.cpp]
2014-09-21 We can now send error messages from people in the database
    YAY!!!!
    [ErrorEvent.cpp, ErrorEventTest.cpp, MariaDBWrapper.cpp]
2014-09-22 All error loggings now have a timestamp in front of them.
    [EmailEvent.cpp, EmailEventTest.cpp, ErrorEvent.cpp, ErrorEventTest.cpp, Gateway.cpp, LogEvent.cpp, LogEventTest.cpp, TextMessageEvent.cpp]
2014-09-26 Got the stats page done
    Added tables to both map pages in case of no JS.
2014-10-06 Added the DatabsePokeEvent.
    When this runs, it does a simple query to prevent MariaDB from going down.
    [DatabasePokeEvent.cpp, DatabasePokeEventTest.cpp]
2014-10-06 Added a store result to DatabasePokeEvent
    This prevents "Commands out of sync; you can't run this command now" errors
    [DatabasePokeEvent.cpp, DatabasePokeEventTest.cpp]
2014-10-10 Added a button on the website to enable or disable maintenance mode.
2014-10-14 Added script to turn on pin 23 of the raspberry pi.
2014-10-16 Added support to read binary data from the uart.
    Added more test cases to LinuxUartTest
2014-10-16 Made it so uart now reads binary data, not strings.
    UART_RX> Will not longer be printed on teh Gateway's output console.
2014-10-17 Got the XBeeController state machine to go through a successful case.
    Now to add cases when things blow up!.
2014-10-20 Started the XBeecontroller in the main thread.
    It is receiving SOME characters from the XBee, but not all of them...
    On to debuggin!
2014-10-24 Refactoring:
    NodeContainer class added that will keep track of all the nodes for us.
    Moved functions from node to NodeContainer
    Nodes are no longer unsigneed ints, but Node Objects.
    [ErrorEvent.cpp, ErrorEventTest.cpp, ErrorHTTPRequestHandler.cpp, ErrorHTTPRequestHandlerTest.cpp, LogEvent.cpp, LogEventTest.cpp]
2014-11-06 Fixed the bug that caused the program to hang during teardown.
    [UartRecvThread.cpp]
2014-11-08 Make it so leaflet.js is served from our server, not their own (in case theirs goes down or something)
2014-11-14 Got the node check event working in unit test land.
    Now need to test error cases.
    [NodeCheckEvent.cpp, NodeCheckEventTest.cpp]
2014-11-14 Added error cases for the NodeCheckEvent.
    [NodeCheckEvent.cpp, NodeCheckEventTest.cpp]
2014-11-16 NodeStatusUpdate takes in a mariadb pointer so it can create error events.
    [HTTPRequestFactory.cpp, HTTPRequestFactoryTest.cpp, NodeCheckEventTest.cpp, NodeStatusUpdateEvent.cpp, NodeStatusUpdateHTTPRequestHandler.cpp]
2014-11-24 Added a fail case for the picture parse event.
    [PictureParseEvent.cpp]
2014-11-24 Fixed the post requests in the picture parser
    [PictureParseEvent.cpp]
2014-11-30 May have fixed the 255 character limit problem. Guess we'll find out.
    [PictureParseEvent.cpp]
2014-12-01 Reduced the number of http threads the gateway does to 1
2014-12-01 Reducded the number of http threads to 1
2014-12-01 Fixed the crash.
    It was a queue problem, but not the XBees. For somereason, we would get into a state where the queue in our code was empty, and popping an empty queue is bad and undefined behavior.
    [Gateway.cpp, XBeeController.cpp]
2014-12-01 Pi Node owns a uart object.
2014-12-11 Fixed the unit tests for ctsn common so they actually run.
    [LinuxUartTest.cpp, MockLinux.cpp]
2015-01-24 UArt Recv thread now uses a condition variable instead of a semaphore.
2015-01-24 Removed the impl for uart recv thread now that we use a condition variable instead of a semaphore in it.
2015-01-30 Added a GPIO Controller for the raspberry pi.
2015-01-31 Plugged the status led into the pi node.
2015-01-31 Added a script which turns on the pi node's led
2015-01-31 Fixed a bug where we were accidently trying to write to the direction of the gpio, not the value.
    Fixed now.
    [PiGPIOController.cpp]
2015-02-03 Added the battery check event.
2015-02-05 Added a battery check http request handler.
2015-02-05 Plugged in the battery check event.
2015-02-08 Removed all traces of Secrets.py from gateway.
2015-02-08 Updated main.cpp to print settings.
2015-02-09 The pi node now prints out its settings at startup
    Fixed a bug in NodeContainer. It should have down stoul, not stoi
    [NodeContainer.cpp, PiNode.cpp, main.cpp]
2015-02-27 Added HTTPPoster test Fixture.
    [HTTPPoster.cpp]
2015-03-04 The Fixture setup now turns on the pi node, the fixture teardown stops it.
    TODOS: Do it for the gateway, try it without the threads, and add settings.
    [HTTPPoster.cpp]
